iliasam/OpenTOFLidar/Mechanical/README.md

"NoMirrorConceptPictures" - Pictures showing Lidar concept without Scanning Mirror. Based on my OpenSimpleLidar mechanics.
