iliasam/OpenTOFLidar/PC_Utility/Readme.md

"LidarTestingUtility" - utility for Lidar configuration.  
Could be used in non-scanning and scanning modes.  
  
"LidarScanningTest" - utility for displaying scans from the Lidar (for scanning mode only).
  
See wiki for more information.  
  
Both utilities are written at C# in Visual Studio 2017.  
See "Debug" folder for binaries.
