iliasam/OpenTOFLidar/Mechanical/3D/Readme.txt

It is better to place cylindrical part of the "mirror holder" at the top. 
It is needed for better printing hole for the motor.
