iliasam/OpenTOFLidar/Images/distance_histogram/Readme.md

**Testing scanning measurements quality**  
All these measurements were captured with "PCB_project_v4".  
Laser voltage: 16V  
APD voltage: 130V  
Comparator : 50mv
