iliasam/OpenTOFLidar/Images/APD_voltage_vs_PWM.png

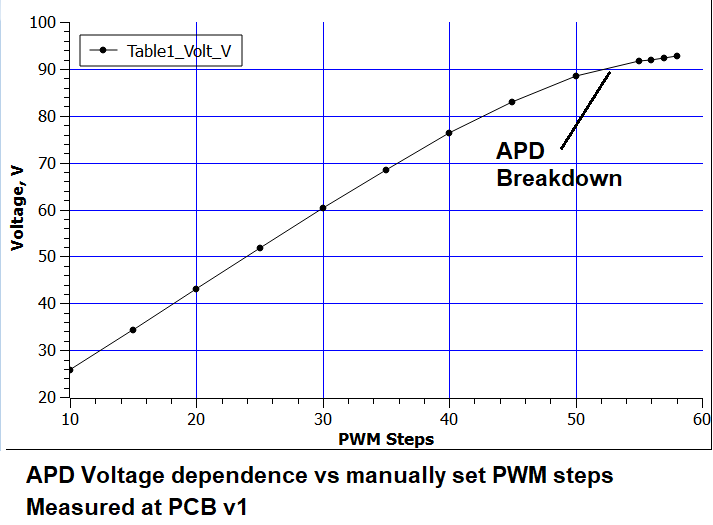
Images/APD_voltage_vs_PWM.png
