iliasam/OpenTOFLidar/Images/DataProcessing.png

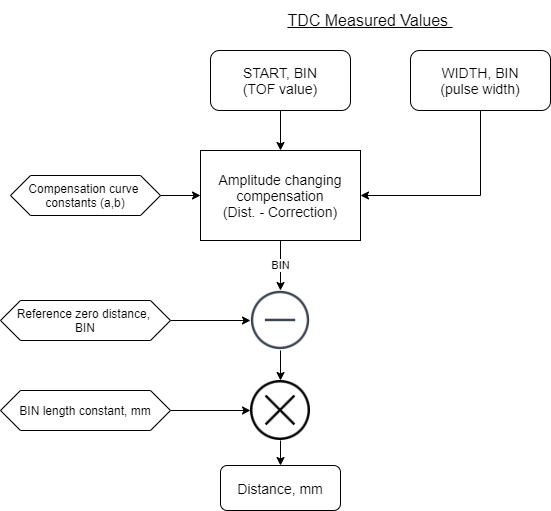
Images/DataProcessing.png
