iliasam/OpenTOFLidar/Images/distance_histogram/A1_10m.png

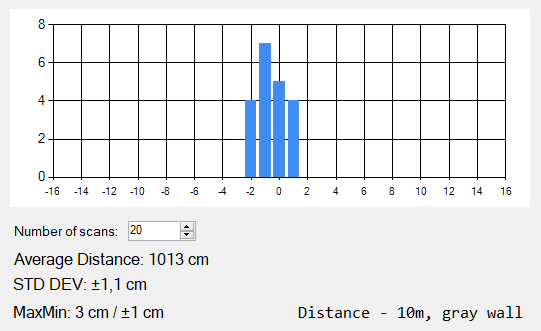
Images/distance_histogram/A1_10m.png
