iliasam/OpenTOFLidar/Images/distance_histogram/A2_20m.png

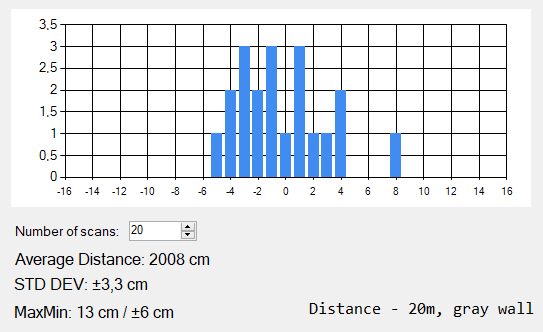
Images/distance_histogram/A2_20m.png
