iliasam/OpenTOFLidar/Images/distance_histogram/A3_25m.png

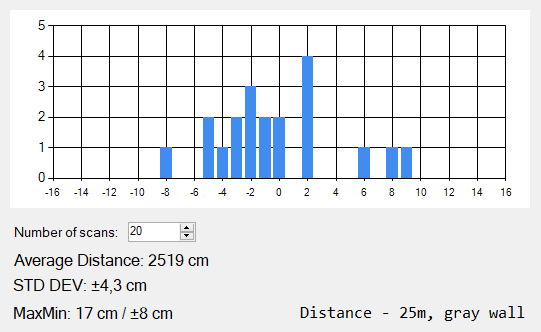
Images/distance_histogram/A3_25m.png
