iliasam/OpenTOFLidar/Images/distance_histogram/A4_27m.png

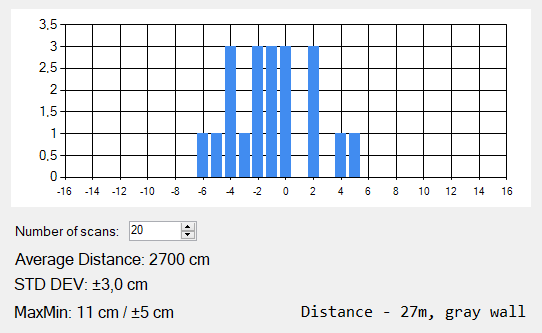
Images/distance_histogram/A4_27m.png
