iliasam/OpenTOFLidar/Images/distance_histogram/A6_30m.png

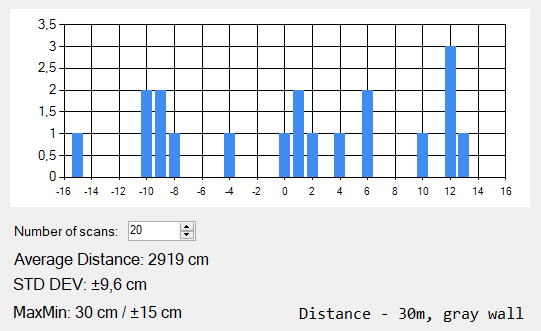
Images/distance_histogram/A6_30m.png
