iliasam/OpenTOFLidar/Images/distance_histogram/A9_13m.png

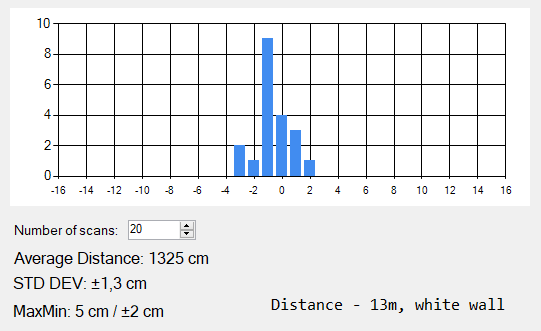
Images/distance_histogram/A9_13m.png
