iliasam/OpenTOFLidar/Images/NoiseLevel.png

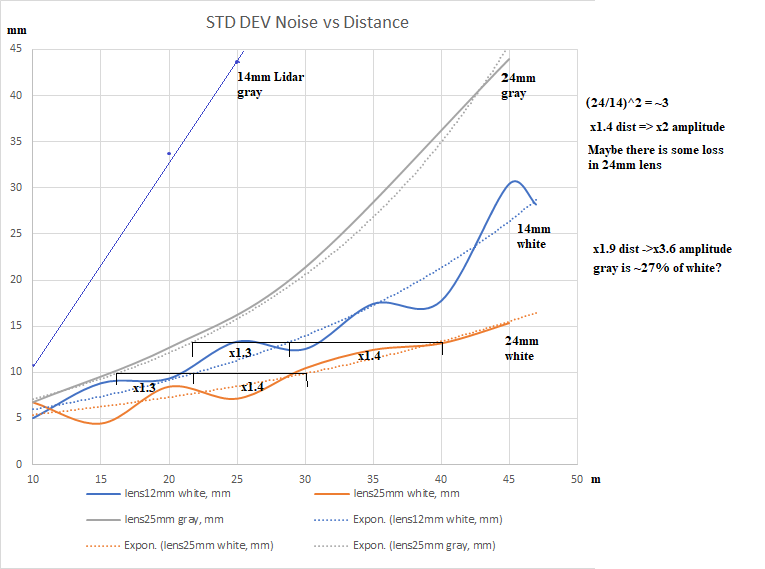
Images/NoiseLevel.png
