iliasam/OpenTOFLidar/Images/Oscilloscope/laser_transistor_gate.png

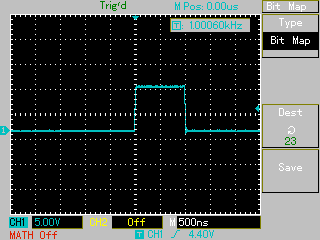
Images/Oscilloscope/laser_transistor_gate.png
