iliasam/OpenTOFLidar/Images/Oscilloscope/laser_transistor_source.png

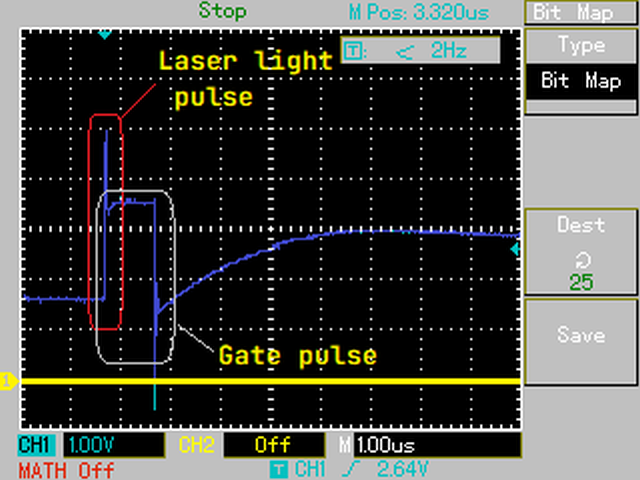
Images/Oscilloscope/laser_transistor_source.png
