iliasam/OpenTOFLidar/Images/Oscilloscope/LaserCurrent.png

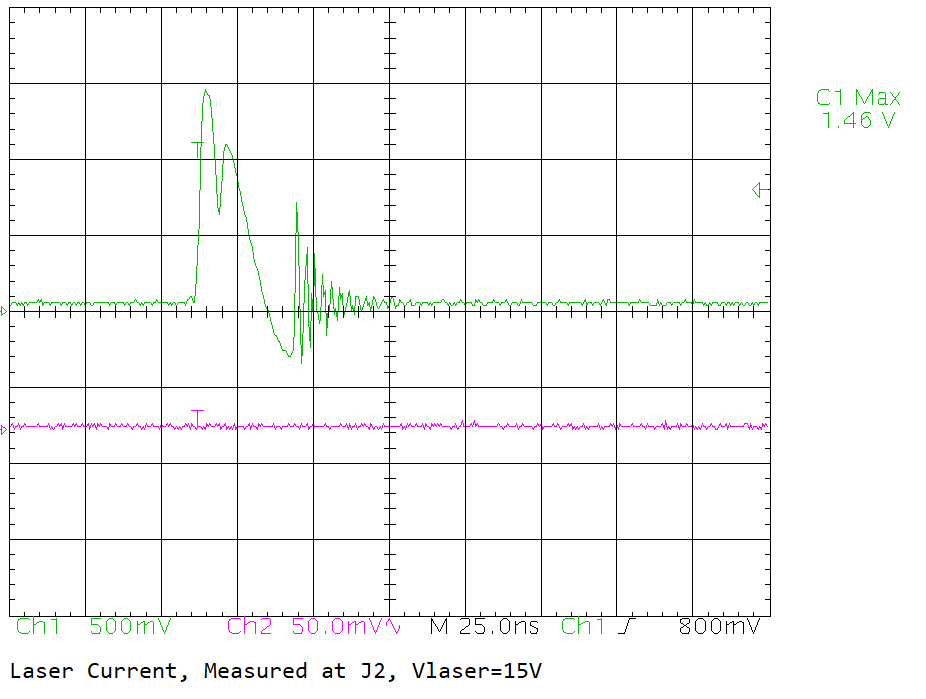
Images/Oscilloscope/LaserCurrent.png
