iliasam/OpenTOFLidar/Images/Oscilloscope/LaserCurrent/LaserV_10V.gif

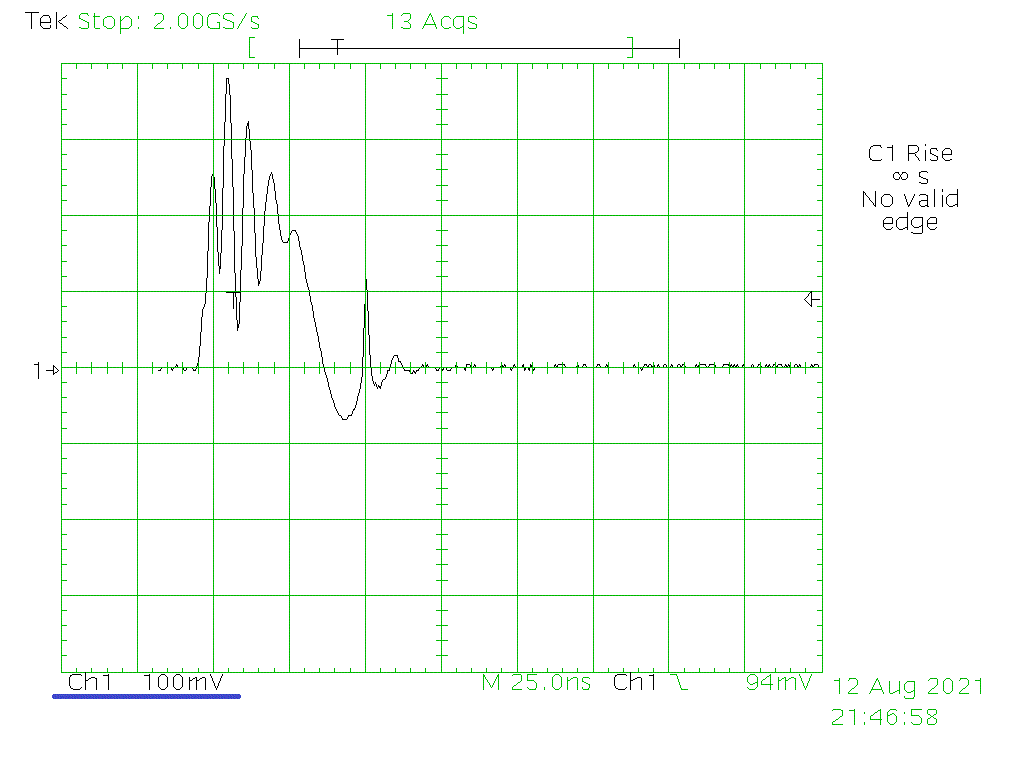
Images/Oscilloscope/LaserCurrent/LaserV_10V.gif
