iliasam/OpenTOFLidar/Images/Oscilloscope/LaserCurrent/LaserV_12V.gif

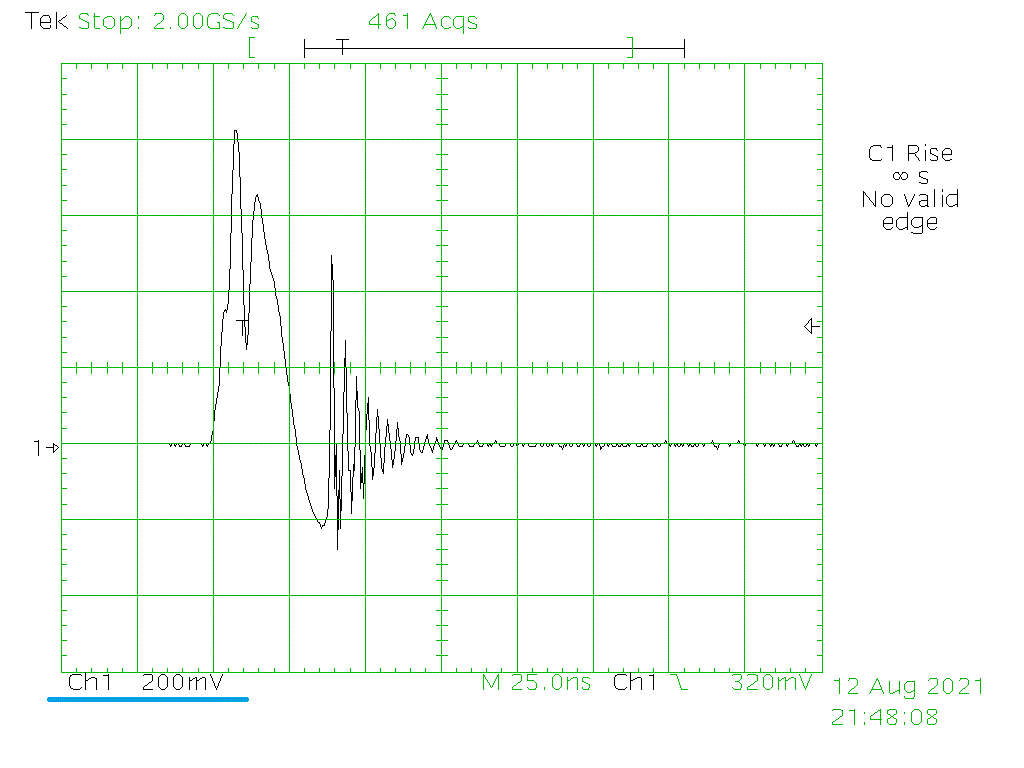
Images/Oscilloscope/LaserCurrent/LaserV_12V.gif
