iliasam/OpenTOFLidar/Images/Oscilloscope/LaserCurrent/LaserV_14V.gif

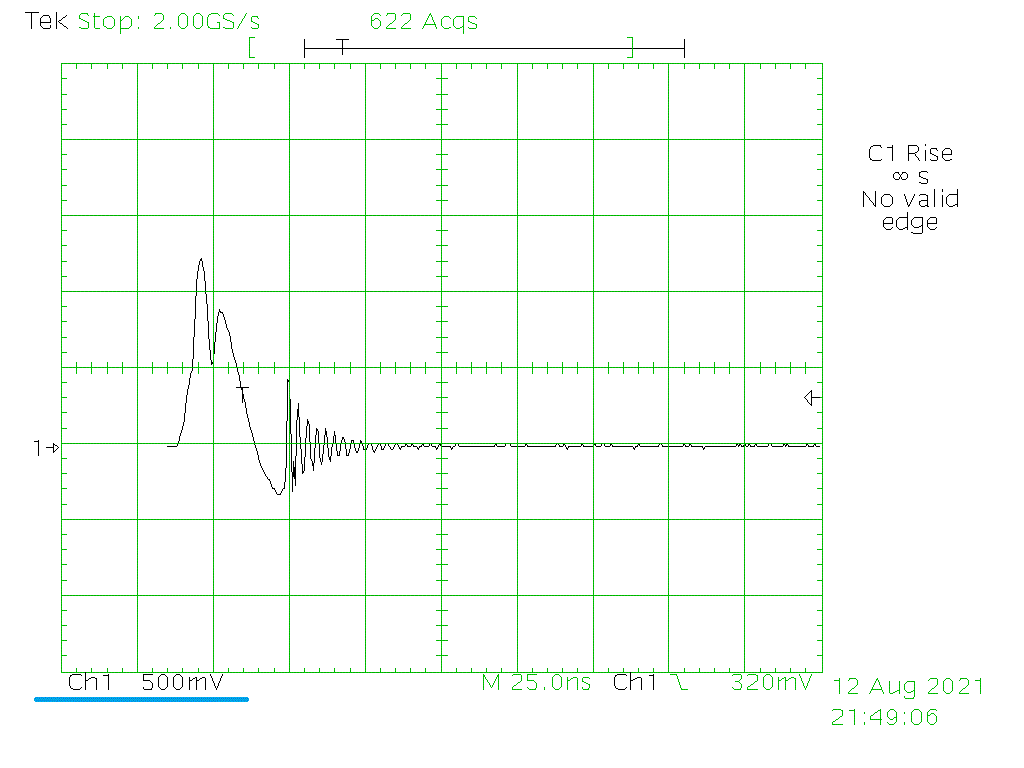
Images/Oscilloscope/LaserCurrent/LaserV_14V.gif
