iliasam/OpenTOFLidar/Images/Oscilloscope/LaserSignal.png

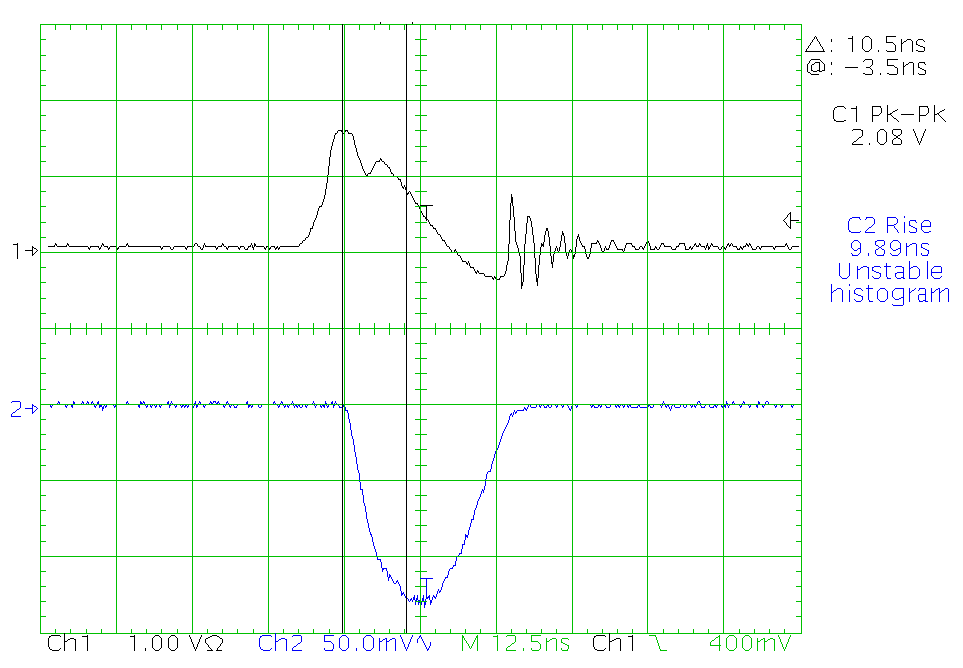
Images/Oscilloscope/LaserSignal.png
