iliasam/OpenTOFLidar/Images/Oscilloscope/ProbeCompare/DSO 015.BMP

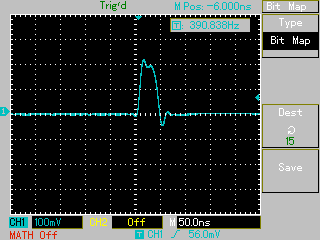
Images/Oscilloscope/ProbeCompare/DSO 015.BMP
