iliasam/OpenTOFLidar/Images/Oscilloscope/ProbeCompare/DSO 016.BMP

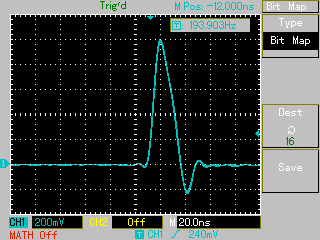
Images/Oscilloscope/ProbeCompare/DSO 016.BMP
