iliasam/OpenTOFLidar/Images/Oscilloscope/ProbeCompare/TEK00012.gif

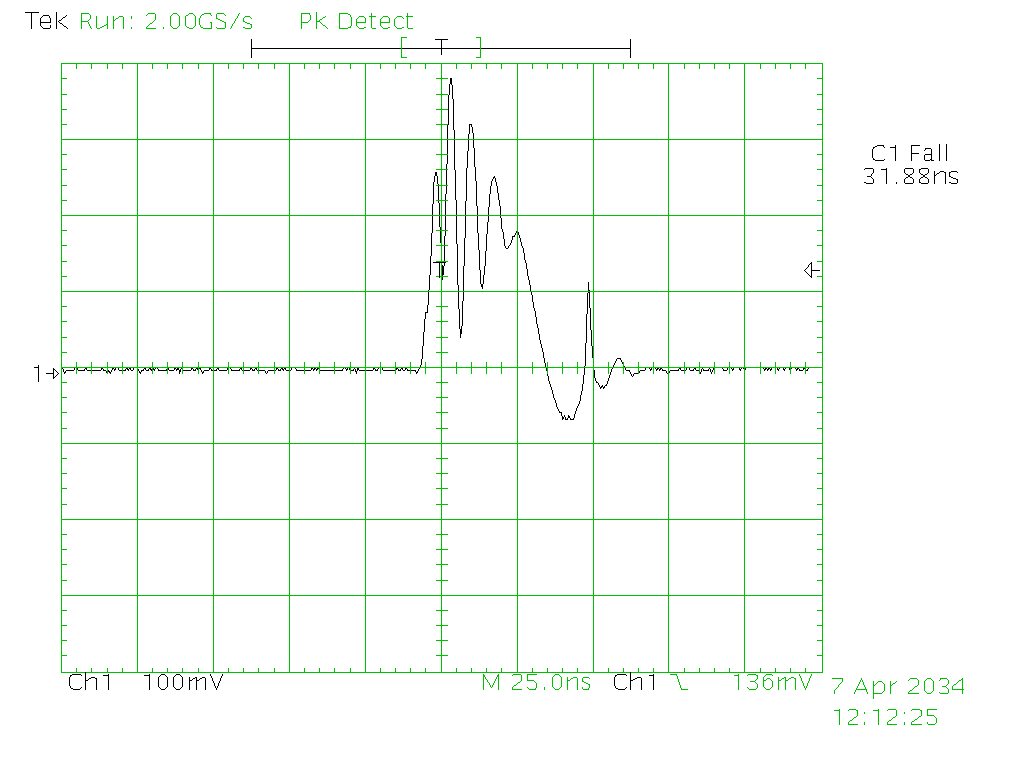
Images/Oscilloscope/ProbeCompare/TEK00012.gif
