iliasam/OpenTOFLidar/Images/Oscilloscope/ProbeCompare/TEK00013.gif

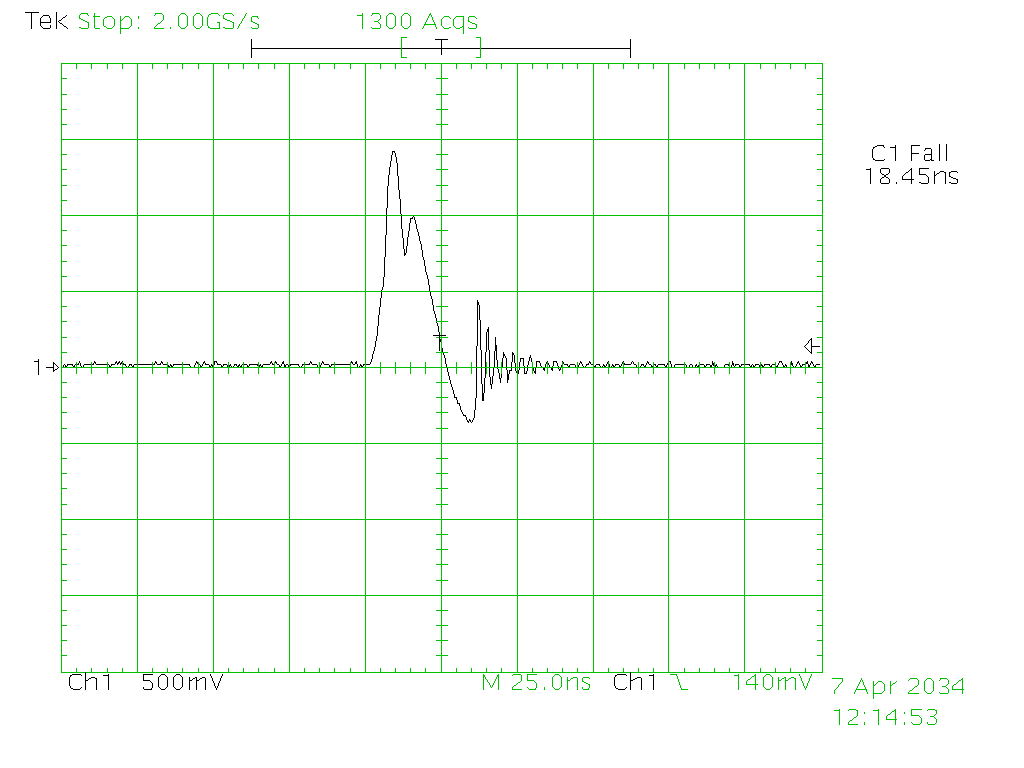
Images/Oscilloscope/ProbeCompare/TEK00013.gif
