iliasam/OpenTOFLidar/Images/Oscilloscope/ProbeCompare/TEK00014.gif

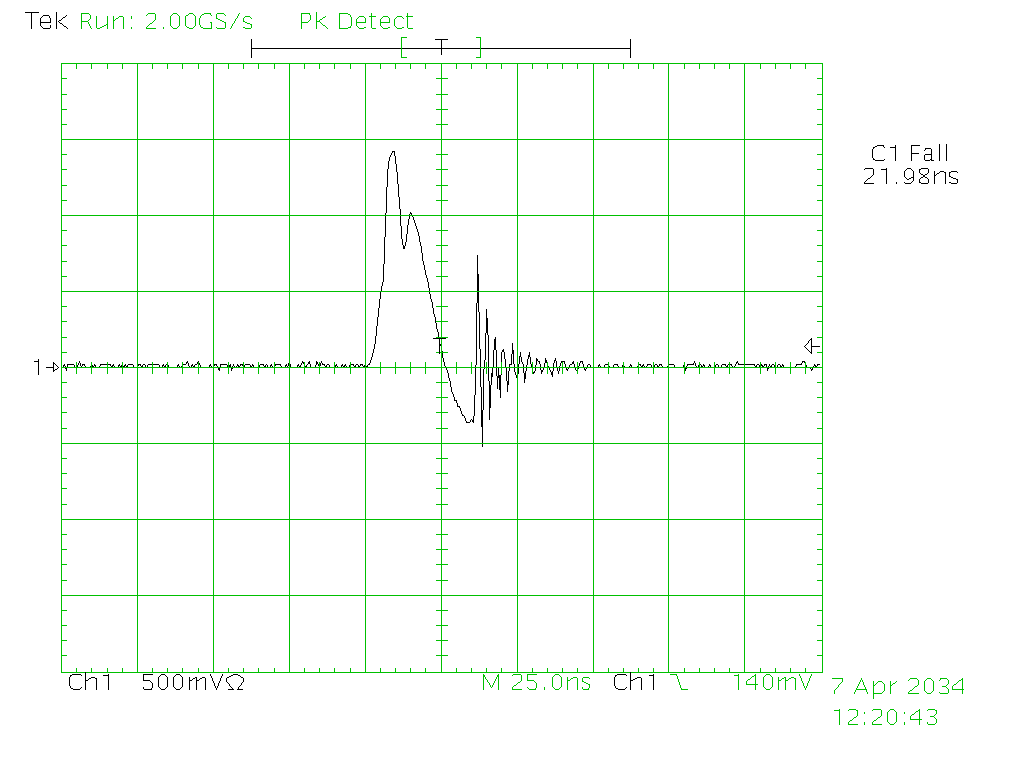
Images/Oscilloscope/ProbeCompare/TEK00014.gif
