iliasam/OpenTOFLidar/Mechanical/Drawing1.png

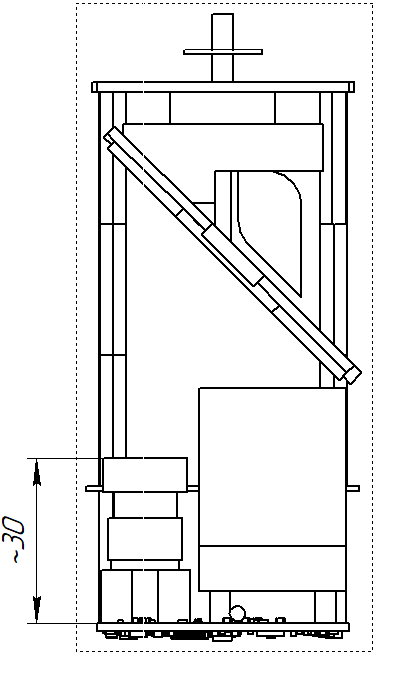
Mechanical/Drawing1.png
