iliasam/OpenTOFLidar/Mechanical/Mirror/mirror_drawing.png

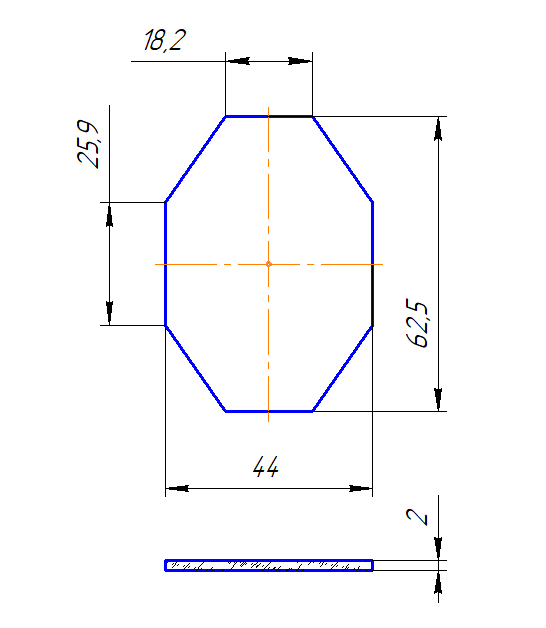
Mechanical/Mirror/mirror_drawing.png
