iliasam/OpenTOFLidar/Mechanical/MotorPlate/Drawing_motor_plate.png

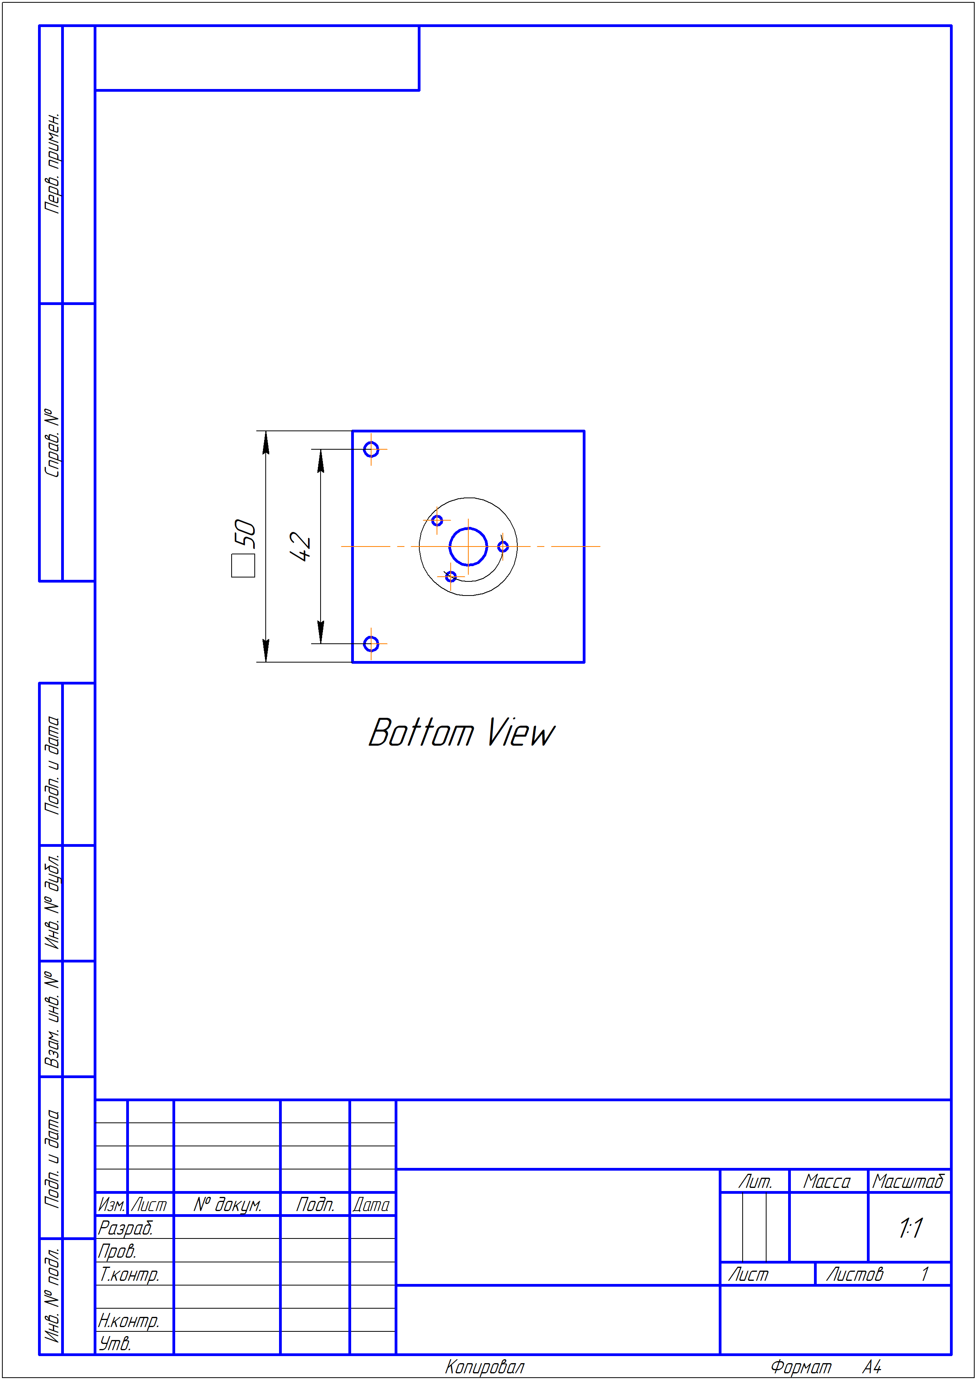
Mechanical/MotorPlate/Drawing_motor_plate.png
