iliasam/OpenTOFLidar/Mechanical/NoMirrorConceptPictures/pict1.png

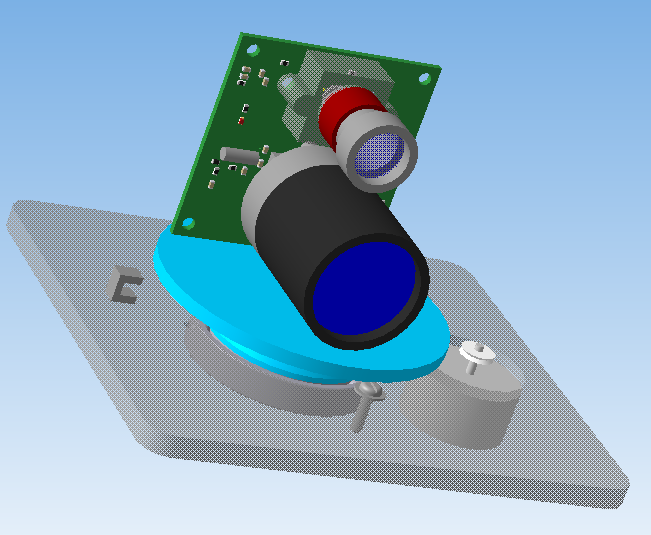
Mechanical/NoMirrorConceptPictures/pict1.png
