iliasam/OpenTOFLidar/Mechanical/NoMirrorConceptPictures/pict2.png

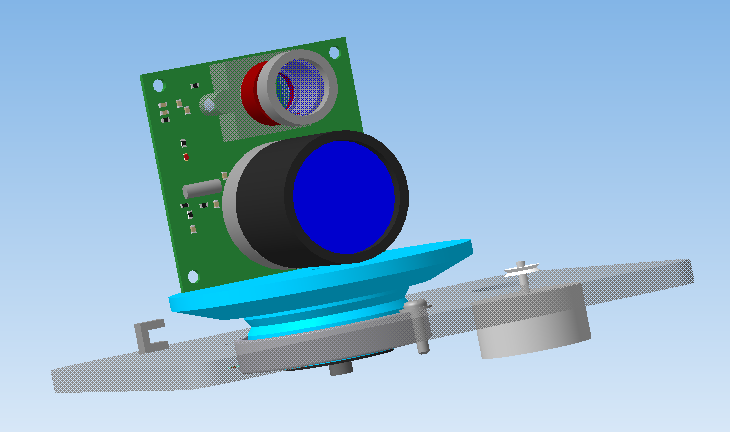
Mechanical/NoMirrorConceptPictures/pict2.png
