iliasam/OpenTOFLidar/Mechanical/NoMirrorConceptPictures/pict3.png

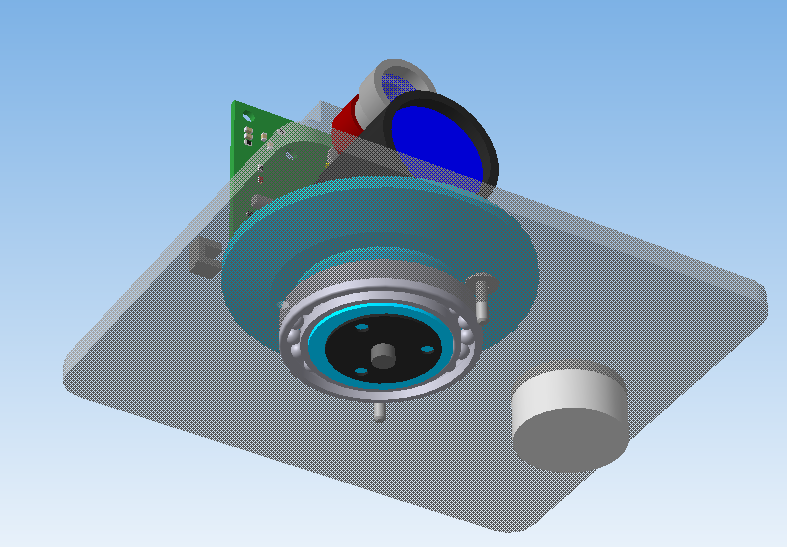
Mechanical/NoMirrorConceptPictures/pict3.png
