iliasam/OpenTOFLidar/Mechanical/NoMirrorConceptPictures/pict4.png

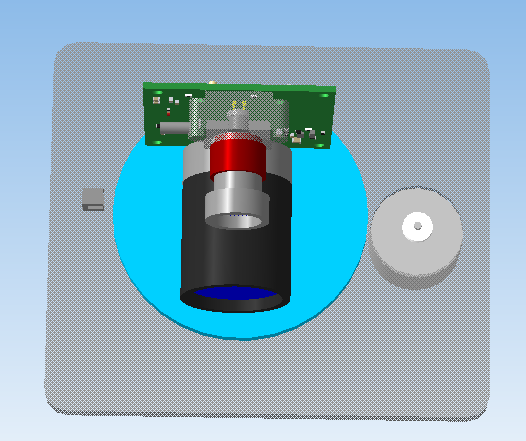
Mechanical/NoMirrorConceptPictures/pict4.png
