iliasam/OpenTOFLidar/Mechanical/RenderPicture1.png

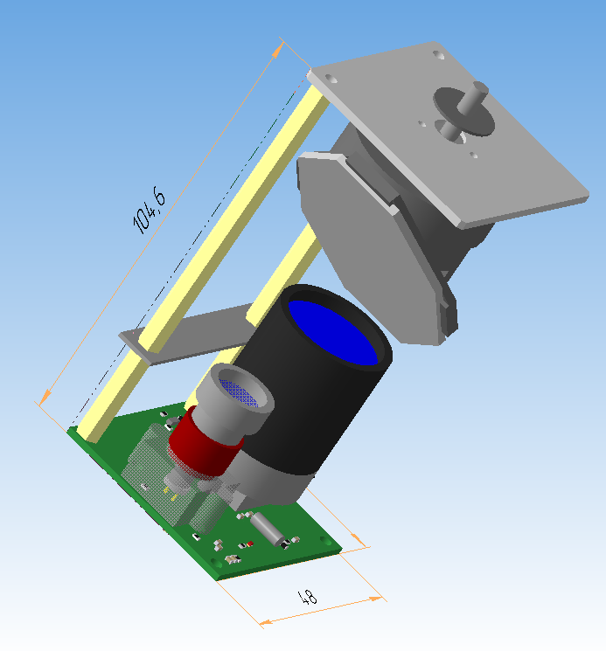
Mechanical/RenderPicture1.png
