iliasam/OpenTOFLidar/Mechanical/RenderPicture2.png

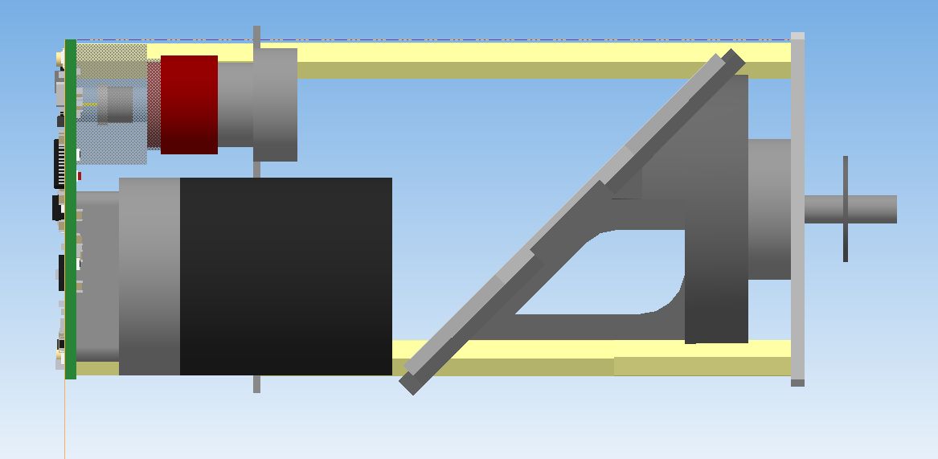
Mechanical/RenderPicture2.png
