iliasam/OpenTOFLidar/Mechanical/RenderPicture3.png

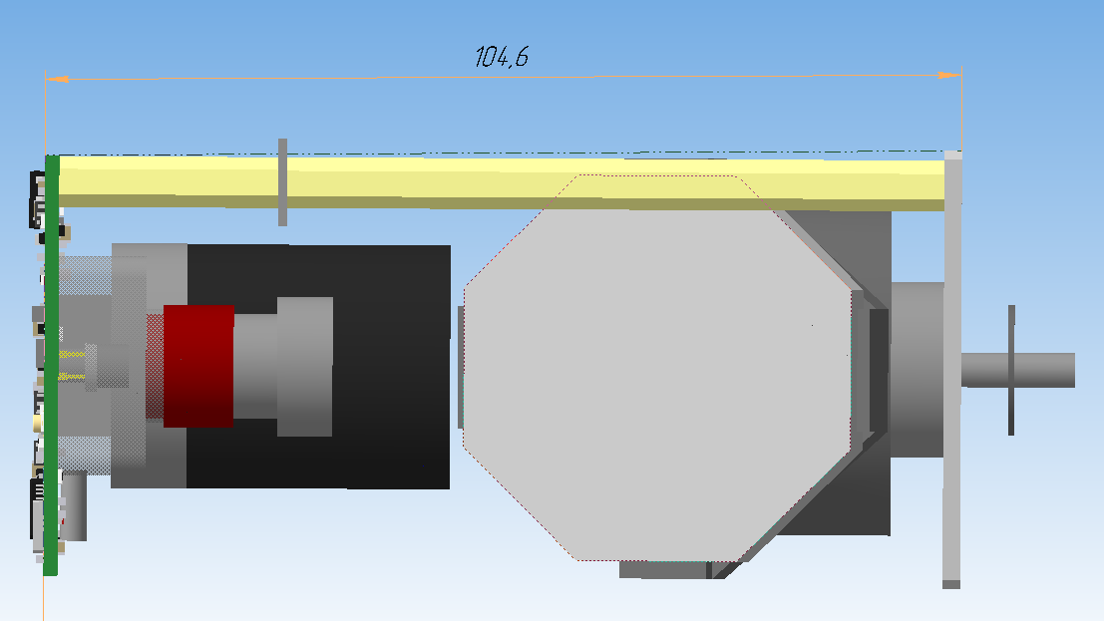
Mechanical/RenderPicture3.png
