iliasam/OpenTOFLidar/Mechanical/RenderPicture4.png

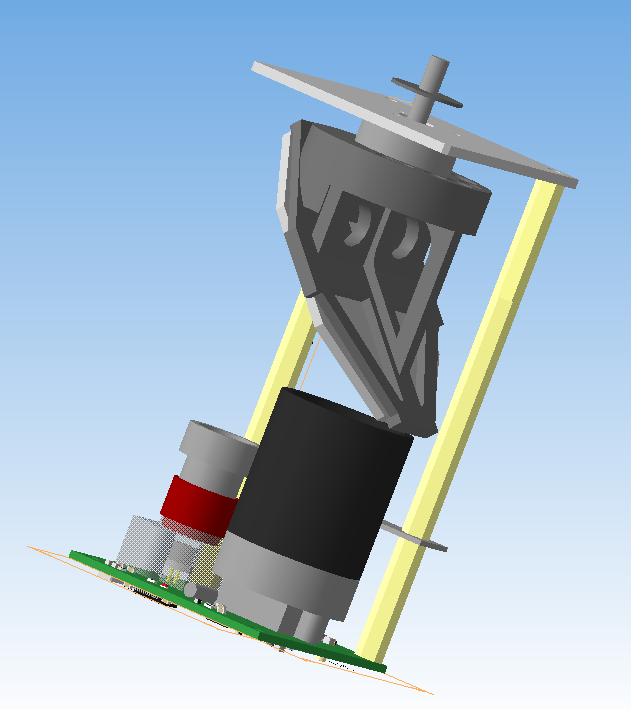
Mechanical/RenderPicture4.png
