iliasam/OpenTOFLidar/Mechanical/RenderPicture5.png

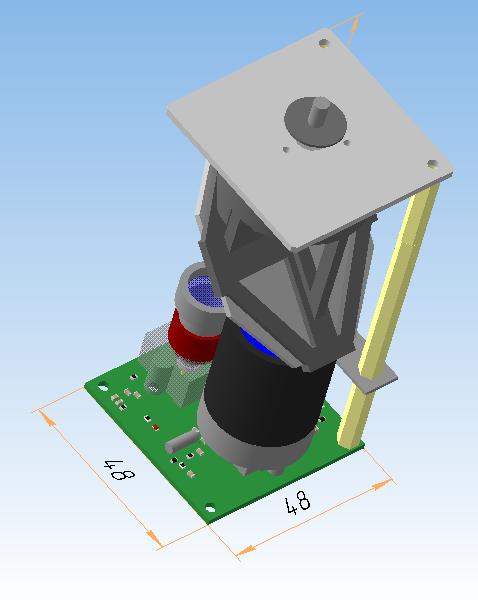
Mechanical/RenderPicture5.png
