iliasam/OpenTOFLidar/PC_Utility/scanning_utility_screen.png

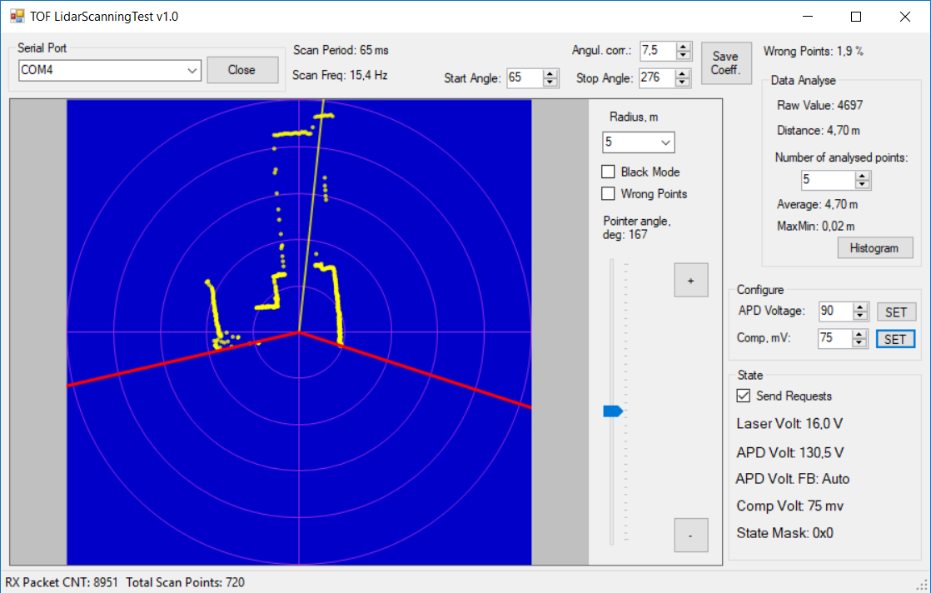
PC_Utility/scanning_utility_screen.png
