iliasam/OpenTOFLidar/PCB/PCB_project_v4/PCB_3D_view_down.png

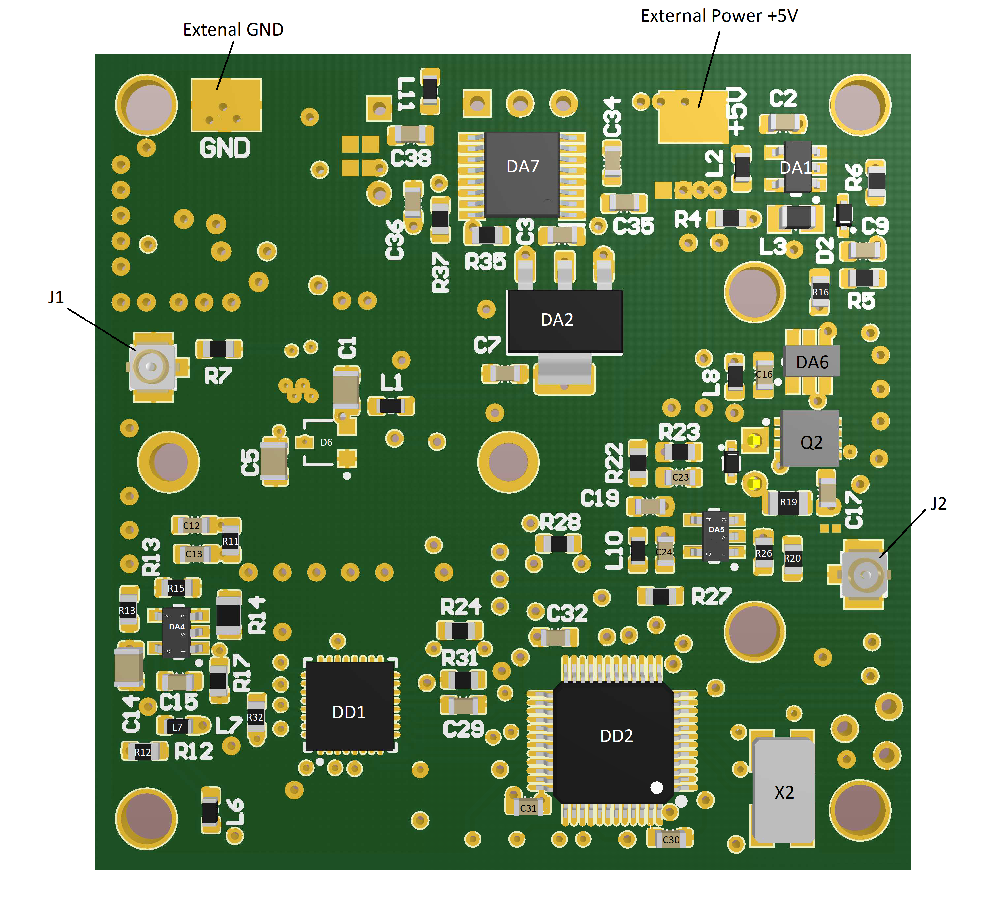
PCB/PCB_project_v4/PCB_3D_view_down.png
