iliasam/OpenTOFLidar/PCB/PCB_project_v4/Schematic_v4b.png

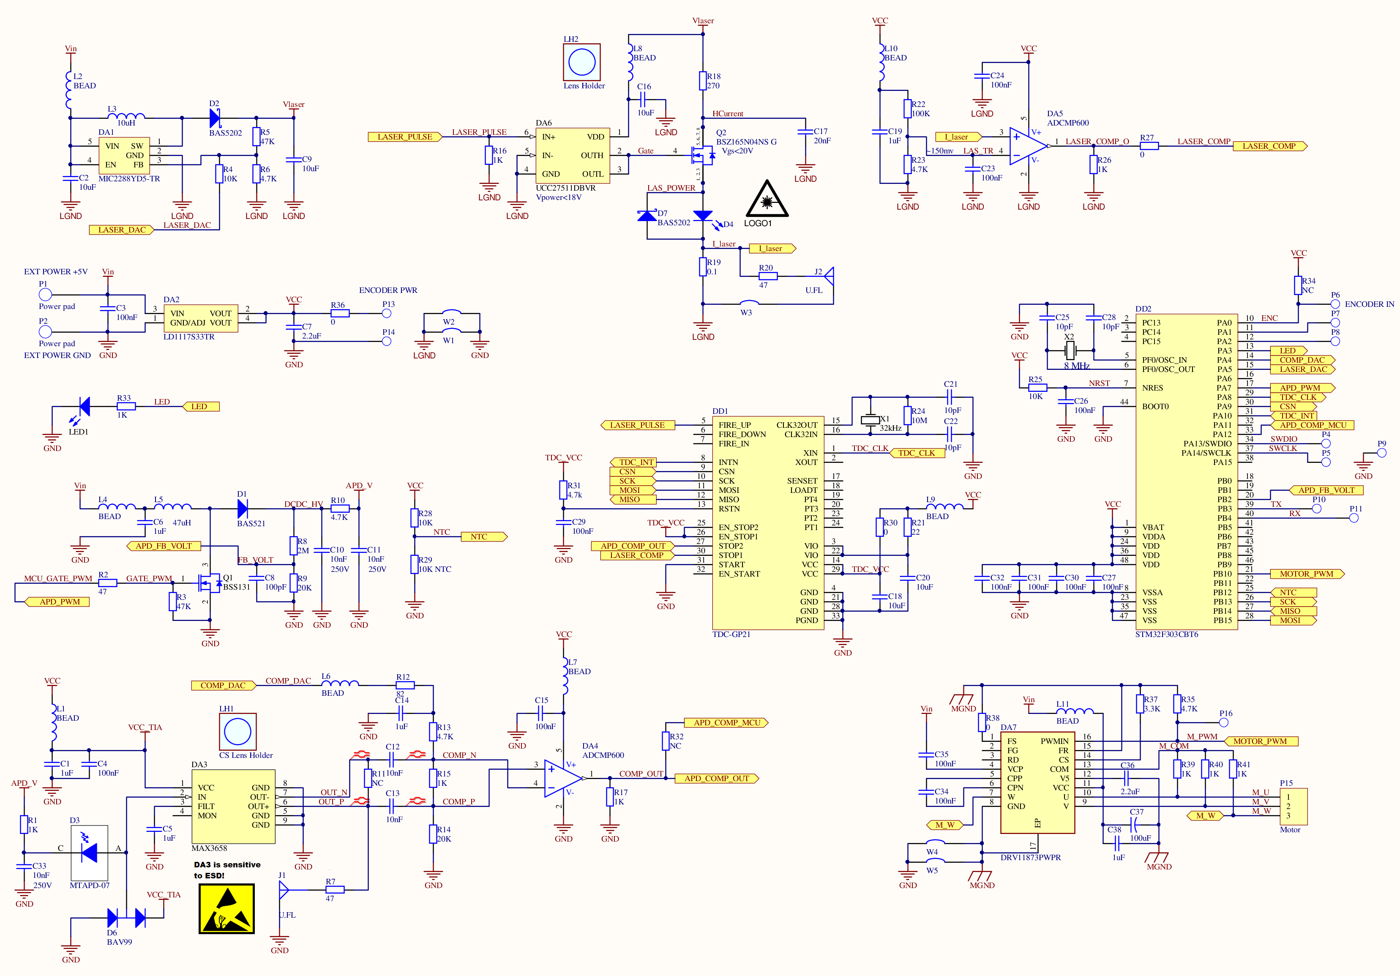
PCB/PCB_project_v4/Schematic_v4b.png
