iliasam/OpenTOFLidar/LidarTotalBOM.xlsx

 | No. | Name | Retail Price | Description | URL
PCB components | 1 | AD500-8 | $17.00 | Chinese Avalanche photodiode (proved in real device), TO-52 package. Original photodiode costs $180 at Mouser | https://aliexpress.com/item/1298052194.html | See other variants below!
 | 2 | SPL PL90_3 | $12.00 | Pulsed Laser Diode | https://aliexpress.com/item/2042300175.html
 | 3 | MAX3658 | $3.00 | Transimpedance Amplifier | https://aliexpress.com/item/1005001355561750.html
 |  |  |  | (14$ for 5 pcs) | https://www.ebay.com/itm/5PCS-MAX3658AETA-T-IC-AMP-TRANSIMPEDANCE-8-TDFN-MAX3658-3658-MAX3658A-3658A-MAX3/192826918497
 | 4 | ADCMP600 x 2 | $9.40 | Fast Comparator, two IC | https://www.digikey.com/product-detail/en/analog-devices-inc/ADCMP600BKSZ-REEL7/ADCMP600BKSZ-REEL7CT-ND/1246113
 | 5 | UCC27511DBVR | $1.50 | Mosfet Driver | https://www.digikey.com/product-detail/en/texas-instruments/UCC27511DBVR/296-30285-1-ND/3060762
 | 6 | TDC-GP21 | $7.00 | Time-to-Digital converter IC | https://www.ebay.com/itm/1pcs-TDC-GP21-GP21-new/292575333067
 | 7 | STM32F303CBT6 | $5.20 | MCU | https://www.digikey.com/product-detail/en/stmicroelectronics/STM32F303CBT6/497-17421-ND/4357226
 | 8 | DRV11873PWPR | $3.50 | DLDC driver DRV11873 | https://ru.mouser.com/ProductDetail/Texas-Instruments/DRV11873PWPR
 |  |  |  | DLDC driver DRV11873 (China, 1$) | https://aliexpress.com/item/33010069942.html
 | 9 | BSZ165N04NS G | $1.30 | Fast MOSFET | https://ru.mouser.com/ProductDetail/Infineon-Technologies/BSZ165N04NSGATMA1
 | 10 | Additional PCB components | $7.00
 | 11 | PCB Itself | $2.00 | 4 Layer PCB, price for 5 boards (<50x50mm) | https://jlcpcb.com
 | 12 | Photodiode Lens | $9.00 | Lens, CS mount, 25mm focal length, F1.2 | https://aliexpress.com/item/32303375838.html
 | 13 | CS lens holder | $2.00 | Holder for CS lens 20mm Hole Spacing | https://aliexpress.com/item/33025418983.html | Original link is not working
 | 14 | BLDC motor | $2.00 | BLDC, outrunner, 20mm diameter, KV > 200 | https://aliexpress.com/item/4000323714513.html
 | 15 | Scanning Mirror | $3.00 | Customized shape, Alum, front surface mirror (12$ for 4 mirrors) | https://aliexpress.com/item/4000978583350.html | Original link is not working. Orig. seller is "Ruite Professional Optical Trading Co"
 | 16 | Stand-offs | $3.50 | 25mm M3 Hex Stand-off x 8, price for 20pcs
 | 17 | Laser lens | $7.00 | 25mm M12 F2.0 lens (Free delivery) | https://aliexpress.com/item/32913215547.html
 | 18 | Laser lens holder | $3.00 | Plastic holder, 10mm height, 20mm hole distance (price for 10pcs) | https://aliexpress.com/item/32953675441.html
 | 19 | M12 lens adapter | $1.00 | Price for 1pcs | https://aliexpress.com/item/32962439240.html
 |  |  | $99.40 | Note - this total price is calculated without delivery price
 |  |  | $68.90 | PCB components including PCB, without delivery
 | _1_ | [China APD TO-46 and SMD] | 17-25 | Chinese Avalanche photodiode NOT proved. Has IR filter modification | https://aliexpress.com/item/4001095035399.html
 | _1_ | [AD500-9 TO52S1F2] | $27.00 | Chinese Avalanche photodiode (NOT proved but similar to AD500-8), TO-52 package, interated interference filter | https://aliexpress.com/item/32735300921.html (https://aliexpress.ru/item/32735300921.html)
 | _1_ | [MTAPD-07-013] | $23.65 | Original Avalanche photodiode (proved), 3-LCC package | https://www.digikey.com/products/en?keywords=MTAPD-07-013
 |  | Interference Filter | $8.00 | Optional Interference Filter, 905 +-10nm | https://www.ebay.com/itm/Optical-Filter-905nm-band-pass-filter-895nm-915nm-Dia-11-5mm/262976990433
 |  | Interference Filter | $13.00 | Optional Interference Filter, 905 +-5nm, Free delivery | https://aliexpress.com/item/32963619780.html (https://aliexpress.ru/item/32963619780.html)
Updated 06/2022
