iliasam/OpenTOFLidar/Mechanical/3D/mirror_holder.stl

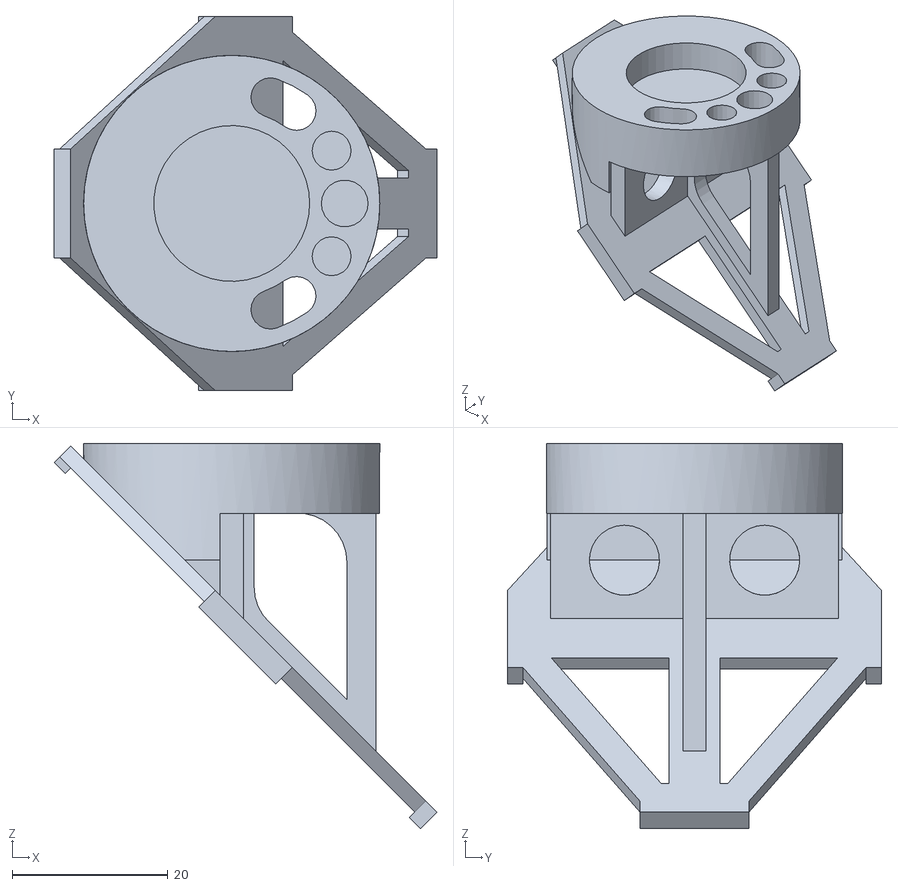
[picture p42: CAD file, 2020-01-12]
Mechanical/3D/mirror_holder.stl
49.1 x 48.0 x 49.5
