iliasam/OpenTOFLidar/(list of files, cad)

Other CAD files:
Mechanical/Mirror/mirror_drawing.dwg
Mechanical/MotorPlate/Drawing_motor_plate.dxf
