iliasam/OpenTOFLidar/Images/Oscilloscope/NoOpticsTest/Readme.txt

All images are collected without optics installed. Distance is 1.7m, white object.
CH1 - laser current at J2 connector
CH2 - TIA positive output, J1 connector.

TEK0017 - 15V laser / 52v APD
TEK0018 - 15V laser / 84v APD
TEK0019 - 15V laser / 84v APD - oscilloscope in DPO mode
TEK0020 - 15V laser / 84v APD - oscilloscope 50 mv/div CH2
