iliasam/OpenTOFLidar/PC_Utility/LidarTestingUtility/bin/Debug/result_2019-12-31 18-42-27.csv

POS | POS_STD_DEV | POS_DIFF | WIDTH | WIDTH_STD_DEV
203,85 | 2,23 | 10 | 239,08 | 3,20
203,04 | 2,28 | 11 | 240,14 | 3,79
202,97 | 2,44 | 11 | 240,50 | 3,42
196,10 | 13,11 | 54 | 261,06 | 33,27
188,45 | 1,34 | 7 | 276,69 | 2,39
188,09 | 1,29 | 6 | 276,90 | 2,49
188,31 | 1,10 | 5 | 277,10 | 2,37
184,43 | 1,04 | 4 | 288,75 | 2,19
179,51 | 0,85 | 4 | 305,33 | 1,73
179,50 | 0,86 | 3 | 305,37 | 1,52
179,41 | 0,80 | 3 | 305,41 | 1,90
179,44 | 0,75 | 3 | 305,74 | 1,98
176,98 | 1,17 | 3 | 315,38 | 2,05
316,99 | 1,00 | 1 | 317,00 | 0,00
316,98 | 0,99 | 1 | 317,00 | 0,00
317,00 | 0,00 | 0 | 317,00 | 0,00
316,99 | 1,00 | 1 | 317,00 | 0,00
316,99 | 1,00 | 1 | 317,00 | 0,00
317,00 | 0,00 | 0 | 317,00 | 0,00
316,99 | 1,00 | 1 | 317,00 | 0,00
317,00 | 0,00 | 0 | 317,00 | 0,00
316,99 | 1,00 | 1 | 317,00 | 0,00
176,71 | 0,92 | 2 | 317,17 | 2,10
174,65 | 0,88 | 4 | 330,88 | 2,91
173,87 | 0,99 | 4 | 338,32 | 3,39
172,98 | 0,99 | 1 | 348,61 | 3,47
172,22 | 0,47 | 1 | 359,62 | 3,57
172,01 | 0,10 | 1 | 365,03 | 3,80
172,00 | 0,00 | 0 | 367,16 | 3,95
171,93 | 0,97 | 1 | 369,86 | 4,15
171,91 | 0,99 | 3 | 370,24 | 4,07
171,68 | 0,83 | 1 | 378,74 | 4,40
171,46 | 1,88 | 10 | 394,09 | 38,71
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
