iliasam/OpenTOFLidar/Images/no_optics_test/picture1.png

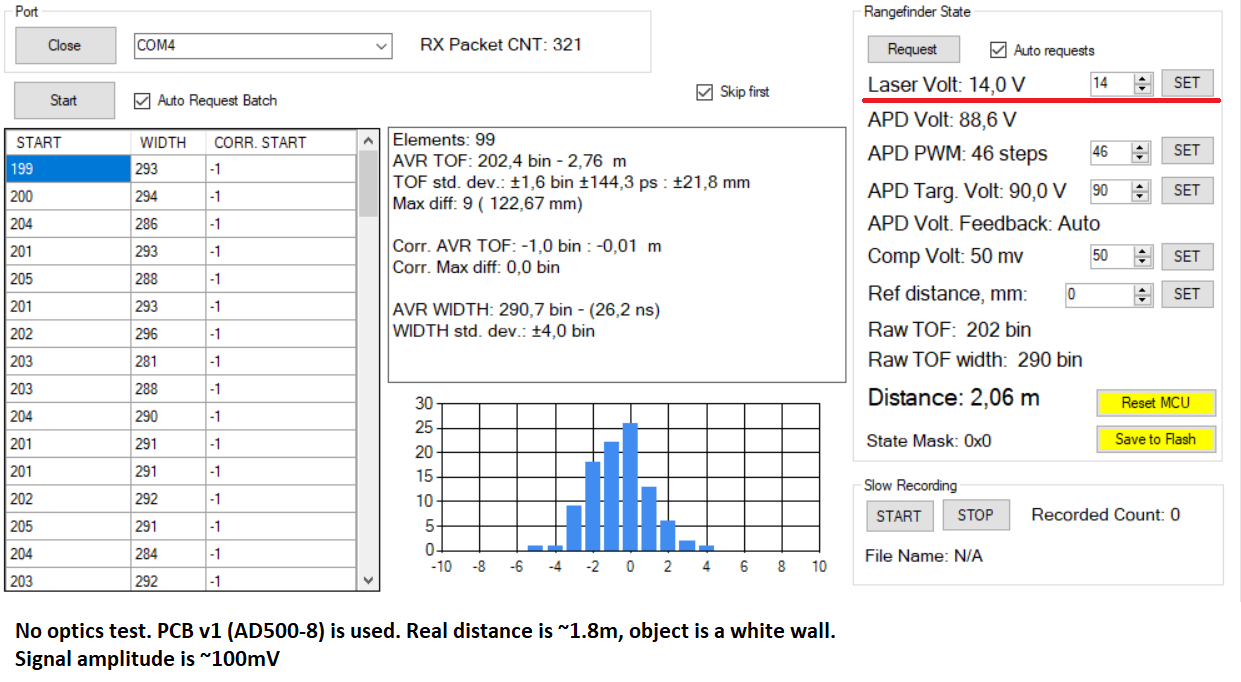
Images/no_optics_test/picture1.png
