iliasam/OpenTOFLidar/Images/no_optics_test/picture2.png

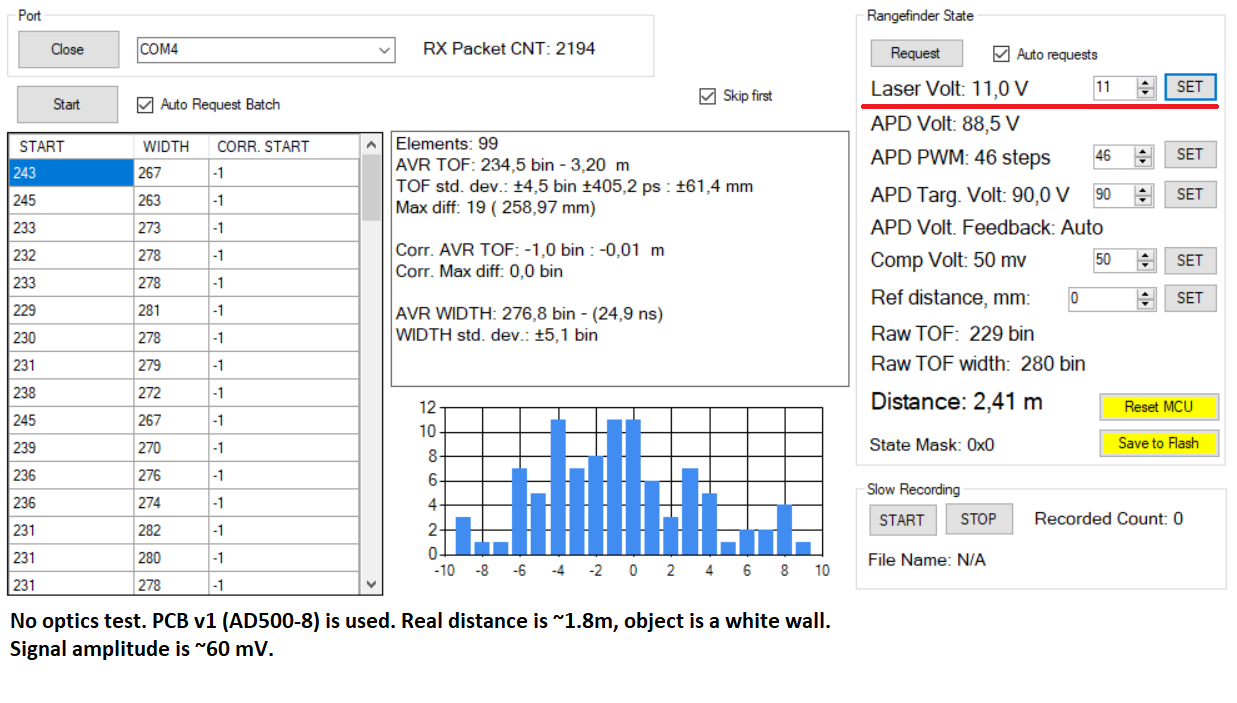
Images/no_optics_test/picture2.png
