iliasam/OpenTOFLidar/Images/no_optics_test/picture3.png

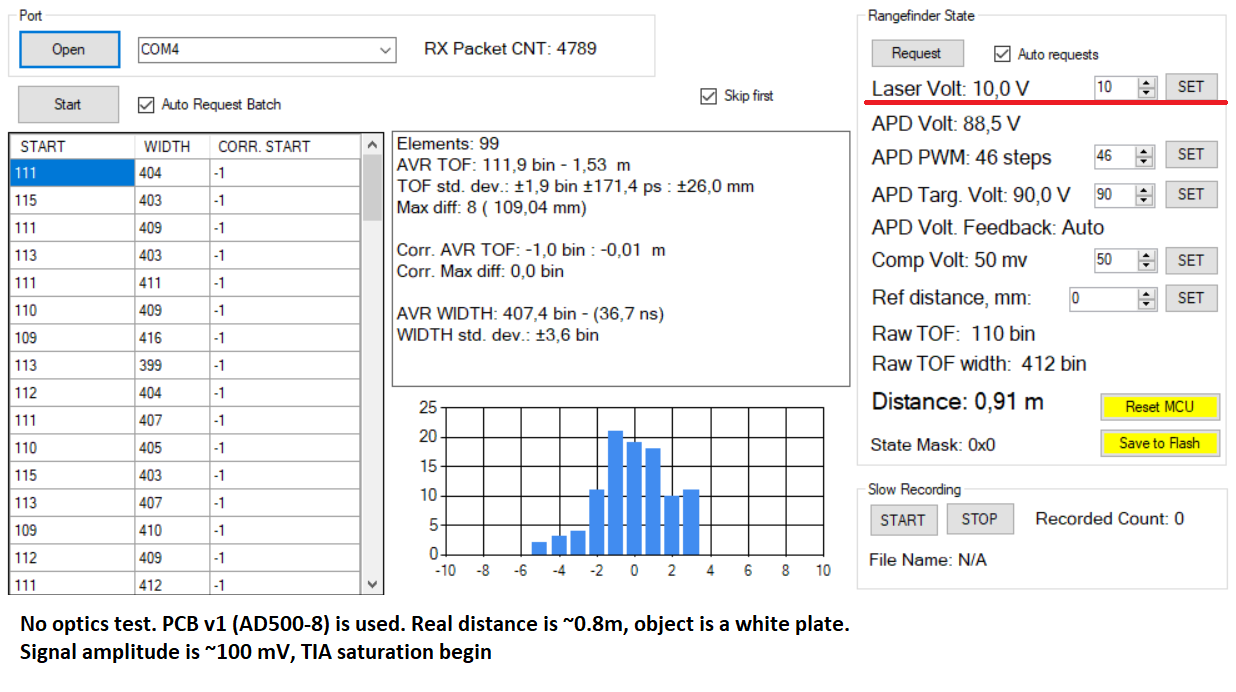
Images/no_optics_test/picture3.png
