iliasam/OpenTOFLidar/Images/Oscilloscope/NoOpticsTest/TEK00017.gif

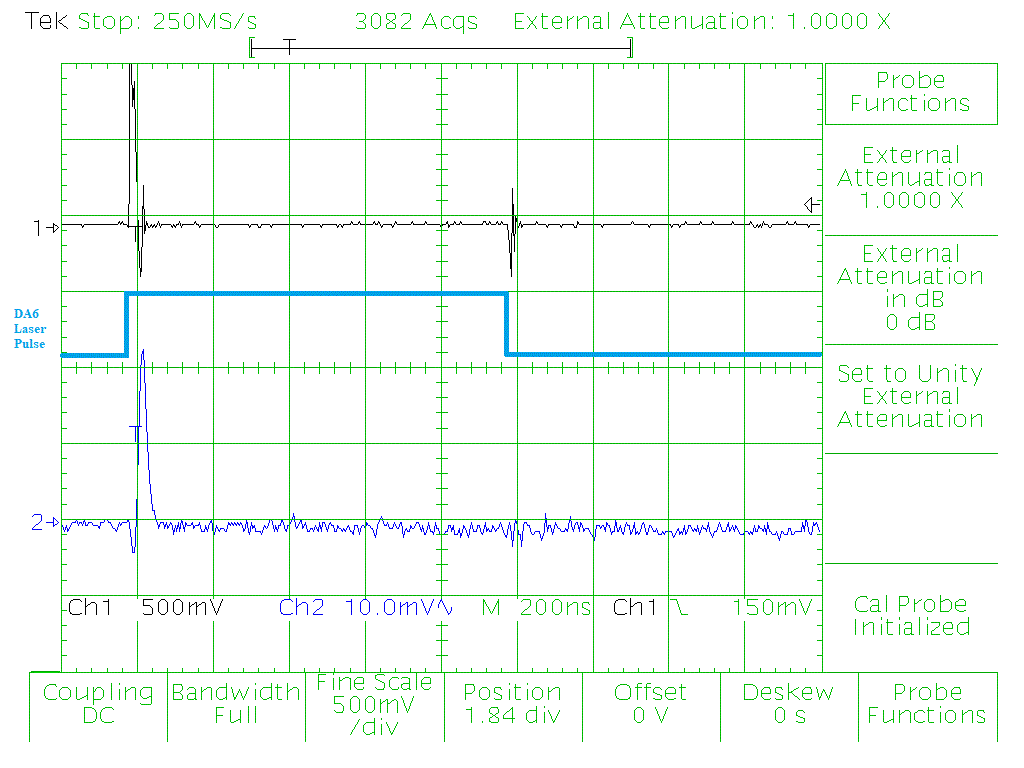
Images/Oscilloscope/NoOpticsTest/TEK00017.gif
