iliasam/OpenTOFLidar/Images/Oscilloscope/NoOpticsTest/TEK00018.gif

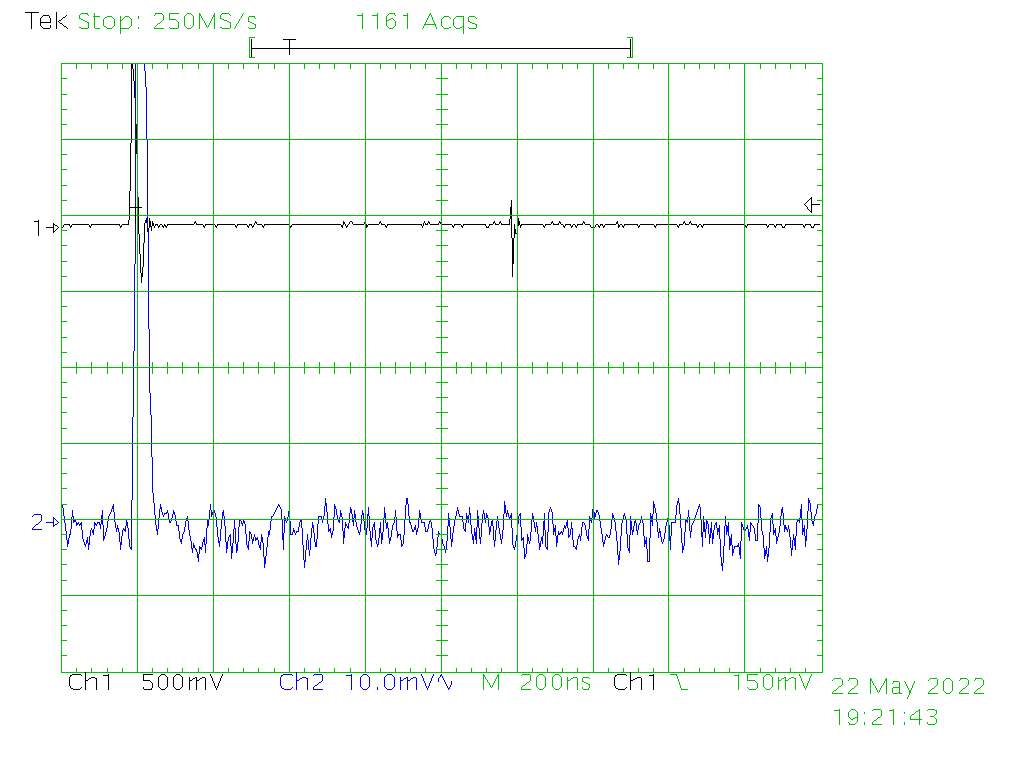
Images/Oscilloscope/NoOpticsTest/TEK00018.gif
