iliasam/OpenTOFLidar/Images/Oscilloscope/NoOpticsTest/TEK00019.gif

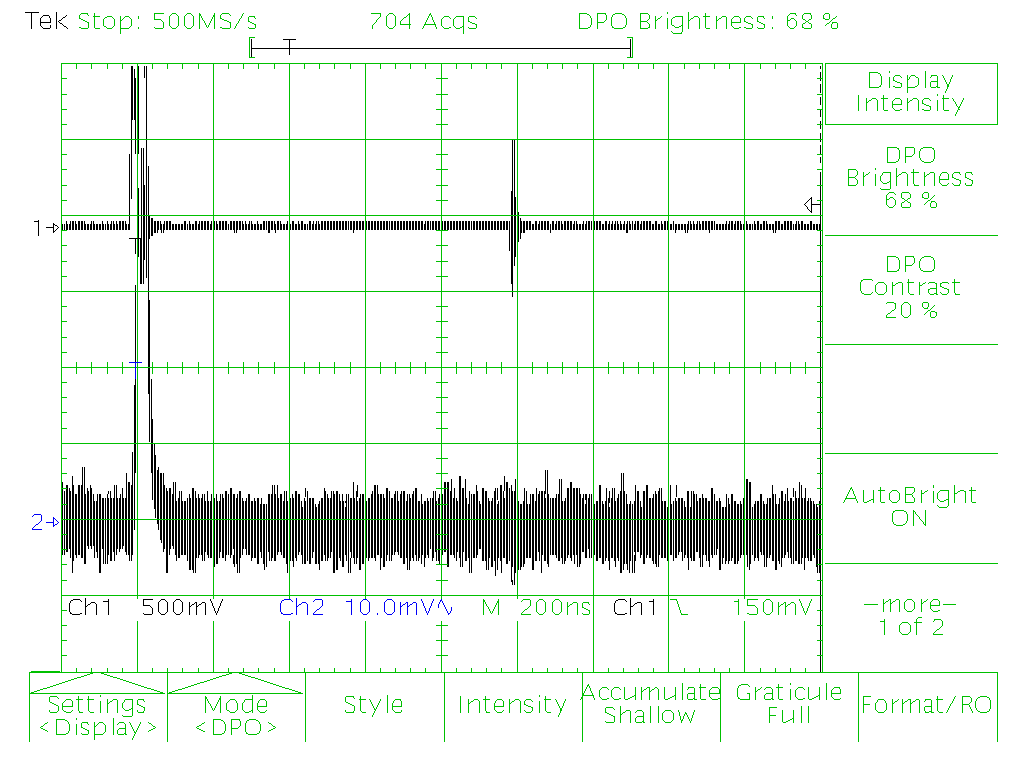
Images/Oscilloscope/NoOpticsTest/TEK00019.gif
