iliasam/OpenTOFLidar/PC_Utility/testing_utility_calib1.png

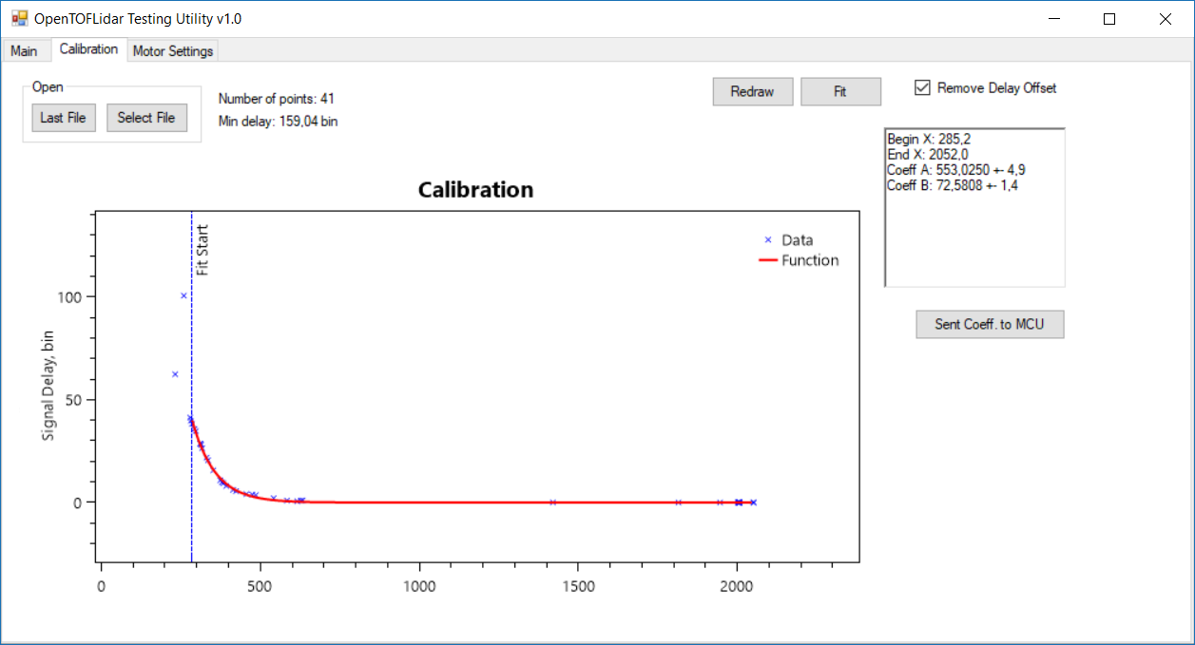
PC_Utility/testing_utility_calib1.png
