iliasam/OpenTOFLidar/PC_Utility/testing_utility_screen.png

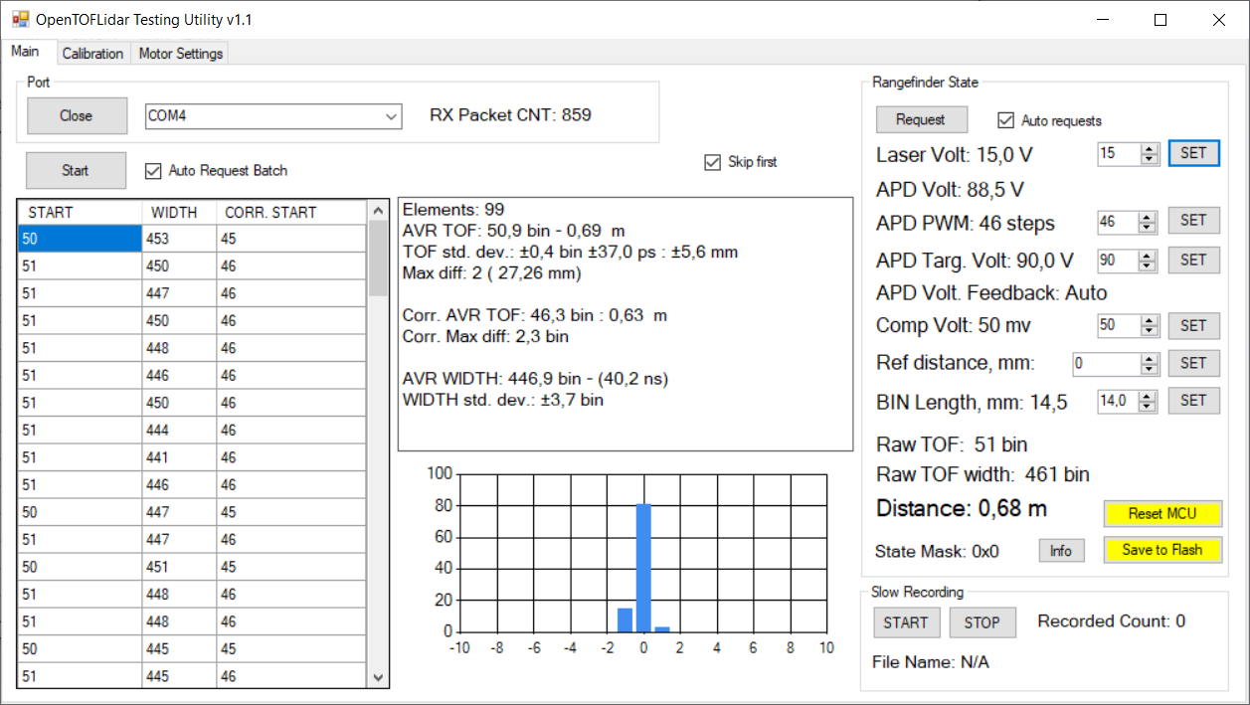
PC_Utility/testing_utility_screen.png
