iliasam/OpenTOFLidar/(threads)

Thread 1 (2020-03-23):

Designator of some components are missing in Gerber Files.

AbidHussain70, 2020-03-23:
Hi, First wanna say thanks. Very well explained and well documented.
I want to make one of these, but when I upload the gerber files it seems some of the components footprints have no designator. Can you provide a complete Gerber files. Thanks
 Below are the pictures of both versions.
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

iliasam, 2020-03-23:
You are right.
"PCB_project_v1" have less designators is Silkscreen.
"PCB_project_v4" have more designators is Silkscreen.
Also, there are special images at "PCB_project_v4" folder: "PCB_3D_view_down", "PCB_3D_view_up" with manually written designators.

AbidHussain70, 2020-03-23:
Thanks for quick response.
Yes I saw those images. I want to send the PCB to manufacturer for soldering, anyhow i will try to solder it.
I have another question, both the version v1 and v4 work fine?
I want to use v4.

iliasam, 2020-03-23:
See board differences description: https://github.com/iliasam/OpenTOFLidar/blob/develop/PCB/README.md
I'm not sure that Silkscreen marking is enough for PCB manufacturer to assemble the board.
The could ask special assembling drawing or some kind of "pick and place" file.

AbidHussain70, 2020-03-24:
I can get my PCB with these files, but they will not solder it. Because of designator issue. I will try it by myself and I will update you about the results.
Thanks

AbidHussain70, 2020-03-24:
Did you use QUARTZ_32K in "PCB_project_v4"? I saw the two images "PCB_3D_view_down" and PCB_3D_view_up" and also I check the Gerber files, but I could not find the location of the component in the PCB.

iliasam, 2020-03-24:
Be careful with WIFI in "PCB_project_v4 ". I had to install a special metallic plate between WIFI antenna and LIDAR to reduce noise from WIFI. It is not shown at photos.

Closed 2020-03-25.

Thread 3 (2020-04-29):

Compilation Error on IAR 8.40.1

AbidHussain70, 2020-04-29:
I am using encoder disc with 100 slits in it instead of 65 slits you used. I could not found encoder disc with 65 slits.
So I changed the parameter "ENCODER_HOLES_CNT" to 100 (reference is attached below)  and tried recompiling the code in the latest IAR IDE but it gives the following error during compilation.

https://github.com/iliasam/OpenTOFLidar/blob/d2ed102225cc642949f4d09c30fa0e5a3a8fc32a/Firmware/scanning_fw/config.h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

**Here is the screen-shot of the error**

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

**When I open your project files**, the IAR software ports the old project file to an updated project file in the new version. Is the error because of this? If so what version you used for the successfully compilation?

iliasam, 2020-04-29:
Yes, this problem is caused by IAR version.
I'm using IAR 7.50.

Try to add this code after "#include "stm32f30x.h"" in main.h:
#if defined ( __ICCARM__ ) // IAR
  #include "intrinsics.h"
#endif

AbidHussain70, 2020-04-29:
I tired this but I was getting the same error.

**Then I remove the if statement and it works.**

#include "stm32f30x.h"" in main.h:
//#if defined ( ICCARM ) // IAR
#include "intrinsics.h"
//#endif

Thanks

iliasam, 2020-04-29:
I'm sorry, there was a problem in Github message parser.
The code should be:
`#if defined(__ICCARM__) // IAR`
` #include "intrinsics.h"`
`#endif`
Does it work?

AbidHussain70, 2020-04-29:
Ohhh, no need to sorry.

First I tried the given command
**#if defined(__ICCARM__) // IAR
#include "intrinsics.h"
#endif**

But it was giving the same error. Then I removed the if statement and it works.
**#include "intrinsics.h"**

iliasam, 2020-04-29:
The will no be "intrinsics.h" in Keil.
I want to change me code to bake it better.
The problem was that is true "`__ICCARM__`" not "ICCARM"
You should see the same definitions below in main.h.

AbidHussain70, 2020-04-29:
ok, I will check it tomorrow again and I will update you.
But with the above mentioned way I got the .hex files.
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

AbidHussain70, 2020-05-08:
> #if defined(__ICCARM__) // IAR
> #include "intrinsics.h"
> #endif

I tried these lines also, but I was getting the same error.
So I just add the following line,

> #include "intrinsics.h".
And it works.

Closed 2020-05-02.

Thread 4 (2020-04-29):

What is the ref_plate_distance

AbidHussain70, 2020-04-29:
Hi,

**Whats this REF_PLATE_DIST variable?**
https://github.com/iliasam/OpenTOFLidar/blob/d2ed102225cc642949f4d09c30fa0e5a3a8fc32a/Firmware/scanning_fw/config.h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

**is it this back plate?**
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

**Or is it this top plate distance?**
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

iliasam, 2020-04-29:
"Reference plate" is a white plastic plate (you marked it at the first picture). LIDAR could "see" this mate when mirror is turned to zero angle. (At upper pictures mirror is at ~180 deg position).
LIDAR is measuring all distance from the rotation axis in horizontal plane.
So "REF_PLATE_DIST" is distance in mm between the rotation axis and the "Reference plate"

AbidHussain70, 2020-04-29:
Great, I got it.

Thanks

Closed 2020-04-29.

Thread 5 (2020-05-08):

PC Utility test run for Lidar testing and lidar scanning

AbidHussain70, 2020-05-08:
I did my first run but I am not getting the distance measurement. Any clue?
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

and I also changed encodre count to 20,
My encoder gives digital output 3v.

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

iliasam, 2020-05-08:
Have you tried to follow  this instructions: https://github.com/iliasam/OpenTOFLidar/wiki/Electronics-assembling-notes ?
Firstly, you should test your device in not-scanning mode: https://github.com/iliasam/OpenTOFLidar/tree/develop/Firmware
Do not try to run scanning mode until you get good results in not-scanning mode.

I can see from the first image that the is no received signal or it is too low.
Also I can see that you set APD target voltage to 132V, but measured voltage is 126V.
It would be good to measure breakdown voltage of the APD.
For AD500-8 it is close to 90V, for MTAPD-07-13 it is close to 130V.
But for testing you could set less voltage - to avoid breakdown .

AbidHussain70, 2020-05-09:
Great, it worked.

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

iliasam, 2020-05-09:
I can see from the histogram that received signal is still very small. See  this page with examples: https://github.com/iliasam/OpenTOFLidar/wiki/Resolution-of-the-LIDAR
Do you have an oscilloscope to  see received signal form?

iliasam, 2020-05-13:
Sorry, previous link is for scanning mode.
You should see screenshots of the "Testing Utility".
You can find them here: https://github.com/iliasam/OpenTOFLidar/wiki/LidarTestingUtility
Here: https://ibb.co/vjFfwVD
And in the video: https://youtu.be/lTPH_Xa9yCk

iliasam, 2020-05-17:
Should I close this issue?

AbidHussain70, 2020-05-18:
Hi,
I will do the oscilloscope test and I will post the results.

AbidHussain70, 2020-05-21:
I checked with oscilloscope, with changing Vlaser, the Vpp on connector J2 changes. The width of the pulse also increases with increase in Vlaser.

> Vlaser 16V, output is below.

.
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

> Vlaser 15V oscilloscope result is given below.
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

AbidHussain70, 2020-05-21:
The signal strength increases on white surface. But on Random surfaces the strength remains the same. By same I mean the same as shown in the pictures I posted earlier.

iliasam, 2020-05-21:
If you oscilloscope configuration is right, you pictures mean that laser current is too low.
At the first picture one cell is 50mV, so signal peak amplitude is ~150-200mV. Current sensing resistor must be 0.1 ohm, so current is ~1.5-2A. This is too low.
See this picture for a reference: https://github.com/iliasam/OpenTOFLidar/blob/develop/Images/Oscilloscope/LaserCurrent.png
Could you say your oscilloscope model?

AbidHussain70, 2020-05-22:
Sorry I forgot to mention, my oscilloscope probe is 10x. 150~200mV means 1.5~2V.

iliasam, 2020-05-22:
Ok, but what about strong additional noise?
Could you measure TIA signal at J1 ?
It would be good to measure signals at J1 and J2 simultaneously.

AbidHussain70, 2020-05-26:
I order the connectors, I will test it once I received the connectors.

AbidHussain70, 2020-06-05:
I checked but I am not getting any pulse at TIA J1.

iliasam, 2020-06-05:
Have you tried to check if laser is really working with a phone camera?
It is strange that you can't see any pulses, while you can get some measurements (as you showed earlier).
Amplitude of the pulses should be low - see here: https://ibb.co/m9Yj5TD
It is useful to use J2 laser signal as a trigger for the oscilloscope.

AbidHussain70, 2020-06-09:
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

This is laser check with camera. But I noticed it is blinking in irregular interval.

iliasam, 2020-06-09:
> But I noticed it is blinking in irregular interval.
I think that this is OK. It could be produced by camera frame rate.

Could you confirm that you can see that "START" values are changing somehow when you are changing distance to the object (as you said earlier)?
Also, I advice you to make non-scanning tests without mirror (to avoid possible wrong reflections).

AbidHussain70, 2020-06-10:
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

I am getting the distance in meters when I move an object away from the scanner. But the measurement is not stable. And also accuracy is not good.

AbidHussain70, 2020-06-10:
I will assemble another scanner.

iliasam, 2020-06-10:
I can see that your photodiode is really receiving light signal and TIA is working somehow.
So it very strange that you can't see TIA signal at the oscilloscope.
Tip: you must use AC coupling it the oscilloscope.
There are two reasons that your received signal is low:
1. Laser is not good aligned. Try to move laser holder against PCB.
2. TIA is particularly damaged. I have seen such case in my practice.

AbidHussain70, 2020-06-10:
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
This is what I got when both J1 and J2 is connected with oscilloscope.

iliasam, 2020-06-10:
Is oscilloscope CH2 divider correct?
TIA have ~100mV overdrive limit, so maximum CH2 should be ~100mV.

AbidHussain70, 2020-06-10:
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

**I am not using probe I am using BNC connectors.**
I got the pulse. Problem was with the UFL connectors.

iliasam, 2020-06-10:
Now it is looking good.
My tests are looking so: https://ibb.co/m9Yj5TD
You can see that at strong overdrive signal length should be > 75 ns

AbidHussain70, 2020-06-10:
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

AbidHussain70, 2020-06-10:
How should I update the calibration file?

I think low values in bin graph is because of calibration.

iliasam, 2020-06-11:
I added addition information to the Wiki about testing PCB without optics, it could be useful fro you: https://github.com/iliasam/OpenTOFLidar/wiki/No-optics-tests

iliasam, 2020-06-16:
Do you have any progress with this problem?

AbidHussain70, 2020-06-17:
Hi,
I will post an update soon.

AbidHussain70, 2020-06-22:
I did no optics test.
**Actual distance is 1.2 meter.**  **white wall.**
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
**Laser voltage is 16V.**

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
**laser voltage is 15v Actual distance is 1.2 meter. white wall.**

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

**laser voltage is 14v Actual distance is 1.2 meter. white wall**

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

**laser voltage is 13v Actual distance is 1.2 meter. white wall**

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

**laser voltage is 12v Actual distance is 1.2 meter. white wall**

![Uploading without-optics-distance-1.2meter-11v.PNG…]()

**laser voltage is 14v Actual distance is 1.2 meter. white wall**

iliasam, 2020-06-22:
It's an amplitude of TIA pulse. It's changing with no optics like this: https://ibb.co/m9Yj5TD

AbidHussain70, 2020-06-22:
but with optics signal amplitude changes when I change the APD voltage.

iliasam, 2020-06-22:
"In my case just pulse width is changing not amplitude."
Maybe something reflecting light from the laser?
When I say - "no optics", I mean that lens holders are installed (without lens).

AbidHussain70, 2020-06-23:
I just remove the optics part not the holder.

iliasam, 2020-06-23:
Maybe APD voltage is too high?

iliasam, 2020-08-03:
How are your results?

Anesthesia-RW, 2020-08-19:
Hi,the non-scan is working but In the scan mode, I get the following result. No point in my result and the state  mask is  0x40. If you give some suggestions I will very appreciation.
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

Anesthesia-RW, 2020-08-19:
when i set the APD volt ,there are no change that means the "set" command don't work?
I check the src ,the state mask is 0x40 means there have no CALIBRATION .
so in scanning model the callbration is what?

iliasam, 2020-08-19:
See info about calibration at this page: https://github.com/iliasam/OpenTOFLidar/wiki/LidarTestingUtility
You need to record data with constant distance, but changing amplitude.

"when i set the APD volt ,there are no change that means the "set" command don't work?"
I'm sorry, I need more information about that you are doing.

Anesthesia-RW, 2020-08-19:
Okay, I will try a few more times, and then record more details of the problem.

Anesthesia-RW, 2020-08-26:
Hello.
Following the steps you gave, I selected the constant distance is 3m and change received signal by slowly closing APD lens with something non-transparentcollect .
The data and curves are as follows:
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
I sent the  "coff." to MCU, then change the distance to test.
Some data are as follows:
Real_Distance_1--- 5.15m     Test_Distance_1--- 5.95m
Real_Distance_2--- 4.55m     Test_Distance_2--- 5.04m
Real_Distance_3---2.35m      Test_Distance_3---1.95m
Real_Distance_4---1.75m      Test_Distance_4---1.01m
Real_Distance_5---1.2m        Test_Distance_5---0.16m
I found that when Real_Distance<1.1m the Test_Distance is 0.
There a problem with the calibration data. I repeated the calibration more than ten times. Sending  the calibration coefficient  to MCU and test ,the measurement result was quite different.
I use oscilloscope tested J1 and J2,The result is as follows:
--Distance:3m
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

iliasam, 2020-08-26:
Your results are looking strange.
Firstly - I can see that your APD voltage is 63V while target voltage is 128V. This is not normal.  What is the type of your APD?
Are you using the same optics as I am using in my Lidar?

Your calibration data are looking OK, so you can move "Fit Start" line to the 300-350 position before starting "Fit".

Also, after calibration you need to set: " "Ref distance" - distance to a reference object. Used with non-scanning firmware only. You need to enter current distance to the object and press "SET" button". Best distance is 2-3 m.
See https://github.com/iliasam/OpenTOFLidar/wiki/LidarTestingUtility

Anesthesia-RW, 2020-08-27:
Because I can’t find the same APD as yours, no supply. So I changed the type of APD. The optics is the same as yours.

 I have two type APD.  One is MTAPD-07-14 ,the other one is GD5210Y-2 , all of them the APD voltage in range 63~65 (v).
Their performance is very similar to yours MTAPD-07-13

Especially MTAPD-07-14,I checked the information and found that it came from the same data sheet with  MTAPD-07-13.
The GD5210Y-2's data sheet as follows:
[996076217905nm系列APD-规格书.pdf](https://github.com/iliasam/OpenTOFLidar/files/5134165/996076217905nm.APD-.pdf)

iliasam, 2020-08-27:
According to MTAPD-07-14 datasheet its breakdown voltage is in "160-200V" range.
You can see that APD is in breakdown state by seeing a very big noise at the TIA output.

According to GD5210Y-2 datasheet its breakdown voltage is in 130-220 V range.

In any case, it is **not OK** that measured APD voltage (63V) is not the same as set target voltage (128V). It is look like APD step-up converter or APD voltage measurement circuit are working wrong.

You should **ensure** that the is no light is getting directly from laser to the APD (or APD lens) - by some holes in the lens holders or by scattering from mirror or mechanics.
I advice you to do calibration and all not scanning tests **without mirror** - lenses should be directly pointed to the target object. I mean this setup: https://habrastorage.org/getpro/habr/post_images/120/c20/e43/120c20e43dc0d41ada95b6ed9ecd82bf.jpg

Anesthesia-RW, 2020-08-27:
I sorry, I forgot to tell you that the earlier calibration are under without mirror conditions .
I mean all test as you advise, constant distance is 3m and without mirror.

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

Anesthesia-RW, 2020-08-27:
Could it be a problem with my electronic components?
But all I follow your BOM table, maybe I need to check again and make a new PCB board.
I have made three PCB boards, one of the TIA is damaged. the voltage of the other two boards is about 63v.

iliasam, 2020-08-27:
You cant try to switch to the manual PWM controlling by setting "APD PWM Steps" - second "SET" buttom at the "Rangefinder State" group. Try to change this value starting from low (like 30 steps) to bigger value.

Anesthesia-RW, 2020-08-27:
Change the ”APD PWM“ and recording "APD Volt", the curve as follow:
When the APD PWM >85 , Changing the APD PWM  and the APD volt  changes very little. Fluctuate around 64
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

iliasam, 2020-08-27:
This is very strange. Have you tried to measure real APD voltage by voltmeter?

Anesthesia-RW, 2020-08-28:
I can't remove R1.
Using voltmeter to measure the real APD voltage. I found the voltmeter's vlaue less than soft_APD voltage(MCU get)

iliasam, 2020-08-28:
"I can't remove R1."
Why?
" I found the voltmeter's vlaue less than soft_APD voltage"
How big is the difference?

Anesthesia-RW, 2020-08-28:
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

Anesthesia-RW, 2020-08-28:
The difference is in range (1,2).

Anesthesia-RW, 2020-08-28:
Just now.I removed R1 and test again no change in voltage.

iliasam, 2020-08-28:
"The difference is in range (1,2)."
Do you mean volts? If it is right, is is bad - voltmeter have own resistance, an power  of the APD step-up converter is very low, so voltmeter create some voltage drop. Also, APD_voltage is not measured very accurately.

I can't suggest why APD voltage did not grow bigger that 70V. It look like some HW problem in APD voltage source.

Anesthesia-RW, 2020-08-28:
Yes,the difference is  1v to 2 v.
Thanks for your reply.
I decided to remake a few PCB boards.
How to explain that the previous two pieces have the same error?
Maybe problems with electronic components?

iliasam, 2020-08-28:
"Maybe problems with electronic components?"
Yes, looks like that some of the components is damaged or wrong.
Are you sure that max voltage parameter of the capacitors C10/C11/C33  is 250V ?
Is L5 inductance really 47uH ?

I don't think that there are problems with PCB itself.

Anesthesia-RW, 2020-08-28:
I am also troubled by this problem. The electronic components is provided by a specialized manufacturer.

iliasam, 2020-08-28:
But are you sure that **your** BOM (that you send to the components seller) is correct?

Anesthesia-RW, 2020-08-29:
Hi，The APD power is generate by this  part  circuit?
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

iliasam, 2020-08-29:
Yes.
R8 and R9 are used for measurement voltage by MCU.

Anesthesia-RW, 2020-08-29:
I want to simulate this part of the circuit separately.
The PWM signal is generated by a signal generator, but I cannot find L4 in Multisim. Can you give some suggestions?

iliasam, 2020-08-29:
L4 is not needed for simulation. It is used to block noise from this step -up circuit.

Anesthesia-RW, 2020-08-29:
I tested the APD with a voltmeter, but it showed only 4.71v,
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

Anesthesia-RW, 2020-08-29:
The PWM config(test by Oscilloscope):
frequency:100khz
duty:11%---->about 80steps
amplitude: 3.76v
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

iliasam, 2020-08-29:
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
I tried to run simulation too.
I found that Multisim BSS131 model is not working, so I changed it to the BSS123. Its is limited by 100V, so simulation does not give voltage bigger than 100V.
Real BSS131 is limited by 240V.
Virtual oscilloscope  slow down simulation, I advice you to remove it.

Anesthesia-RW, 2020-08-29:
Great!
Have you tested the relationship curve between APD_PWM and APD_PWM, as I posted before.

Hope my new PCB boards won’t go wrong!

iliasam, 2020-08-29:
Do you mean - tested in real hardware?
I never tried to plot such curves, but I never have a problem to get APD voltage > 100V.
My APD power source circuit is always working OK.
You can see the same schematic here - https://cdn.hackaday.io/files/1635016995226784/Unruly_Rev1.pdf (see left bottom corner)

Anesthesia-RW, 2020-08-29:
I mean--APD_Voltage_soft.

No changes.  I just ctrl_c and ctrl_v the file, then send to the seller.
I did not solder the components myself.

Just now,i found a strange phenomenon. the APD_voltage equal about 102*R9_voltage, fit well with the source code.
This means that the voltage amplification function is normal,
but what limits the maximum voltage of my APD to only 70v?

Changing the PWM steps APD voltage will also change, so the PWM input is normal,
That’s why I asked if you have tested the relationship curve between APD and PWM. I want to know if it’s just that the maximum value of my APD voltage is limited, not the relationship.

iliasam, 2020-08-29:
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
I have made measurements with PCB v1 (AD500-8). Laser was closed. Small amount of external light. PWM controlling is manual.

You can see that when APD voltage > 90V voltage stop rising. This is breakdown mode - APD current begin to grow, and step-up efficiency fall. Noise level became very big at this voltage - "Max diff" value (at the center text window) will be very big (bigger that 1000).
"Max diff" value at 88V (not breakdown mode) is near 0-2 BINs (with closed laser).

As I know from PCB v4, that MTAPD-07-13 have higher breakdown voltage - ~120V, so it need more PWM steps.

So, if you want to test how good is APD voltage source, you need to remove R1 to disconnect APD from power.

************************************
"Just now,i found a strange phenomenon. the APD_voltage equal about 102*R9_voltage, fit well with the source code."
This just mean that voltage **measurement** part is working OK. This part consist of two resistors so there are no reasons for it to work wrong.
Problem is in step-up part.
APD breakdown voltage limiting (as I described earlier) is not seems your problem - you said that you have such problem when R1 was removed - no APD, no breakdown.
Also I can't see that terrible breakdown noise at your screenshots.

Maybe Q1 (BSS131) is wrong? Try to by it somewhere else and replace.

*********************************
"No changes. I just ctrl_c and ctrl_v the file, then send to the seller."
Why do you think that something will change in this case?

Anesthesia-RW, 2020-08-30:
ok, I will follow your advice.

If the Q1 is wrong. the APD_voltage will not exceed 5v,in my simulation it will stable at 4.701v.
But now my APD_voltage is about 64v, could i say the Q1 is working OK?

yeah! I know there have somthing change in my case.That's why my APD_voltage is wrong.

iliasam, 2020-08-30:
BSS131 model in Modelsim is strange, it does not work **at all**. You can see that simulated transistor have two additional pins at the right:
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
maybe they should be connected to something.
So try to change **simulated** transistor to BSS123.

Anesthesia-RW, 2020-08-30:
You have already mentioned this problem, and i also changed the  simulated transistor to BSS123.
The simulation results show that the APD voltage will change with the change of the PWM duty cycle and can reach a high voltage.
Just like your  simulation:
https://user-images.githubusercontent.com/10147086/91633856-41981780-e9f4-11ea-8d97-76628de3da3c.png

Assuming that the Q1 is broken ---We can treat Q1(a high-speed switch) as a simple switch,only have two state OFF or ON
No  matter the wrong of Q1 is OFF or ON, the APD voltage will not exceed 5V.
However, my APD voltage can reach 64V, and it can change with the change of PWM.That means the Q1 is working Ok.

Can you change the APD voltage to 70V,?
And then observe whether it can work and  the distance measurement is no problem.

iliasam, 2020-08-30:
"Assuming that the Q1 is broken"
I don't think that it is broken. It could be just not needed BSS131, but another transistor model - by mistake of someone who is buying BOM or assembling PCB/ or remarked transistor.

"Can you change the APD voltage to 70V,?
And then observe whether it can work and the distance measurement is no problem."
I'm sorry, I don't have time for that.

Anesthesia-RW, 2020-08-30:
Thanks.

iliasam, 2020-08-31:
I found some time and made a measurements with PCB v4 and APD voltage 65V (nominal is 125V).
I made a calibration - it is needed after changing APD voltage.
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
I found that only a certain "Fit start" slider position is working OK (absolute distance measurement error was <5 cm).
I made accurate measurements only in 20-180 cm range; 3m looked good, but did not confirm it.

When I tried to move  "Fit start" left, absolute measurement quality fall (absolute distance measurement error was >10 cm):
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

I can't guaranty that lidar will work OK it such mode - you can see that fit (calibration) is working not well.

Anesthesia-RW, 2020-09-01:
Great!
Very valuable information.I will do it.

Through simulation and testing, I currently determine that the abnormal APD voltage may be due to the value of L5. If the value of L5 is not enough, the inductor energy storage will be insufficient. When the PWM duty cycle is increased, the APD voltage will not go up.

Anesthesia-RW, 2020-09-11:
Hello.The APD voltage's problem solved. The problem is the inductor L5 type not value.
The manufacturer gave a multilayer inductor, but the actual winding type. There is no description about L5 type in the BOM.

Then I tested again.The result is still not good.
Carlibration's  distance: 1m
Object: White wall
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
The carlibration as follow, and the curve looks good.
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

After calibration，i change the distance to testing.
When the distance is within the range of 0.2m to 1m. The result is good.
The distance < 0.2, result is bad---64m.
When the distance is greater than 1m, the error will increase as the distance increases.
Ture distance:3m-----test result:4m-----error:1m.
Ture distance:1.7m---test result:2m-----error:30cm.

I used an oscilloscope to observe the output in some places（Laser，Laser_comp,TIA,APD_comp）
I think the Laser's output is strange.Big difference from you
1.
**Laser：**
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
2.
**Laser comp:**
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
3.
**TIA:**
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
4.
**APD comp:**
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

iliasam, 2020-09-11:
"I think the Laser's output is strange.Big difference from you"
Are you using "oscilloscope ground spring" like here: [LINK](https://electronics.stackexchange.com/questions/136123/how-do-you-attach-an-oscilloscope-ground-spring)  ?

Do you set reference  distance ("Ref distance" value and its "SET" button)?

I can see from your calibration data that "Begin X" is 537. You can see that mine was near 400.
Try to close lens stronger during calibration data capture - you need more data with partially closed lens.

"When the distance is greater than 1m, the error will increase as the distance increases.
Ture distance:3m-----test result:4m-----error:1m.
Ture distance:1.7m---test result:2m-----error:30cm."
It is strange.
Could you give me screenshots of the utility for distances 1m, 1.5m, 2m, 2.5m, 3m, bigger distances would be good too.

Anesthesia-RW, 2020-09-11:
The oscilloscope ground like this:
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
And i use the oscilloscope to Observed the APD_PWM. Like this:
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

Real distances:0.5m
screenshots:
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

Real distances:1m
screenshots:
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
Real distances:1.5m
screenshots:
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
Real distances:2m
screenshots:
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
Real distances:2.5m
screenshots:
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
Real distances:3m
screenshots:
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
Real distances:3.5m
screenshots:
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
Real distances:4m
screenshots:
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

Could  you use a short video to record the process of your calibration  operation?
I found when i record the calibration data. Among dozens of sets of data, only one set of data is looks good(curve.

Anesthesia-RW, 2020-09-11:
The oscilloscope like this:
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

Yes, after i send the coeffA/B to MCU. i set the reference distance  and save to the flash.
Real distance: 0.5m
screenshots:
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

Real distance: 1m
screenshots:
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

Real distance: 1.5m
screenshots:
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
Real distance: 2m
screenshots:
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
Real distance: 2.5m
 screenshots:
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
Real distance: 3m
screenshots:
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
Real distance: 3.5m
screenshots:
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
Real distance: 4m
screenshots:
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

Thread 8 (2021-08-06):

The pulse on LASER_PULSE net should be like this？

br76530067, 2021-08-06:
I soldered these components on PCB under your instruction note " #2. install TDC, its quartz. Enable "Auto Request Batch" in utility. There must be pulses at "LASER_PULSE" net. ", and I use an oscilloscope to see the signal on LASER_PULSE net, are these data in the following picture correct?
The test PC utility:
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

The oscilloscope:
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

Thank you in advance!

iliasam, 2021-08-06:
Pulses shoud have ~1 ms period and they should have 3.3V amplitude.
I can see from your screenshot that "state mask" is 0x5. Description is here: https://github.com/iliasam/OpenTOFLidar/wiki/State-Mask-bits-description
You have bit 0 set which mean that MCU can't detect TDC at startup.
Have you installed all componencs aroung TDC?

br76530067, 2021-08-07:
Hi, iliasam, thank you for your reply
I installed all components around TDC, and I checked the voltage level of every pin of that, it looks like normal.

#1  And I found the temperature of the soldering for TDC is limited to 260 °C in the datasheet, due to manual soldering, I used 350°C to solder TDC, which may cause the broken of TDC?  have you ever met this situation when you solder TDC?

#2 Or do you have some way to check if TDC is broken?

br76530067, 2021-08-07:
Hi ilisam
it looks like get some progree, however, i cant catch the pulse on LASER_PULSE net.
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

iliasam, 2021-08-07:
Pulses should be short, with 1us width. Set trigger to 1V at your oscilloscope.
I don't know how to find out that TDC is broken.

br76530067, 2021-08-07:
Hi, iliasam,

I under your hint, and get this picture in the oscilloscope, but it looks like only could get one time of rising edge when power is on. Then can not get any pulse anymore, is it correct?
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

Thanks in advance

iliasam, 2021-08-07:
Pulses should be present continuously when "Auto Request Batch" flag is set.

br76530067, 2021-08-08:
After changing a TDC-GP21, it works, Thanks, I will continue.

Closed 2021-08-08.

Thread 9 (2021-08-08):

How to be able to see the laser light.

br76530067, 2021-08-08:
Hi, iliasam,
I am working on step #4Install MOSFET, Laser diode, diode D7, and other lasers components. Check that laser is working by the camera. Do not look to the laser!! Check laser current pulses by connecting J2 to the oscilloscope. Current must change with changing "Vlaser".

however, I can not see the laser light on my iPhone camera, how do I make sure that is working?
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

And I get the J2 oscilloscope picture like below ( because I do not have 0.1R resistance, so I use a 0.3R one), does the blow picture be correct?
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

Thanks in advance!

br76530067, 2021-08-08:
And I can change the J2 signal by changing the Laser Volt on PC Testing Utility

br76530067, 2021-08-08:
When set to 19V:
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

br76530067, 2021-08-08:
Ok thanks, I use a Huawei phone to get the laser light successfully, pls omit the laser light problem.
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

iliasam, 2021-08-08:
And yes, laser is infrared, so different phones haw different IR filters. Best way is to use camera with no IR filters (like CCTV).
Using 0.3 Ohm is not good idea - you will lose too much voltage at it (~4.5V).
You can try to connect 3 resistors  0.3 Ohm parallel to get 0.1 Ohm, but I'm not sure how this will work (because of parasitic inductance of resistors).
How you are connecting oscilloscope to the board? The best way is to use U.FL - BNC cable.
Also it is possible to take coaxial cable with BNC connector and solder it instead of  U.FL connectors at PCB.
If you are using oscilloscope probe, you must use "oscilloscope ground spring": https://electronics.stackexchange.com/questions/40420/what-is-the-name-of-this-springy-type-oscilloscope-probe-accessory
Otherwise you would see a lot of oscillations.

br76530067, 2021-08-08:
Yes, U.FL - BNC cable
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

And I do not know why there will be a lot of oscillations, is it due to the inductance of the 0.3R resistor?
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

iliasam, 2021-08-08:
Yes, using leaded resistor is not good at all.
Also is your oscilloscope have an ability to switch its input impedance to 50 Ohm, you should use it.

br76530067, 2021-08-08:
Ok, and I will replace the leaded resistor with a 0.1Ohm resistor with a 1206 footprint.
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

br76530067, 2021-08-08:
But I saw this 0.1Ohm resistor also is Leaded resistor, could you recommend a type of resistor for me to buy and replce?
Thanks

iliasam, 2021-08-08:
As you can see in BOM, you need  0805 (2012 metric) 0.1 Ohm resistor.

br76530067, 2021-08-08:
Ok, Thanks!

br76530067, 2021-08-12:
Hi, Iliasam,
I replaced the 0.3Ohm lead resister with 0.1Ohm with 0805 footprints ( the type of this resister is 0.1Ohm, however, what I scale it by multimeter is 0.3Ohm). And I got the following pictures, should these pictures be correct? The laser voltage should be 10V because I haven't connected it to the PC to configure.
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

iliasam, 2021-08-12:
For me this picture is too strange, signal should not be such oscillating, but I can't really remember exact waveforms at low voltage. But the first pulse must be highest one, as I can remember.
Soldering flux should be removed from PCB (laser circuit).
I can see that you have modified PCB comparing to my PCB, also I don't know what are the components that you are installed.

br76530067, 2021-08-12:
Hi, Iliasam, thank you for your replying.
I haven't changed your PCB, I just add a MEMS mirror driver part to your PCB, because I want to use the MEMS mirror to replace the rotating mirror in your project, and I am willing to share with you all of this project and I will open this after finishing. Maybe you are interested in it if so I could share with you some work I did( but I only do a little...)

And I found the following picture after I use the probe instead of the U.FL - BNC cable.
![Uploading image.png…]()

![Uploading image.png…]()

![Uploading image.png…]()

br76530067, 2021-08-12:
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

iliasam, 2021-08-12:
This is looking better, but pulse width seems too big for me. It is strange, that probe give better shape, that a special cable.
You can try to change C17 to a smaller value to decrease pulse width.
Could you say your full laser marking?
Are you you using probe in x10 mode?

iliasam, 2021-08-12:
I have added laser current screenshots from my oscilloscope (made with different voltages): https://github.com/iliasam/OpenTOFLidar/tree/develop/Images/Oscilloscope/LaserCurrent
These measurements are made with UFL cable, oscilloscope input is in high-impedance mode.

br76530067, 2021-08-13:
Hi, Iliasam,
#1,After changing the C17 20nf to 10nf, I got these pictures:
At 10V:
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

At 11V:
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

#2, About: Could you say your full laser marking?
Sorry, what do you exactly mean?

#3 ,Are you you using probe in x10 mode?
No, I am in X1 mode.

Thanks!

br76530067, 2021-08-13:
#4 and do you know why there is the signal? what is that? I did not found this signal in your picture.
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

iliasam, 2021-08-13:
Now shape of the pulses is looking better, but pulse width is still ~50ns, while my pulse width was ~25 ns at 12V.
Maybe you need to decrease C17 more.

" About: Could you say your full laser marking?
Sorry, what do you exactly mean?"
I mean full name of your laser diode. I'm using "SPL PL90_3", number 3 is important.

As I know, it is not recommended to use x1 mode for measuring high frequencies: http://electronics-diy.com/electronic_schematic.php?id=970

"#4 and do you know why there is the signal?"
It is some kind of spike at the end (falling edge) of controlling pulse "LASER_PULSE" which is 1 us long. It is now visible at my oscillograms because they are too short. It is OK.

br76530067, 2021-08-13:
#1  I'm using "SPL PL90_3", number 3 is important.
Hi I am also using "SPL PL90_3"
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

iliasam, 2021-08-13:
OK, I was afraid that you are using another type of laser.

br76530067, 2021-08-13:
After changing C17 to 3.3 UF ,I got :
10V:
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

12V:
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

iliasam, 2021-08-13:
Ok, this is looking better, so I think that electronics is working OK now.
You can try to increase laser voltage to 14-15V.
It would be good to get somehow the same pictures with UFL wire.

Thread 10 (2021-08-13):

Step 6.Install APD DC-DC co......

br76530067, 2021-08-13:
When doing "6.Install APD DC-DC components (Q1 and others). Check "APD_V" - it must change by manual commands from utility."

I found I only could adjust the APD Volt in scope 0 ~ 59.8V, like below pictures, whatever I changed the APD PWM and APD Targ.Volt. Should it be correct?
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

iliasam, 2021-08-13:
Have you measured APD voltage by voltmeter. Is the value the same as displayed in utility?
Also you can check this (type of inductor): https://github.com/iliasam/OpenTOFLidar/issues/5#issuecomment-690827160

br76530067, 2021-08-13:
Yes, it is same although some difference, for example, 12.5V in utility, 13.6V in voltmeter.
Let me check #5

br76530067, 2021-08-13:
"In any case, it is not OK that measured APD voltage (63V) is not the same as set target voltage (128V). It is look like APD step-up converter or APD voltage measurement circuit are working wrong." as your repled in #5, let me check if it is .

iliasam, 2021-08-13:
13.6 / 12.5V = 1.088, -> ~9% error, which is big. Can you measure difference at higher voltage  (40-50V)?

br76530067, 2021-08-13:
when  47.3V in utility, 46.4V in voltmeter

br76530067, 2021-08-13:
"Don't try to switch to Auto mode until you get well working manual mode." you mean first use the PWM duty to get higer voltage then use the AUTO mode to set?

br76530067, 2021-08-13:
And one more : when 13.8V in utility, 11.9V in voltmeter

br76530067, 2021-08-13:
"Hello.The APD voltage's problem solved. The problem is the inductor L5 type not value.
The manufacturer gave a multilayer inductor, but the actual winding type. There is no description about L5 type in the BOM."
I think it is same issue, I will buy this one and to try.

iliasam, 2021-08-13:
"you mean first use the PWM duty to get higer voltage then use the AUTO mode to set?"
You need to get stable high voltage  (< 110V) by setting PWM duty manually.

br76530067, 2021-08-17:
Hi, iliasam,
Thanks for your advice, after changing to the leading inductor, I got below picture:
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

And after changing to the high precise resister, I got the 103.7V on voltmeter and 103.1V on PC utility.

br76530067, 2021-08-17:
but what max volt I could achieve is 122V, is it correct?

iliasam, 2021-08-17:
Breakdown voltage of MTAPD-07-013 is in 120-130V.
When APD is installed, you can the that APD is close to breakdown by seeing more noise at the TIA output.
Also, APD voltage would increase slowly (comparing to low voltage - not breakdown mode) as shown here: https://github.com/iliasam/OpenTOFLidar/blob/develop/Images/APD_voltage_vs_PWM.png (for AD500-8).

iliasam, 2021-08-17:
But it is strange that you can't get 130V. Do you have APD installed or not?

br76530067, 2021-08-17:
No, I havent installed the APD, and my APD tupe is MTAPD-07-007.

What is the maximum PWM value that you have set?
200 steps, as above picture.

br76530067, 2021-08-17:
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

br76530067, 2021-08-17:
MTAPD-07-013 is on the delivery way

iliasam, 2021-08-17:
The plot that I mentioned earlier, was measured with AD500-8 which have breakdown voltage ~95V. This plot is for information only.
This image is from "Issue 5": https://user-images.githubusercontent.com/48154419/92838938-f75e5f80-f411-11ea-96e4-dbe952ec430b.png
You can see that "Anesthesia-RW" can get 124.5V at 72 PWM steps.
I get 130V at 73V: https://ibb.co/vjFfwVD
All these measurements were made with APD installed, but I don't think that it is important.

Cleaning PCB could be important.
Check R8, R9 values, check that C10, C11 are high-voltage capacitors.

br76530067, 2021-08-17:
After clearing the PCB, I could get the maximum volt is 126V.
I just put here my soldered components, maybe you have some clue.
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

iliasam, 2021-08-17:
Your Q1 and D1 are looking OK.
You can try to shorten L4, but I don't think that this will help.
Maybe it is really problem with C10,C11 working woltage?

br76530067, 2021-08-18:
Because in china market, the  MTAPD-07-013 needs too long to get, and there is no AD500-8, So I buy a AD500-9 to try.
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

Do you think the AD500-9 will work?

iliasam, 2021-08-18:
Why there is no AD500-8? https://aliexpress.com/item/32396227457.html
Also I can see them in Taobao.
It looks like AD500-9 have higher breakdown voltage, than AD500-8. Also, you need to remade PCB for any leaded APD.
I think you need to find out why your circuit can't produce higher voltage.

br76530067, 2021-08-18:
Oh, thank you for your reminder, after several times of searching in Taobao, I found one AD500-8.

"I think you need to find out why your circuit can't produce higher voltage."
I will try more.

Closed 2021-11-01.

Thread 11 (2021-08-20):

After installing the AD500-8

br76530067, 2021-08-20:
Hi, after I install the AD500-8 and lens. I got this picture. ( it is toward to my ceiling)
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

I do not know how to set the lens at a proper focus point. I will try to find some answers in your wiki.

iliasam, 2021-08-21:
I can see that you had set "BIN Length" to 7.0 mm. It is not looking OK -  TDC BIN is 90 ps, which give theoretical value 13.6 mm.
Calibration curve should contain at least 10 points with different signal amplitude but with the same distance.

I have published some information about lens focusing: https://github.com/iliasam/OpenTOFLidar/wiki/Lens-focusing
See also: https://github.com/iliasam/OpenTOFLidar/wiki/No-optics-tests

br76530067, 2021-08-28:
I have been busy recently, and now start working on it

br76530067, 2021-09-06:
Hi, After bought a CCD industrial camera, I got the laser spot at 1.45m as below picture:
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
and could see the spot have about 12mm long, and I am buying an extender of lense to try more.

iliasam, 2021-09-06:
Spot is looking OK.

br76530067, 2021-09-11:
Hi, Am now is working on how to transplant to my MEMS mirror to detect distance.

However, I could only detect 1-2 Meter span laser

My structure is like below:
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

and could see the Spot is too large to focus on the center of the MEMS mirror:

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

The rotate mirror is the area in the red circle. And the rotational angle is about 15 ° ~ +15°, so I may need a receiving lens to get a larger receiving field.

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

I guess there are three main reasons causing why I can't get further distance when detecting:

1, the Spot is too large. (I am buying a M12 laser focuser to try)
2, the receiving Lense can not get the more large receiving field.
3, the APD500-8 is for 805nm, however, our Laser is 905nm, the strength of receiving diminished.

br76530067, 2021-09-11:
Could you help me to give some advice? because I am not familiar with the optics...
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

br76530067, 2021-09-11:
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

iliasam, 2021-09-11:
Hello.
Have you tested lidar with the same optics as I recommended in BOM (without MEMS)?
I think **you need to achieve good results without MEMS**, and try to install MEMS only after that.
All initial optics alignment should be done without MEMS too.

"3, the APD500-8 is for 805nm, however, our Laser is 905nm, the strength of receiving diminished." I had never had problems with APD500-8. Lidar range was at least ~15m with APD500-8.

I'm sorry, I'm have never worked with MEMS mirrors. I have thoughts about using MEMS mirror in lidar, but I either don't know right way to use high power IR laser with MEMS .
High power IR laser usually have very long enough emitting zone (comparing to low power laser diodes). Long emitting zone means that image is not symmetric, so it is hard to focus, and such laser have too big divergence angle.

If you take lens with small diameter (same with MEMS diameter), this lens would have small focus value, so divergence angle would be be very big, so angular resolution would be low.
If you take lens with big diameter (much bigger that MEMS diameter),  this lens could have big focus value, so divergence angle would be low, but as you can see - you will lose some emitted power. Maybe power loss would be not really dramatic - it need to be calculated accurate.

 To get better results, you probably will need really complicated lens and lens holders - like custom cylindrical lenses -  to change shape of lasers beam. Maybe you will need some optics after MEMS mirror.

 Another way is to use laser diode with less power, like MIR-905-25: https://www.alibaba.com/product-detail/TO18-Pulsed-Laser-Diode-905nm-25w_1600170943009.html
 According to specs, it have "75*10 um" emitting zone (SPL LL90_3 have it 200x10um), so I suppose that it would have smaller spot.

 "2, the receiving Lense can not get the more large receiving field."
 As I know, all lidars with MEMS have very short focus lenses (like fish-eye) (so moving spot would be very small and it would not leave APD).
 But fish-eye lenses usually have too small aperture, so it could be hard to find suitable for Lidar.

  P.S. I'm not really sure in information above.

br76530067, 2021-09-11:
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
This is what I got without the MEMS. The actual distance should be 10M.

And I will buy a lower power laser diode to try.

Maybe I should hold an optics platform to test a variety of lenses.

iliasam, 2021-09-11:
"TOF std. dev" is looking too big.
You can see here my measurements: https://github.com/iliasam/OpenTOFLidar/wiki/Resolution-of-the-LIDAR
My value was near 1-2 cm at 10m comparing to yours 70 cm.
It could could be useful to no optics tests: https://github.com/iliasam/OpenTOFLidar/wiki/No-optics-tests
TIA is really sensitive to static electricity, when it got broken, lidar sensitivity drops significantly (20-100 times).

br76530067, 2021-09-11:
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

When it was at about 0.8M & 1.5M could get the above picture.

Because my 10M test was not on the formal testing object (actually a wall), and I will follow your advice to test if the TIA is broken.

woaigithuber, 2022-02-09:
In the process of making a PCB board, we have doubts about some component parameters in the file TOF_rangefinder_v4b.xlsx, such as the size and package format of L3, L5, P15, C37, X1, X2, etc. If it is convenient, can you provide us with some detailed instructions about the components when making the PCB, we would be very grateful for your help.

iliasam, 2022-02-13:
You can see from BOM, that:
L3 - QM21FN100M80L  - 0805[2012 metric]
L5 - LQH31CN470K03L - 1206[3216 metric]
You can check them at mouser.com
P15 - is PLS-3
C37 - any polarized capacitor 100uF with 5mm between pins, >10V
X1 - any leaded cylindrical 32.768kHz quartz for with 3mm between pins, like this one: https://aliexpress.com/item/1005003048673233.html
X2 - package SMD06035C4 - 6x3.5mm, SMD05032C4 package is suitable too. 8MHz. 4 pins.

Closed 2021-11-01.

Thread 12 (2021-12-20):

Low-cost 3D scanner

DeRuiY, 2021-12-20:
I have been able to get a two-dimensional point cloud. I would like to DIY a low-cost 3D scanner based on your design. What do you recommend? thanks
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

iliasam, 2021-12-20:
Firstly I need to say that you have certain problems with calibration. Probably you need to set correct "BIN Length" value.

If you are planning to make 3D scanner, you need to add another drive to rotate whole LIDAR.
Example: https://youtu.be/3SnqrfDCc70
P.S. I'm interested in any information about this Lidar from others, so your experience with this Lidar will be really interesting for me.

iliasam, 2021-12-30:
@DeRuiY  Please, close this issue if you don't have other questions.

DeRuiY, 2022-02-15:
Hello, I have come, I have been thinking about the ranging problem of TDC-GP21, because I used TDC-GP22 for a while before. Why do you want to measure distance this way, instead of using
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
instead of the way below
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 .Thanks

iliasam, 2022-02-15:
Hello.
Sorry, but I don't understand your question.
What is the "ranging problem of TDC-GP21" ?
My correction is used for compensating pulse amplitude/changing (exponential part) and for zero offsets compensation.
See https://github.com/iliasam/OpenTOFLidar/wiki/TDC-data-processing

Closed 2022-01-26.

Thread 13 (2022-01-26):

Sensor Readings

motius-ggaryuk, 2022-01-26:
Hi,
amazing project!
I am wondering what are the raw values you get from the photo receiver.
In particular, can you see multiple responses with different intensities for a single laser beam?
For example when looking at a glass surface can you see the response of the glass and the response from a structure behind the glass?

iliasam, 2022-01-26:
Hello.
Current firmware do not support multiply stop events.
I'm not sure that current TDC schematic support it too.
Laser pulse length is big enough (>20 ns), also TIA can work in overdrive mode, so resulting pulse length get increased.
20ns is corresponding to 3m, so multiply stop events support with current hardware seems useless for me.

motius-ggaryuk, 2022-01-28:
Thank you very much!

Closed 2022-01-28.

Thread 14 (2022-03-03):

Question on Lidar

YileAllenChen1, 2022-03-03:
This is an amazing project, you did a great job! I have a few questions regarding some of the details.

In this [image](https://i.ibb.co/W6KjFtM/IMG-7432a.jpg) I see you are connecting an antenna to the orange pi PC, could you please tell me what this is for? You mentioned that the ROS node and hector SLAM runs on the orange pi, but are you still transmitting any data from the orange pi to your PC?

Also if you're running the SLAM software on the orange pi, how are you displaying the scanning results in real time? Since the orange pi is not connected to a monitor.

Thank you in advance for your time and help!

iliasam, 2022-03-03:
Antenna is connected to WIFI dongle, which is connected to  Orange pi PC.
Orange pi PC is connected to local network via this WIFI.
My x86 PC with "rviz" running is also connected to this network. So all SLAM is running at the Orange pi PC but I can view real-time results at my  x86 PC.
Hardware configuration is the same as here: https://youtu.be/RW57MEIpBHI?t=11  but in this TOF Lidar project ROS Master is Orange pi PC.

See also: http://wiki.ros.org/ROS/Tutorials/MultipleMachines

YileAllenChen1, 2022-03-10:
Thank you for the help!

Closed 2022-03-09.

Thread 15 (2022-03-10):

Motor connection to board

YileAllenChen1, 2022-03-10:
Hi, I noticed that the motor that you are using, it has a ribbon cable instead of normal wires. Could you please tell me how it connects to the PCB board? Thanks.

YileAllenChen1, 2022-03-10:
OK thank!

Closed 2022-03-10.

Thread 17 (2022-07-06):

measurement concern of the system

ClintSun-Git, 2022-07-06:
hello, you have done a great job on this project! I'm working on a sanning lidar based on polygon mirror, I have a critical question. Did you ever meet an issue that when laser rays emit to the mirror, some rays are then directly deflected to the APD lens and received by APD? In that case the distance measured is not right due to this kind of light interference. In my design, I have to use a plastic isolator to block this interference. I don't know is there such interference in your design, or the lidar system is not effected by this kind of interference due to TIA threshold, or TDC principle, etc.
Thank you and good luck!

Kind regards,
Clint

ClintSun-Git, 2022-07-07:
hello,
I upload a structure picture,
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
You can also watch this teardown video of valeo ibeo used on audi, the structure is very similiar.
https://www.bilibili.com/video/BV1dL411A77G?spm_id_from=333.999.0.0&vd_source=899f9c339bd72b974a002ec80689d231.
Did you ever make optical simulation with zemax or tracepro? It's important but very difficult.
By the way, I see MAX3658 is not good enough for your design, maybe you can try MAX3665.

iliasam, 2022-07-07:
"did you ever think about any commercial possiblity of your design or product?"
I think that similar or best Lidars are already exists at the market. LD06 is an example.
Yes, I'm living in Russia now. I don't know about commercial Russian Lidars. I know that non-scanning laser rangefinders are produced here, I heard that a custom-made special Lidars are produced for special industrial devices.
I think that this is because it is to hard to compete with USA/Europe/China Lidars here.

ClintSun-Git, 2022-07-08:
I think the advantage of LD06 is small size and cheap price, it's a very competitive product, but the technical design is poor, the parameters and performance are not clear enough or as good as they say.
I know very less about Russia than USA/Europe, but I know Europe and the world need oil and gas from Russia, and Russia is powerful because you have very strong weapon, and everything is in a dramatic change now. I also think your hard work for open lidar is worthy of respect.

ClintSun-Git, 2022-07-19:
hello, I'm here again and I met an issue in evaluation. I measured START and STOP signals with oscilloscope, in close distance(<30cm), when i moved the target object, the gap between these two pulses was not changed. I use hamamatsu APD and MAX3665. What's the possible reason of this issue, does it possibly caused by TIA? Thank you
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
!

iliasam, 2022-07-19:
Hello.
"when i moved the target object, the gap between these two pulses was not changed"
What is the distance of movement?
You can write me directly to the iliasam@mail.ru

Closed 2022-07-21.

Thread 18 (2023-07-04):

Questions on encoder and disc

buzzzzm, 2023-07-04:

buzzzzm, 2023-07-04:
hi,iliasam,
I have tried to follow the Electronics-assembling notes and test my advice in no-scanning mode.
I found my encoder can’t detect the disc with 65 silts, so I replaced it with a 20 silts disc.
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

When I use the hex file you give, the “testing utility” showed “0x8”-wrong number of encoder events.
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

So, I changed the parameter “ENCODER_HOLES_CNT” to 20.
But the data is not displayed when I run the “testing utility” again. why???
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

Can I change the disc to a 20-slits one?
Or what model of the encoder can detect a 65 silts disc? I want to know the product model. The one I bought doesn’t work well.

iliasam, 2023-07-04:
First question - is your Lidar working well in non-scanning mode?
Possibly FW should work with encoder disc with 20 slits, if you **rebuild** the firmware.
Have you checked that your encoder is working well with an oscilloscope?
I can't give you model of my encoder sensor, because I take it from old printer.
Maybe RPI-352 sensor will work well.

buzzzzm, 2023-07-06:
First, I tested in no-scanning mode, is it working well?
The pictures are calibration page and no optics test results.
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

I checked the encoder with an oscilloscope.

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

I will buy the RPI-353 sensor and test with 65 silts disc.

iliasam, 2023-07-06:
Your results in non-scanning mode are looking OK.
Oscilloscope picture from the encoder is looking well, too. I can't say now what is the problem.
You can check MCU pin 10 with oscilloscope to ensure that encoder pulses are getting to the MCU.

iliasam, 2023-07-06:
[scanning_fw_20_holes.zip](https://github.com/iliasam/OpenTOFLidar/files/11966272/scanning_fw_20_holes.zip)
You can try this FW - I build it for encoder with 20 holes. Also I had increased ENCODER_TIMEOUT_MS value to 25 ms.

buzzzzm, 2023-07-06:
I downloaded the hex file you just sent, but the testing utility doesn't work.
And the BLDC motor rotates at a faster and unstable speed.
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
And I downloaded the hex file "scanning_fw_pcb_v4" again, the state mask is 0x8.
The motor starts fast and then slows down, eventually stabilizing its rotation.
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

iliasam, 2023-07-06:
You can try to use "scanning_fw_20_holes" FW
and set speed of the motor manually at the "Motor Settings" page - see "Motor Manual PWM" -> "Set" button.
Do "Motor Speed" value is measured OK in this mode?

iliasam, 2023-08-02:
Do you have any progress with your problem?

Thread 19 (2023-07-18):

I have a question about LidarTestingUtility.

tmdwhsh, 2023-07-18:
Hi, iliasam.
I have uploaded 'not_scanning_fw_pcb_v4.hex' and the
and noticed that the LED is blinking.
I also checked the 'Laser_Pulse' of the TDC and found that a pulse of about 3V is generated.
I also checked that the voltage of the Vlaser is changing the same as what I set in the Testing Utility.
However, if you look at the picture I attached, you can see that many of the items in the Rangefinder State have been changed to
indicating a 'N/A' state.
Since the voltage is set normally and various values are recorded through 'Start', it seems that the serial communication is working well, but can you tell me why 'N/A' appears?
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

iliasam, 2023-07-18:
Hello. Can you tell me what is the release of firmware that you are using?

tmdwhsh, 2023-07-19:
I used pcb v4 and uploaded 'release2 - not_scanning_fw_pcb_v4.hex'

iliasam, 2023-07-19:
Testinng Utility is decigned for beeing used with firmware from "Release 2" so it is strange that you are getting state data from "Release 1".
You can try to use this dll with "Testinng Utility".
[mavlink.zip](https://github.com/iliasam/OpenTOFLidar/files/12092707/mavlink.zip)

tmdwhsh, 2023-07-19:
I figured out my problem.
When I uploaded Release1, the laser works and N/A appears, but the
When I uploaded Release2, the laser doesn't work, but the N/A is gone.

Any idea what I can do to fix the above (for the laser to work in Release2 as it did in Release1)?

I'll try to test with your DLL file and Release1 first.
Thanks a lot!!!

iliasam, 2023-07-19:
I can see that "Bad communication with TDC after init" bit is set.
I recommend you to check SPI TDC lines soldering at MCU and TDC side.

tmdwhsh, 2023-07-20:
I think it was a soldering issue.
We rechecked the SPI line and found that it was communicating with the laser in Release2.
Thanks!

https://github.com/iliasam/OpenTOFLidar/assets/43981588/7d3b56c7-c1aa-471f-9211-44c28e3576df

Thread 20 (2023-07-25):

I have a problem with Vlaser waveforms

tmdwhsh, 2023-07-25:
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
I measured the VLaser at the J2 terminal, but could see that it did not match the ideal waveform you posted (LaserV_10~16V).
I could see that the amplitude was very large, around 13V, and the overall shape didn't match either.

I measured from J2 using the U.FL terminal and the measurement instrument was a Tektronix TDS 2012C.
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

iliasam, 2023-07-25:
How do you connect your U.FL cable to the oscilloscope?
 Is D7 installed right?

tmdwhsh, 2023-07-25:
I didn't have a U.FL to BNC cable, so I connected a U.FL to SMA cable and an SMA to BNC cable to connect the U.FL terminal of J2 to the oscilloscope.
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

The photo shows the D7 and everything else installed.

Could the above problem occur if the D7 was not installed properly?

I could try replacing the D7 with a new part or reversing the orientation of the D7 and installing it.
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

iliasam, 2023-07-25:
"Could the above problem occur if the D7 was not installed properly?"
Maybe.
Can you give me a photo of your laser diode (PCB from other side)?

tmdwhsh, 2023-07-26:
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

I was able to see the laser light up using a camera and IR detector card.

I will try to replace the D7, starting with what you said

iliasam, 2023-07-26:
"I reversed the connection of the D7 and noticed that the amplitude of the waveform decreased, but it still doesn't look normal."
You need to install diode as it is drawn at the schematic, this diode has a marking line near cathode.

Did you measured with voltmeter voltage at the R18, C17?
Have you selected right divider (1:1) at the oscilloscope channel which is connected to the UFL?
Is Q2 transistor soldered well?
You can check with an oscilloscope probe voltage shape at all lines of Q2.

tmdwhsh, 2023-07-26:
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
First, I thought that the flat part on one side was the Cathode, just like a normal LED, so I installed D7 accordingly, but after looking at the data sheet of SPL90_3, I realized that the flat part was the Anode, so I installed D7 accordingly.
But even after that, the waveform was still the same.

First, I checked the voltage of R18 and C17.
R18 was measuring a very low voltage,
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
C17 was measuring a high voltage of 18-20V.
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

Next, I measured the voltage across the Drain, Gate, and Source of Q2.
For the Drain, we found the same voltage as C17,
For the Gate, it measured around 20V as shown below.
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
For the Source, it was measured as shown below.
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
The soldering condition of Q2 looks normal.

tmdwhsh, 2023-07-27:
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
First I set the Vlaser to 16V, got a clear oscilloscope screen, and measured the Drain, Gate, and Source voltages again.
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
Now I'm going to remove Q2 and measure it the same way and upload it again.

tmdwhsh, 2023-07-27:
This is the waveform of pin 2 of DA6 after removing Q2.
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

iliasam, 2023-07-27:
"First I set the Vlaser to 16V"
But did you measure Vlaser with voltmeter? MCU do not measuring Vlaser, so you need to check that electronics is working OK by yourself.
I can see that you did something, so the shape of voltage at the gate changed (photo from 14:46), now it is looking OK.
Other photos now are looking similar to mine. So you can install Q2 back.
_DA6 pin 6 is not a Gate line._
Did you try to remove UFL cable and measure voltage at the J2 directly with oscilloscope probe? I recommend to use "ground spring" for that: https://electronics.stackexchange.com/questions/40420/what-is-the-name-of-this-springy-type-oscilloscope-probe-accessory

tmdwhsh, 2023-07-27:
Sorry,, That was DA6 pin 2.

First, I verified with a multitester that the Vlaser is 16V.
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

Next, I measured with the default probe(X10) instead of the U.FL.
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

iliasam, 2023-07-27:
I still don't understand what is shown at the photo from 16:44.
Looks like that yellow CH1 is still a signal from UFL, but UFL cable must be disconnected from PCB for tis measurement.

tmdwhsh, 2023-07-27:
I assumed the small terminal next to J2 was the same as the UFL terminal, so I measured it as shown below.
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

iliasam, 2023-07-27:
UFL cable must be disconnected because it create affect to a signal - cable has its own capacity.
It is OK to measure signal at the pin of the UFL connector as you did.
And I repeat again - use "ground spring" to get better results. "Ground spring" is short, so it has less inductance.

tmdwhsh, 2023-07-28:
I took another measurement using a ground spring! (I ordered one from Aliexpress today, but it took a while to ship, so I made a similar one using copper wire)
Does this represent a good enough waveform to proceed to the next step?
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

Thread 21 (2023-09-11):

Calibration and scanning problem

tmdwhsh, 2023-09-11:
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

I got the error "bit2 (0x4) - Wrong hits number from laser comparator" as shown in the photo above and I can't proceed any further.

What can I do to fix a situation like this?

iliasam, 2023-09-11:
Try to check DA5 output with oscilloscope.

tmdwhsh, 2023-09-13:
The above problem occurred while creating the second Tof Lidar!
I'll take your feedback into consideration and keep working on it.

I am in the process of calibrating my first Tof Lidar, measuring distances and calibrating it.
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
I used the Non-Scanning Firmware to set the Refence Distance and compared the value measured by the Testing Utility with the actual measurement using a tape measure and found that I got a very accurate value.

However, due to an incorrect calibration method, the Calibration Graph does not come out ideal (similar to yours) and the Scanning Test Utility does not come out correctly.

Firstly, can you give me a step by step on how to calibrate?
We recorded the data in the following way
1. Upload Non-scanning Firmware.
2. obtained the actual reference length for measurement using a tape measure.
3. set a target for measurement using a wide plate.
4. The measurer stands with the plate at a close point (Ex: 1M), and the Lidar is pointed at the point, and the Reference Distance is set to 1000mm.
5. Start Slow Decoding, and Pressed Start button(Capture Button, top left).
6. The measurer moved away sequentially (0.5M increments), changed the Reference Distance to match, and pressed the Start button (Capture Button) again.
7. repeat the process of Step 6 and use it to get the Calibration Graph and Coefficient.
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
8. After uploading the scanning firmware, send the coefficient obtained in Step 7 to the MCU.
9. Scanning was performed using the Scanning test Utility.

I'm afraid I've done it the wrong way.

iliasam, 2023-09-13:
Please do not mix different questions in one issue!

"Firstly, can you give me a step by step on how to calibrate?"
Please, read Wiki carefully: https://github.com/iliasam/OpenTOFLidar/wiki/Walk-error-calibration
Yes, you do calibration wrong.

tmdwhsh, 2023-09-15:
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
I tried calibrating again and got the same results as above.

iliasam, 2023-09-15:
Did you install "Reference Plate" to your Lidar?
This plate is not described well in Wiki, but it was mentioned in the original article: https://habr-com.translate.goog/ru/articles/485574/?_x_tr_sl=auto&_x_tr_tl=en&_x_tr_hl=en&_x_tr_hist=true
Distance between plate and rotation axis is set in code: https://github.com/iliasam/OpenTOFLidar/blob/f3f400fe56a28f5006bd249ed1249cb4261fe623/Firmware/scanning_fw/config.h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

tmdwhsh, 2023-09-30:
I checked the Reference Plate as you said, and after mounting the Reference Plate and adjusting the zero point of the Encoder Disk appropriately, I confirmed that the scanning result is observed normally.
https://github.com/iliasam/OpenTOFLidar/assets/43981588/1801a132-f785-4406-82c5-934e3e41a8c1

Closed 2023-09-30.

Thread 23 (2023-11-20):

I have a question about LidarTestingUtility.

pikasm, 2023-11-20:
Hello, there was no pulse in my previous TDC. At that time, the request of the program was correct. Now TDC has a pulse and it becomes N/A. Does this mean that my single chip microcomputer is broken?
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

iliasam, 2023-11-20:
Hello.
Is MCU flashed with right firmware?
Check your UART connections.
Check that MCU quartz oscillator is soldered well, wires from  quartz  to MCU is OK.
Do LED blinking? How fast?

pikasm, 2023-11-20:
I tested the frequency of LED. It's 5HZ.

pikasm, 2023-11-20:
![Uploading 微信图片_20231120182430.jpg…]()

pikasm, 2023-11-20:
Here are my test results.
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

pikasm, 2023-11-20:
Should I check if there is something wrong with MCU next?
But my TDC pulse is correct, DA6 also has pulses, J2 also has pulses.
Should I reinstall a DD2?

pikasm, 2023-11-20:
Then I'll check it. Thank you.

pikasm, 2023-11-21:
I replaced the single chip microcomputer and got a signal. Thank you so much. I am so happy.

Closed 2023-11-21.

Thread 25 (2024-01-10):

Increasing pulse width and frequency

taliaxu09, 2024-01-10:
Hello, I would like to increase the power output by increasing the pulse width to be as close to the maximum (I believe 100 ns?) as possible and also increase the frequency from 1 kHz to maybe 5 kHz or 10 kHz.

Would you point me to where I could change this in the code? Can I increase the pulse width by using a larger capacitor?

iliasam, 2024-01-10:
Hello.
1kHz is just test signal frequency, see main.c of "not_scanning_fw" project (TIMER_ELAPSED(timer_1ms) part).
"scanning_fw" reach 10kHz pulse frequency at 15 RPS motor speed.

You can try to increase pulse width by using a larger capacitor, but be careful!

taliaxu09, 2024-01-10:
Thank you! What would be the best software version / setup to compile the code?

iliasam, 2024-01-11:
I don't know what is your hardware, do you need scanning or not, so I can't help you.

taliaxu09, 2024-01-11:
I built it as yours, and I don't need scanning and the motor, I am just using the laser.

I just wanted to know the best setup to be able to compile the code (I only used Keil uvison before) because I saw in another thread that there might be problems if the version is different.

iliasam, 2024-01-11:
I use IAR 7.50 for building this FW.

iliasam, 2024-01-30:
Software counters, like "timer_1ms", are based on "ms_tick" variable, that is incremented in SysTick_Handler(), which is called by system timer with 1ms period.
This timer is configured by SysTick_Config() function in "hardware.c".
A lot of code here is expecting that this timer has 1ms period.

One option is use hardware CAPTURE_TIMER, that is used in "scanning_fw". It can generate interrupts with needed frequency.

Another way - you can use hardware_dwt_get() function, that return MCU tick count (72 ticks per 1us).
You can see dwt_delay_us() function.
But this kind of delay will lock program execution.

taliaxu09, 2024-01-30:
Thank you!

ShanLan12, 2024-06-29:
Hello, I have a question for you, I recently came across a piece of code in my project which uses the MS1005 chip using the stop1 channel and stop2 channel connected to the same pin. A rising edge trigger and a falling edge trigger can be used to get the pulse width and use this pulse width to calibrate the distance measured. May I ask why it does this and how it calibrates the distance
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
Thank you!

iliasam, 2024-06-29:
[ShanLan12](https://github.com/ShanLan12) Please, create new issue for your question.

Closed 2024-01-30.

Thread 26 (2024-01-12):

Problems about motor rotation and rotation program

pikasm, 2024-01-12:
Hello, I installed the motor and downloaded the scanning program today, but my motor doesn't rotate after downloading. After I set the PWM value of the motor, the motor will rotate a little bit. I want to know what the reason is. Can you help me?

https://github.com/iliasam/OpenTOFLidar/assets/147833145/4aeb1ff4-fe31-4ae5-9ec5-f9ace65a8822

https://github.com/iliasam/OpenTOFLidar/assets/147833145/b459526b-1cde-44e1-82a1-86eb3a4d69fa

pikasm, 2024-01-12:
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
Disconnecting the motor can change the PWM. Does this mean that the system does not provide suitable current for the motor?

pikasm, 2024-01-12:
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

pikasm, 2024-01-12:
But my power supply is an instrument, and it doesn't indicate that the current is insufficient. Is it possible that the code wheel of my encoder is not the corresponding number of holes, and the motor will continue to run after I need to change it?

pikasm, 2024-01-12:
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

pikasm, 2024-01-12:
I changed the number of holes, but the motor still doesn't work.

iliasam, 2024-01-12:
When you set PWM manually, motor is not controlled by encoder, it must work in any case.

As I said - check the power line with an oscilloscope when motor is connected.
Motor can take >0.7A at startup.
I had used such board for motor testing in my experiments: https://aliexpress.com/item/1005006219691535.html

pikasm, 2024-01-22:
I tested the motor, and the initial current was really not big enough. I changed the power supply and the motor can rotate normally. Next, I should install the reference board and set the encoder zero angle. I want to know where the zero angle of the encoder should be stuck. Is it the slit irradiated by the encoder when the lens vertically irradiates the reference plate?

pikasm, 2024-01-22:
I changed my encoder, and the number of its slits is 100. What values do I need to change in the rotation test program?
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

iliasam, 2024-01-22:
See this page: https://github.com/iliasam/OpenTOFLidar/wiki/Encoder

pikasm, 2024-01-23:
I installed a reference board and a zero-angle reference mark. I opened the program like this. What else do I need to do next?
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

iliasam, 2024-01-23:
Check encoder output with an oscilloscope.
Ensure that zero pulse is visible.
Ensure that signal amplitude is > 1.2.

pikasm, 2024-01-23:
I checked these two values, and there is no problem. Maybe I should change the start angle and stop angle?Because my code dial is 100 yards.

iliasam, 2024-01-23:
Can you publish your oscilloscope screen image with zero pulse visible?
I don't think that problem is in software.
State mask 0x8 is problem with encoder pulses.

pikasm, 2024-01-23:
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
This is my encoder image, and you can see that the corresponding zero angle is empty.

iliasam, 2024-01-23:
You can see here: https://github.com/iliasam/OpenTOFLidar/wiki/Encoder
that "zero pulse" is keeping high polarity with my hardware.
Zero position -> no light -> no current through opto-transtor -> Encoder output is pulled high by pull-up resistor.

pikasm, 2024-01-24:
I replaced a new encoder, and it showed radar images, but all of them were wrong points. I wonder why?
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

iliasam, 2024-01-24:
State mask: 0x28
You can see here: https://github.com/iliasam/OpenTOFLidar/wiki/State-Mask-bits-description
bit3 (0x8) - Wrong number of encoder events. Encoder is dirty or wrong installed
bit5 (0x20) - Mirror speed is too low or too high
There is problem with your encoder.

pikasm, 2024-01-24:
Should I change the encoder next? Does my code wheel need to be replaced?

iliasam, 2024-01-24:
Check output of the encoder with oscilloscope (at the line at main Lidar PCB).
Ensure that opto-interrupter output in at high state when opto-interrupter light is closed.
You can try to use logic analyzer to capture data from encoder and calculate count of pulses between two zero events.

pikasm, 2024-01-25:
I observed the value of the oscilloscope, perhaps because the diameter of the code wheel is too large and the waveform is a little distorted. Should I replace the code wheel?
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

iliasam, 2024-01-25:
Maybe yes. You can try to change position of the opto-interrupter sensor.

pikasm, 2024-01-29:
I replaced the encoder and encoder again, and now the display is like this. I want to know why there is no image.
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

iliasam, 2024-01-29:
Have you changed "ENCODER_HOLES_CNT" value in your code to "20"?

pikasm, 2024-01-29:
yes

pikasm, 2024-01-29:
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

pikasm, 2024-01-29:
Do I need to calibrate the walking error again after downloading the scanning program?

iliasam, 2024-01-29:
Try to increase ENCODER_TIMEOUT_MS value to 10.
"Do I need to calibrate the walking error again after downloading the scanning program?"
I think - no.

Please make a screenshot with LidarScanningTest with "Pointer Angle" value near 180 deg.
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

pikasm, 2024-01-29:
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
I don't know why, it has no angle value.

pikasm, 2024-01-29:
I have increased the encoder timeout millisecond value to 10.

iliasam, 2024-01-29:
Strange situation.
It looks like that you are receiving "DIST_MEAS_NO_SIGNAL_VALUE". This happens when you have TDC timeout.
Did you try to run "not_scanning_fw" with mirror installed?

pikasm, 2024-01-30:
I downloaded the not scanning program again, and the distance measurement is effective, but the error is 1cm-2cm larger than before.

pikasm, 2024-01-30:
My measurement under the installation mirror is like this

pikasm, 2024-01-30:
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

pikasm, 2024-01-30:
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

pikasm, 2024-01-30:
Is it possible that I am using the wrong iar version? I used 9.30.1.

iliasam, 2024-01-30:
Measurements with mirror installed are looking OK, so it looks like that distance measurement HW is working OK.
My IAR is 7.50, but I don't think that problem is connected with that.
Can you load "scanning_fw" again and check with oscilloscope that you have pulses at "LASER_PULSE" line (motor must be running, encoder must be connected)?

pikasm, 2024-01-30:
I found the problem. There was no laser pulse. After I downloaded the not scanning program, there was a laser pulse. After downloading the not scanning program (after downloading the not scanning program), there was a flashing pulse signal at first, but when I turned on the radar rotary scanning program, there was no correct point, and the pulse disappeared at this time. How should I solve this problem?

pikasm, 2024-01-30:
I found the problem. There was no laser pulse. After I downloaded the not scanning program, there was a laser pulse. After downloading the scanning program (after downloading the not scanning program), there was a flashing pulse signal at first, but when I turned on the radar rotary scanning program, there was no correct point, and the pulse disappeared at this time. How should I solve this problem?

iliasam, 2024-01-30:
Sorry, I don't understand your description well.
As I can understand, you say, that "LidarScanningTest" is making pulses disappear?
Can you describe step by step, what you are doing?

Does motor start running after power on without any commands from PC with "scanning_fw" ?
Is the problem repeatable after Lidar power reset?
Do problem exists if you disconnect wire from PCB RX connector (so MCU can only transmit, but not receive)?

pikasm, 2024-01-30:
I mean, after downloading the scanning program, the pulse signal of the laser began to disappear gradually. Causing me to have no value after rotation measurement.

pikasm, 2024-01-30:
Every time I use the motor, I will set a pwm value and then measure the rotation; The motor does not rotate when it is energized (it stops every time it is energized).

pikasm, 2024-01-30:
There is really no pulse, and I don't know why.

iliasam, 2024-01-30:
"Every time I use the motor, I will set a pwm value and then measure the rotation; The motor does not rotate when it is energized (it stops every time it is energized)."
I don't understand what do you mean by that.

pikasm, 2024-01-30:
I mean, every time I connect the power supply, the motor will not rotate, and then I will use the LidarTestingUtility program to set the PWM value of the motor, and then the motor will start to rotate.

iliasam, 2024-01-30:
You can press yellow "Save to Flash" button at the "Main" page of the "LidarTestingUtility" to save motor settings, so motor will be enabled after Lidar power on.

pikasm, 2024-01-30:
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

pikasm, 2024-01-30:
I have saved the pwm value of the motor, and there is really no laser pulse when using it.

iliasam, 2024-01-30:
Can you check PA2 pin with oscilloscope (P8 pad, see ["PCB_3D_view_up.png"](https://github.com/iliasam/OpenTOFLidar/blob/develop/PCB/PCB_project_v4/PCB_3D_view_up.png)). Motor must be running.
This is test output, MCU set this pin to 1 during reading measurement from TDC.

pikasm, 2024-01-30:
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
I measured its value, and there is no problem.

iliasam, 2024-01-30:
This is looking like a mess, can you give a single measurement, with 1ms in a horizontal grid step?

pikasm, 2024-01-30:
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

iliasam, 2024-01-30:
I need "1 ms", not "10 us" horizontal grid step.

pikasm, 2024-01-30:
Sorry, I misunderstood. Please wait for me for a while. I'm outside now. I'm very sorry.

pikasm, 2024-01-30:
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

pikasm, 2024-01-30:
Do you have any ideas?

pikasm, 2024-01-30:
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

pikasm, 2024-01-30:
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

iliasam, 2024-01-30:
P8 is looking OK. Period is really need to be near 110us if mirror has 12Hz frequency.
So MCU is processing encoder data OK, calculate motor speed OK, one pulse is lasts 30us, so looks like MCU is really trying to read TDC values. So if you see long (>20us) pulses at P8, you must see synchronous laser pulses at  J2.
But I need more time for my own experiments to measure real duration.

You can see in "CAPTURE_TIMER_IRQ_HANDLER", how it is working.

As I advised, you can try to test Lidar with RX pad disconnected, so PC can't affect  to FW.

I build scanning FW for 20 holes, you can try it: [scanning_20_holes.zip](https://github.com/iliasam/OpenTOFLidar/files/14099306/scanning_20_holes.zip)

iliasam, 2024-01-30:
Always check "State mask" value in utilities. It is important thing to understand Lidar internal state.
"State mask" is updated by requests from PC only.

pikasm, 2024-01-30:
Thank you very much. Can you teach me how to use scanning FW for 20 holes?I'm a computer novice.

iliasam, 2024-01-30:
You don't know what to do with HEX file?
Use "STM32 ST-LINK Utility" - https://youtu.be/Zim3ANT_tSE?t=143

pikasm, 2024-01-30:
Yes, thank you for your help. I'm going to study.

pikasm, 2024-01-30:
I studied it. Do you mean that I downloaded this hex file to the single chip microcomputer through the STM32 ST-LINk Utility program?

iliasam, 2024-01-30:
Yes.

pikasm, 2024-01-31:
I have burned the hex file, but the display result is still wrong.
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

pikasm, 2024-01-31:
Is it possible that my single-chip computer or TDC has too much data to process, so there are many wrong points?Because my not scanning measurement is always no problem.

iliasam, 2024-01-31:
"Is it possible that my single-chip computer or TDC has too much data to process, so there are many wrong points? Because my not scanning measurement is always no problem."
No, I don't think so.
I need time to think about this problem.

iliasam, 2024-01-31:
I measured P8 pulse length at my Lidar - it is near 40us, as at yours. So it looks like that your Lidar is trying to read measurements and start new pulses.

Can you check simultaneously P8 line and J2 (laser current) lines by oscilloscope?  Do J2 signal disappear or not?
Also, you said that J1 (APD) signal disappear. But do J2 (laser) signal disappear too?

pikasm, 2024-01-31:
Because the school will have a power outage in recent days, I started to go home at four o'clock this afternoon. I just got home. I will take this test in fifteen days. Thank you for your help. You are an excellent teacher.

pikasm, 2024-01-31:
I seem to have tested this at 2:00 this afternoon, both J2 and p8 signals are present. The J1 signal disappeared because the laser was not emitting light at that time. But I don't think that's the main problem, because when I tested it this afternoon, I found that even if the laser lights up, scanning program measurements are also incorrect.

pikasm, 2024-02-19:
I tested p8 and j1 signals, as follows,
![Uploading 9a8743ecd7d5eedf855e3e68d72e046.jpg…]()
this is p8 signal and this is j1 signal.
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

pikasm, 2024-02-19:
I tested p8j1 and j2 signals. The first picture is p8 signal, the second picture is j1 signal, and the third picture is j2 signal.
p8
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

pikasm, 2024-02-19:
j1
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

pikasm, 2024-02-19:
j1 and p8
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

pikasm, 2024-02-19:
j2
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
j2 and p8
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

pikasm, 2024-02-19:
It still has no measured value.

pikasm, 2024-02-19:
I found a phenomenon: when I open the test program, the signal at j2 will disappear. At this time, I close the test program and open the rotation program, which will display images, but the measured points are all wrong. After that, I turned off the power supply and then turned it on again, and the signal at j2 reappeared. At this time, I directly opened the rotation measurement program, and I found that the points it got were still wrong. I wonder if you have the phenomenon that j2 signal disappears?

iliasam, 2024-02-19:
I don't need "Measurement Summary" images - the are not informative, because signal is not periodic.
Also, it is problematic to say something about P8 and J2 pulses - it is a mess at the screen.
I'm asking you to write - is motor is working or not when you are making measurements.

I need time to do my own tests, it for me it is not OK that laser pulses at J2 disappear.
"when I open the test program, the signal at j2 will disappear"
Can you tell, with operations you are doing in the program?
A don't think thing that J2 disappear just after starting TDC_Testing_v1.exe .

pikasm, 2024-02-19:
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

iliasam, 2024-02-19:
" I only opened the radar test program. When I click open, the j2 signal disappears directly. You can see the picture below."

I don't believe you.
 I can see that "Auto Request Batch" and "Auto requests" switches **are set**. They are disabled by default.

pikasm, 2024-02-19:
Before I clicked open, I checked "Auto Request Batch" and "Auto requests".

pikasm, 2024-02-19:
I just retested it. When I don't check "Auto Request Batch" and "Auto requests" , the pulse will not disappear.

pikasm, 2024-02-19:
Ok, I see. Thank you very much. I can't find the problem now. It still has no result. Do you have any ideas?

pikasm, 2024-02-19:
When I just adopted the radar rotation measurement program v1.1, I found that the State Mask is 0x0 in general. In rare cases, the State Mask is 0x10.

pikasm, 2024-02-19:
I found that my Scan Freq is unstable, and it will change between 12 and 17.

pikasm, 2024-02-19:
The target motor speed I set is 13 RPS.

pikasm, 2024-02-19:
0x10 appears after the motor speed is abnormal. Under normal circumstances, the motor speed is between 12 and 13. When the speed is abnormal, the maximum speed will reach 17, generally changing around 14-15.

iliasam, 2024-02-19:
"In rare cases, the State Mask is 0x10." It is Motor stopped flag, it can appear if encoder is not working stabile.

"I found that my Scan Freq is unstable, and it will change between 12 and 17.'
If you are talking about value in LidarScanningTest1 Utility - that value is calculated by utility from duration between packets, it can be unstable.
More accurate value is at "TDC_Testing_v1" utility at the motor page - "Motor Speed".

pikasm, 2024-02-19:
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

iliasam, 2024-02-19:
Try to set motor PWM manually in TDC_Testing_v1 and check how motor is working.
Minimal speed of my motor is 12.8 RPS at ~350 PWM, motor is rotating at same 12.8 RPS at lower PWM values.
So it is useless to set smaller value in "Motor Target Speed".
When manual PWM is used, my displayed "Motor Speed value is stable, it can jump in 0.1 RPS range.

pikasm, 2024-02-20:
By setting the PWM value, my motor speed is normal: I set the PWM value to 350, and the corresponding radar speed becomes 12.8-12.9 RPS.

But now the points in the scanning test program are still all wrong.

I was wondering if it might be the encoder. I observed our encoder waveform and found two differences.
1. Your waveform seems to be a triangle wave, while mine is a square wave.
2. Your zero position is higher than other positions, and my zero position is the same as other positions.

Are these two differences likely to cause the program not to recognize my angle value? Because there is nothing wrong with my j1, j2 and single-chip signal reading. And there is a distance result when the motor is not rotating.
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

iliasam, 2024-02-20:
"By setting the PWM value, my motor speed is normal: I set the PWM value to 350, and the corresponding radar speed becomes 12.8-12.9 RPS."
I recommend you to keep using this manual mode. Don't forget to save motor settings by pressing "Save to Flash" button.

MCU is using internal comparator: https://github.com/iliasam/OpenTOFLidar/wiki/Encoder
"Comparator reference voltage is 1.2V"
So signal amplitude should not affect to encoder pulses decoction.

pikasm, 2024-02-20:
I have no idea.

pikasm, 2024-02-20:
I don't know why I didn't rotate the scanned image.I'm sad.

pikasm, 2024-02-20:
I observed in the measuring program that the values of Raw TOF and Raw TOF width are constantly changing when rotating, which should prove that there are measurement results back. So I was wondering, is it possible that there was something wrong with the scanning program? Maybe it doesn't work on my computer.
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

iliasam, 2024-02-20:
"I observed in the measuring program that the values of Raw TOF and Raw TOF width are constantly changing when rotating, which should prove that there are measurement results back"
That values are not actual when scanning is working.

iliasam, 2024-02-20:
I added instruction how to use Arduino to simulate encoder - https://github.com/iliasam/OpenTOFLidar/wiki/Encoder
I tested it with 65 and 20 holes - working OK in both cases.

pikasm, 2024-02-20:
Should I replace a set of codewheel, motor and encoder?

iliasam, 2024-02-20:
I don't understand what is wrong with you LIDAR, so I recommend you try to simulate your encoder.
You don't need to have real encoder and motor being connected to the Lidar during simulation.

pikasm, 2024-02-21:
I have downloaded this firmware to the single chip microcomputer, and the display result is like this. Is this normal?
![Uploading 62821576e50c8fd094fbcf28bb53196.jpg…]()

![Uploading e0e78fdaa4eb11c58de90fae4dc4995.jpg…]()

pikasm, 2024-02-21:
I have downloaded this firmware to the single chip microcomputer, and the display result is like this. Is this normal?
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

iliasam, 2024-02-21:
No, it is not OK. Looks like hardware problem.
Can you give me a photo of TDC - I need to see all markings on it.

pikasm, 2024-02-21:
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

iliasam, 2024-02-21:
Lookin as mine, looks that soldered OK.
Strange situation.

iliasam, 2024-02-21:
Try to use this FW:
[scanning_encoder_sim2.zip](https://github.com/iliasam/OpenTOFLidar/files/14356778/scanning_encoder_sim2.zip)

pikasm, 2024-02-21:
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
There is still no result. These are screenshots of the corresponding settings when I downloaded them. Maybe I downloaded them incorrectly?
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

pikasm, 2024-02-21:
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

iliasam, 2024-02-21:
This is strange. I don't know what is difference in 1K/3K.

Try to load your scanning firmware for 20 holes (FW that you build),
Set motor manual PWM = 0, from "TDC_Testing_v1"
Press yellow "Save to Flash" button,
Close  "TDC_Testing_v1",
Reset LIDAR power,
Motor must NOT start after that,
Open UART connection in  "TDC_Testing_v1"
Try to press "Start" button.
Check results in "TDC_Testing_v1"

pikasm, 2024-02-21:
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

iliasam, 2024-02-21:
Thank you. Look like that TDC is working in this state.

Try to use this FW:
[scanning_encoder_sim3.zip](https://github.com/iliasam/OpenTOFLidar/files/14358525/scanning_encoder_sim3.zip)
It is encoder simulation variant.

pikasm, 2024-02-21:
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

iliasam, 2024-02-21:
Still do not work.
It is very strange.

pikasm, 2024-02-21:
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

iliasam, 2024-02-21:
Try to use this FW:
[scanning_fast_batch.zip](https://github.com/iliasam/OpenTOFLidar/files/14359263/scanning_fast_batch.zip)
It is scanning firmware, build for 65 holes, s do not try to use is wit running motor!
Disable motor and do steps which  write here:
https://github.com/iliasam/OpenTOFLidar/issues/26#issuecomment-1956296142

This firmware has fast batch measurement with 100us period (as needed for scanning).
You need to see pulses at P2 after pressing "Start".

pikasm, 2024-02-21:
Is it J2 or P2? P2 seems to be the ground wire.

iliasam, 2024-02-21:
Sorry, J2.

pikasm, 2024-02-21:
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

iliasam, 2024-02-21:
J2 is a laser current, did you check well?
What it the real distance to the object (with 20cm accuracy)?

pikasm, 2024-02-21:
I downloaded the not sacnning program again, and I made sure that there was nothing wrong with my detection method. j2 has a good waveform at this time.

After that, I downloaded the project in the zip file corresponding to 65 holes to the single chip microcomputer. There is no data at this time, and then I set the pwm value to 0 (in fact, it was 0 at the beginning), then saved it to FLASH, and then restarted the power supply, and there is still no data.
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

iliasam, 2024-02-21:
But do you try too press "Start"?

pikasm, 2024-02-21:
Sorry, I forgot to start the batch measurement. Give me a minute.

pikasm, 2024-02-21:
https://github.com/iliasam/OpenTOFLidar/assets/147833145/4d15597c-4752-4c05-9cbe-eb6d49c6dbf1
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

iliasam, 2024-02-21:
"Do "Raw TOF" values change when you change distance to the object?"

pikasm, 2024-02-21:
The value of raw tof will change. It will change when I turn the mirror, and it will change when I put obstacles with different distances in the same direction.
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

Thread 28 (2024-06-29):

How pulse width is calibrated to measure distance

ShanLan12, 2024-06-29:
Hello, I have a question for you, I recently came across a piece of code in my project which uses the MS1005 chip using the stop1 channel and stop2 channel connected to the same pin. A rising edge trigger and a falling edge trigger can be used to get the pulse width and use this pulse width to calibrate the distance measured. May I ask why it does this and how it calibrates the distance

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

Here is the schematic for this project
[XU_MAIN_v13.pdf](https://github.com/user-attachments/files/16039460/XU_MAIN_v13.pdf)
Thank you!

iliasam, 2024-06-29:
Firstly, have you read this - https://github.com/iliasam/OpenTOFLidar/wiki/TDC-data-processing ?
You have connected "STOP1" and "STOP2" lines, so you need to change TDC configuration (comparing with my code).

ShanLan12, 2024-06-30:
Thank you for your answer.
I still don't know what the pulse width has to do with the measured distance, and why you can use the pulse width to correct the measured distance.

iliasam, 2024-06-30:
Try to read this: https://github.com/iliasam/OpenTOFLidar/wiki/Walk-error-calibration and the original article: https://habr.com/ru/articles/485574/

ShanLan12, 2024-07-01:
Thanks!

Closed 2025-01-19.
