iliasam/OpenTOFLidar/(list of files, drawings)

Other design files:
PCB/PCB_project_v1/PCB1.PcbDoc
PCB/PCB_project_v1/Sheet1.SchDoc
PCB/PCB_project_v1/TOF_rangefinder.PrjPcb
PCB/PCB_project_v4/PCB1.PcbDoc
PCB/PCB_project_v4/Sheet1.SchDoc
PCB/PCB_project_v4/TOF_rangefinder.PrjPcb
