iliasam/OpenTOFLidar/Firmware/scanning_fw/config.h

#define __CONFIG_H
#define BOARD_VERSION_2019              1 //PCB_v1
#define BOARD_VERSION_2020              2 //PCB_v4
#define BOARD_VERSION                   BOARD_VERSION_2020
#if (BOARD_VERSION == BOARD_VERSION_2019)
#define DEFAULT_DIST_BIN_LENGTH        (14.5f) //PCB version 2019
#else
#define DEFAULT_DIST_BIN_LENGTH        (15.5f) //PCB version 2020
#endif
#define REF_PLATE_DIST                  (30)
#define MAX_DISTANCE_MM                 (30000)
#define MAX_BIN_LENGTH_MM               (30.0f)
#define LED_GPIO                        GPIOA
#define LED_PIN                         GPIO_Pin_3
#define ADC_SAMPLING_TIME               ADC_SampleTime_1Cycles5
#define APD_FB_ADC_NAME                 ADC2
#define APD_FB_ADC_GPIO                 GPIOB
#define APD_FB_ADC_PIN                  GPIO_Pin_2
#define APD_FB_ADC_CHANNEL              ADC_Channel_12
#define APD_FB_ADC_UPPER_R              (2000.0f * 1.02f)//KOhm
#define APD_FB_ADC_LOWER_R              20.0f//KOhm
#define MCU_VREF                        3.29f //volts
#if (BOARD_VERSION == BOARD_VERSION_2019)
#define APD_PWR_MAX_PWM_VALUE           65 //for AD500-8
#else
#define APD_PWR_MAX_PWM_VALUE           90 //for MTAPD-07
#endif
#define APD_FB_DMA_CLK                  RCC_AHBPeriph_DMA2
#define APD_FB_DMA_CHANNEL              DMA2_Channel1//adc2
#define APD_FB_DMA_DONE_FLAG            DMA2_FLAG_TC1
#define APD_POWER_TIMER_CLK             RCC_APB1Periph_TIM3
#define APD_POWER_TIMER                 TIM3
#define APD_POWER_TIMER_PRESCALER       (1)
#define APD_POWER_TIMER_FREQ            (100 * 1000)  //Hz
#define APD_POWER_TIMER_GPIO_CLK        RCC_AHBPeriph_GPIOA
#define APD_POWER_TIMER_GPIO            GPIOA
#define APD_POWER_TIMER_PIN             GPIO_Pin_7
#define APD_POWER_TIMER_AF_SOURCE       GPIO_PinSource7
#define APD_POWER_TIMER_PIN_AFIO        GPIO_AF_2
#define APD_POWER_TIMER_PWM_REG         CCR2
#define APD_DEFAULT_VOLTAGE             (90.0f)//V
#define APD_DEFAULT_PWM_DUTY            (25)
#define DAC_NAME                        DAC1
#define DAC_GPIO                        GPIOA
#define DAC_MAXIUM                      4095.0f
#define LASER_DAC_PIN                   GPIO_Pin_5
#define LASER_DAC_CHANNEL               DAC_Channel_2
#define APD_COMP_DAC_PIN                GPIO_Pin_4
#define APD_COMP_DAC_CHANNEL            DAC_Channel_1
#define APD_COMP_R_UP                   4700.0f //Ohm - upper
#define APD_COMP_R_MAIN                 1000.0f //Ohm - main - middle
#define APD_COMP_R_DOWN                 20000.0f //Ohm - down
#define APD_COMP_R_COMMON               (APD_COMP_R_UP + APD_COMP_R_MAIN + APD_COMP_R_DOWN)
#define APD_COMP_DEFAULT_VOLT_MV        (50) //mV
#define LASER_DCDC_R_UP                 46000.0f //Ohm - upper
#define LASER_DCDC_R_DOWN               4700.0f //Ohm - down
#define LASER_DCDC_R_DAC                (float)(10000) //Ohm - after dac - R38 + R39
#define LASER_DCDC_VREF                 1.24f //V - internal VREF voltage of the DC-DC
#define LASER_DEFAULT_VOLTAGE           (10.0f) //V
#define TDC_SPI_NAME                    SPI2
#define TDC_SPI_CLK                     RCC_APB1Periph_SPI2
#define TDC_SPI_PORT                    GPIOB
#define TDC_SPI_AFIO                    GPIO_AF_5//spi2
#define TDC_SPI_MOSI                    GPIO_Pin_15
#define TDC_SPI_MOSI_AF                 GPIO_PinSource15
#define TDC_SPI_MISO                    GPIO_Pin_14
#define TDC_SPI_MISO_AF                 GPIO_PinSource14
#define TDC_SPI_SCK                     GPIO_Pin_13
#define TDC_SPI_SCK_AF                  GPIO_PinSource13
#define TDC_SPI_CSN_PORT                GPIOA
#define TDC_SPI_CSN                     GPIO_Pin_9
#define UART_NAME                       USART2
#define UART_CLK                        RCC_APB1Periph_USART2
#define UART_GPIO_CLK                   RCC_AHBPeriph_GPIOB
#define UART_TX_PIN                     GPIO_Pin_3
#define UART_TX_PIN_AF                  GPIO_PinSource3
#define UART_TX_GPIO                    GPIOB
#define UART_RX_PIN                     GPIO_Pin_4
#define UART_RX_PIN_AF                  GPIO_PinSource4
#define UART_RX_GPIO                    GPIOB
#define UART_AFIO                       GPIO_AF_7
#define UART_BAUD                       (500000)
#define UART_RX_IRQ                     USART2_IRQn
#define UART_RX_INT_HANDLER             USART2_IRQHandler
#define UART_DMA_TX_CHANNEL             DMA1_Channel7
#define ENCODER_COMP_GPIO_CLK           RCC_AHBPeriph_GPIOA
#define ENCODER_COMP_PIN                GPIO_Pin_0
#define ENCODER_COMP_GPIO               GPIOA
#define ENCODER_COMP                    COMP_Selection_COMP7
#define ENCODER_COMP_NEG_SRC            COMP_InvertingInput_1_2VREFINT
#define ENCODER_COMP_POS_SRC            COMP_NonInvertingInput_IO1
#define ENCODER_COMP_OUTPUT             COMP_Output_TIM1IC2
#define ENCODER_COMP_TIMER_CLK          RCC_APB2Periph_TIM1
#define ENCODER_COMP_TIMER              TIM1
#define ENCODER_COMP_TIMER_FREQ_HZ      (1e6) //Hz
#define ENCODER_COMP_TIMER_PRESCALER    (uint16_t)(((SystemCoreClock) / \
                              ENCODER_COMP_TIMER_FREQ_HZ) - 1)//APB2 = HCLK
#define ENCODER_COMP_TIMER_CH           TIM_Channel_2
#define ENCODER_COMP_TIMER_IT_FLAG      TIM_IT_CC2
#define ENCODER_COMP_TIMER_IRQ          TIM1_CC_IRQn
#define ENCODER_COMP_TIMER_IRQ_HANDLER  TIM1_CC_IRQHandler
#define ENCODER_COMP_GET_CAPTURD_VALUE  TIM_GetCapture2
#define ENCODER_HOLES_CNT               65
#define ENCODER_TIMEOUT_MS              (5)
#define MOTOR_TIMER_CLK                 RCC_APB1Periph_TIM2
#define MOTOR_TIMER                     TIM2
#define MOTOR_TIMER_PRESCALER           (1)
#define MOTOR_TIMER_FREQ_HZ             20000  //Hz
#if (BOARD_VERSION == BOARD_VERSION_2019)
#define MOTOR_TIMER_GPIO_CLK            RCC_AHBPeriph_GPIOA
#define MOTOR_TIMER_GPIO                GPIOA
#define MOTOR_TIMER_PIN                 GPIO_Pin_1
#define MOTOR_TIMER_AF_SOURCE           GPIO_PinSource1
#define MOTOR_TIMER_PIN_AFIO            GPIO_AF_1
#define MOTOR_TIMER_CHANNEL             2
#define MOTOR_TIMER_PWM_REG             CCR2
#else
#define MOTOR_TIMER_GPIO_CLK            RCC_AHBPeriph_GPIOB
#define MOTOR_TIMER_GPIO                GPIOB
#define MOTOR_TIMER_PIN                 GPIO_Pin_10
#define MOTOR_TIMER_AF_SOURCE           GPIO_PinSource10
#define MOTOR_TIMER_PIN_AFIO            GPIO_AF_1
#define MOTOR_TIMER_CHANNEL             3
#define MOTOR_TIMER_PWM_REG             CCR3
#endif
#define MOTOR_DEFAULT_PWM_DUTY          (340)
#define MOTOR_DEFAULT_SPEED_RPS         (15.0f)
#define MOTOR_CONTROLLING_I_COEF        (1.5f)
#define MOTOR_MAX_SPEED_RPS             (30.0f)
#define MOTOR_MIN_SPEED_RPS             (5.0f)
#define CAPTURE_ANG_RESOL_DEG           (0.5f)
#define CAPTURE_TIMER_CLK               RCC_APB2Periph_TIM8
#define CAPTURE_TIMER                   TIM8
#define CAPTURE_TIMER_PRESCALER         ENCODER_COMP_TIMER_PRESCALER
#define CAPTURE_TIMER_IT_FLAG           TIM_IT_Update
#define CAPTURE_TIMER_IRQ               TIM8_UP_IRQn
#define CAPTURE_TIMER_IRQ_HANDLER       TIM8_UP_IRQHandler
#define TEST_GPIO                       GPIOA
#define TEST_PIN                        GPIO_Pin_2
#define UART_RX_IRQ_PRIORITY            5
#define CAPTURE_TIMER_IRQ_PRIORITY      15
#define ENCODER_COMP_TIMER_IRQ_PRIORITY 10
