iliasam/OpenTOFLidar/Firmware/scanning_fw/TDC/tdc_driver.h

#ifndef __TDC_DRIVER_H
#define __TDC_DRIVER_H

// Includes ------------------------------------------------------------------
#include "stdint.h"

// Exported types ------------------------------------------------------------

typedef struct
{
  // time of flight, bins
  uint16_t start_value; 
  
   //pulse width, bins
  uint16_t width_value;
} tdc_point_t;

// Exported constants --------------------------------------------------------
void tdc_send_reset(void);
void tdc_test(void);
void tdc_configure(void);
void tdc_start_pulse(void);
uint16_t tdc_read_raw_value(void);
tdc_point_t tdc_read_three_registers(void);

#endif //__TDC_DRIVER_H
