iliasam/OpenTOFLidar/Firmware/scanning_fw/dist_measurement.c

/* Includes ------------------------------------------------------------------*/
#include "dist_measurement.h"
#include "hardware.h"
#include "mavlink.h"
#include "tdc_driver.h"
#include "mavlink_handling.h"
#include "nvram.h"
#include "main.h"
#include "config.h"


/* Private typedef -----------------------------------------------------------*/
typedef enum
{
  DIST_MEAS_REF_MEAS_IDLE = 0,
  DIST_MEAS_REF_MEAS_WAIT_FOR_START,
  DIST_MEAS_REF_MEAS_WAIT_FOR_BATCH,
  DIST_MEAS_REF_MEAS_PROCESS,
} dist_meas_ref_meas_state_t;

typedef struct
{
  // time of flight, bins
  float start_value; 
  
   //pulse width, bins
  float width_value;
} tdc_point_float_t;

/* Private define ------------------------------------------------------------*/

// Max number of measured points in batch mode
#define DIST_MEAS_MAX_BATCH_POINTS      200

// Negative distance result
#define DIST_MEAS_NEG_DIST_VALUE        1

// Measured distance is too high
#define DIST_MEAS_MAX_DIST_VALUE        2

// Pulse width is too short -> amplitude is low
#define DIST_MEAS_SHORT_PULSE_VALUE     3

// TDC did not receive signal from APD
#define DIST_MEAS_NO_SIGNAL_VALUE       4

// Calculation error
#define DIST_MEAS_CALC_ERROR            5

/* Private macro -------------------------------------------------------------*/
/* Private variables ---------------------------------------------------------*/
tdc_point_t tdc_capture_buf[DIST_MEAS_MAX_BATCH_POINTS];
uint8_t dist_meas_batch_measurement_needed = 0;

uint16_t dist_meas_batch_points = 100;//max is DIST_MEAS_MAX_BATCH_POINTS

//testing distance to an object in mm
uint16_t test_dist_value = 0;

// Distance to a reference object, used only in non-scanning mode
uint16_t dist_meas_ref_dist_mm = 0;

// Zero offset, bins
// It must be subtracted from measured distance in bins to get true distance in bins
// Updated automatically by measuring distance to the Reference Plate
float dist_meas_zero_offset_bin = 0.0f;

// Minimal allowed pulse width
uint16_t dist_meas_min_width = 0;

dist_meas_ref_meas_state_t dist_meas_need_ref_measurement = 
  DIST_MEAS_REF_MEAS_IDLE;

// Width correction coefficient A
float dist_meas_width_coef_a = 0.0f;
  
// Width correction coefficient B
float dist_meas_width_coef_b = 0.0f;

// BIN length in mm
float dist_meas_bin_length = DEFAULT_DIST_BIN_LENGTH;

// Measured and filtered distance to Reference Plate in bins 
tdc_point_float_t dist_meas_ref_dist_bin;
tdc_point_float_t dist_meas_prev_ref_dist_bin;
float dist_meas_ref_dist_filter_coef = 0.2f;

extern uint16_t tmp_res0;
extern uint16_t tmp_res1;
extern uint16_t device_state_mask;

/* Private function prototypes -----------------------------------------------*/
void dist_measurement_do_batch_meas(void);
void dist_measurement_calculate_zero_offset(uint16_t ref_dist_bin);
uint16_t dist_measurement_calc_avr_dist_bin(void);
void  dist_measurement_measure_ref_bins_handler(void);
void dist_measurement_recalculate_ref_distance(void);
float dist_measurement_calc_corrected_dist_bin(
  uint16_t dist_bin, uint16_t width_bin);
float dist_measurement_calc_corrected_dist_bin_float(
  float dist_bin, float width_bin);

/* Private functions ---------------------------------------------------------*/

void dist_measurement_init(void)
{
  dist_meas_width_coef_a = nvram_data.width_coef_a;
  dist_meas_width_coef_b = nvram_data.width_coef_b;
  dist_meas_zero_offset_bin = (float)nvram_data.zero_offset_bin;
  dist_meas_ref_dist_mm = nvram_data.ref_obj_dist_mm;
  dist_meas_bin_length = nvram_data.tdc_bin_length;
  
  memset((void*)&dist_meas_ref_dist_bin, 0, sizeof(dist_meas_ref_dist_bin));
  memset((void*)&dist_meas_prev_ref_dist_bin, 0, sizeof(dist_meas_prev_ref_dist_bin));
  
  if ((dist_meas_bin_length > MAX_BIN_LENGTH_MM) || 
      (dist_meas_bin_length < 1.0f) || 
      (isnan(dist_meas_bin_length) != 0) || (isinf(dist_meas_bin_length) != 0))
  {
    device_state_mask |= NO_CALIBRATION_FLAG;
  }
  
  if ((dist_meas_width_coef_a == 0.0f) || 
      (dist_meas_width_coef_a > 1e6) ||
      (isnan(dist_meas_width_coef_a) != 0) || 
      (isinf(dist_meas_width_coef_a) != 0) )
  {
    device_state_mask |= NO_CALIBRATION_FLAG;
  }
}

//check if measurement needed
void dist_measurement_handler(void)
{
  if (dist_meas_batch_measurement_needed)
  {
    dist_measurement_do_batch_meas();
    mavlink_send_batch_data();
    dist_meas_batch_measurement_needed = 0;
  }
  dist_measurement_measure_ref_bins_handler();
  dist_measurement_recalculate_ref_distance();
}

// Called by mavlink command
// This command only enables capture process
// It is done in "dist_measurement_do_batch_meas()"
void dist_measurement_start_batch_meas(uint16_t size)
{
  //motor must be stopped for this masurement
  if ((device_state_mask & MIRROR_STOPPED_FLAG) == 0)
    return;
  
  if (size > DIST_MEAS_MAX_BATCH_POINTS)
    size = DIST_MEAS_MAX_BATCH_POINTS;
  
  dist_meas_batch_measurement_needed = 1;
}

// Do batch measurement
// Called periodically form dist_measurement_handler()
// For manual testing
void dist_measurement_do_batch_meas(void)
{
  for (uint16_t i = 0; i < dist_meas_batch_points; i++)
  {
    tdc_start_pulse();
    dwt_delay_ms(1);
    tdc_read_three_registers();
    
    tdc_capture_buf[i].start_value = tmp_res0;
    tdc_capture_buf[i].width_value = tmp_res1;
  }
  dist_measurement_process_current_data();
}

// Start measurement reference distance and zero offset
// dist_mm - real dist to ref object
// For manual testing
void dist_measurement_start_measure_ref(uint16_t dist_mm)
{
  if (dist_meas_need_ref_measurement == DIST_MEAS_REF_MEAS_IDLE)
  {
    dist_meas_need_ref_measurement = DIST_MEAS_REF_MEAS_WAIT_FOR_START;
    dist_meas_ref_dist_mm = dist_mm;
  }
}

// Used for controlling manual reference object calibration
// It is not useful is scanning mode
void  dist_measurement_measure_ref_bins_handler(void)
{
  if (dist_meas_need_ref_measurement == DIST_MEAS_REF_MEAS_WAIT_FOR_START)
  {
    dist_measurement_start_batch_meas(dist_meas_batch_points);
    dist_meas_need_ref_measurement = DIST_MEAS_REF_MEAS_WAIT_FOR_BATCH;
  }
  else if (dist_meas_need_ref_measurement == DIST_MEAS_REF_MEAS_WAIT_FOR_BATCH)
  {
    if (dist_meas_batch_measurement_needed == 0) //data capture done
    {
      dist_meas_need_ref_measurement = DIST_MEAS_REF_MEAS_PROCESS;
      uint16_t avr_dist_bins = dist_measurement_calc_avr_dist_bin();
      
      avr_dist_bins = (uint16_t)round(dist_measurement_calc_corrected_dist_bin(
        avr_dist_bins, tmp_res1));//todo

      dist_measurement_calculate_zero_offset(avr_dist_bins);
      dist_meas_need_ref_measurement = DIST_MEAS_REF_MEAS_IDLE;
    }
  }
}

// Calculate average distance in bins
uint16_t dist_measurement_calc_avr_dist_bin(void)
{
  uint32_t summ = 0;
  
  //skip first point
  for (uint16_t i = 1; i < dist_meas_batch_points; i++)
  {
    summ += tdc_capture_buf[i].start_value;
  }
  return (summ / (dist_meas_batch_points - 1));
}

// We have: 
// 1. "ref_dist_bin" - distance to an object in bins
// 2. "dist_meas_ref_dist_mm" distance to an object in mm
//ref_dist_bin - corrected distance to a reference object, bin
void dist_measurement_calculate_zero_offset(uint16_t ref_dist_bin)
{
  // True distance in bins (with no offset)
  uint16_t true_dist_bin = 
    (uint16_t)roundf((float)dist_meas_ref_dist_mm / dist_meas_bin_length);
  
  if (ref_dist_bin > true_dist_bin)
    dist_meas_zero_offset_bin = (float)(ref_dist_bin - true_dist_bin);
  else
    dist_meas_zero_offset_bin = 0.0f;
}

//testing
uint16_t dist_measurement_process_current_data(void)
{
  return dist_measurement_process_data(tmp_res0, tmp_res1);
}

// Take distance value and return real distance in mm
// start - time of flight in bins
// width - pulse width in bins
uint16_t dist_measurement_process_data(uint16_t start, uint16_t width)
{
  if ((start == 0) || (width == 0))
    return 0;
  
  if (start == 0xFFFF)
    return DIST_MEAS_NO_SIGNAL_VALUE;
  
  if (width < dist_meas_min_width)
    return DIST_MEAS_SHORT_PULSE_VALUE;
  
  // Calculate corrected distance in bins (correct width change)
  float corr_dist_bin = 
    dist_measurement_calc_corrected_dist_bin(start, width);
  
  uint16_t dist_mm = dist_measurement_calc_dist(corr_dist_bin);
  test_dist_value = dist_mm;
  return dist_mm;
}

// CORRECTIONS **********************************************************

// Update calibration values using Reference Plate
// "ref_dist_bin" - distance to a Reference Plate
void dist_measurement_update_ref_value(tdc_point_t ref_dist)
{
//REF_PLATE_DIST
  // Exponential filter
  dist_meas_ref_dist_bin.start_value = dist_meas_ref_dist_filter_coef * 
    (float)ref_dist.start_value + (1.0f - dist_meas_ref_dist_filter_coef) * 
    dist_meas_prev_ref_dist_bin.start_value;
  
  dist_meas_ref_dist_bin.width_value = dist_meas_ref_dist_filter_coef * 
    (float)ref_dist.width_value + (1.0f - dist_meas_ref_dist_filter_coef) * 
    dist_meas_prev_ref_dist_bin.width_value;
  
  dist_meas_prev_ref_dist_bin = dist_meas_ref_dist_bin;
}

// Must be periodically called
// Used in scanning mode
// Calculating "dist_meas_zero_offset_bin" by measuring distance to the Reference Plate
void dist_measurement_recalculate_ref_distance(void)
{
  // True distance in bins (with no offset)
  // This value do not change in time
  float true_dist_bin = (float)REF_PLATE_DIST / dist_meas_bin_length;

  // Corrected MEASURED distance to the Reference Plate in in bins
  float corr_ref_dist_bins = dist_measurement_calc_corrected_dist_bin_float(
    dist_meas_ref_dist_bin.start_value, dist_meas_ref_dist_bin.width_value);
  
  dist_meas_zero_offset_bin = corr_ref_dist_bins - true_dist_bin;
}

// Return distance to an object in mm
// "corr_dist_bin" - distance in bins, previously corrected for width
uint16_t dist_measurement_calc_dist(float corr_dist_bin)
{
  float dist_mm = 
    (corr_dist_bin - dist_meas_zero_offset_bin) * dist_meas_bin_length;
  
  if ( (isnan(dist_mm) != 0) || (isinf(dist_mm) != 0) )
    return DIST_MEAS_CALC_ERROR;
  
  if (dist_mm < -0.01f)
    return DIST_MEAS_NEG_DIST_VALUE;
  
  if (dist_mm > MAX_DISTANCE_MM)
    return DIST_MEAS_MAX_DIST_VALUE;
  
  return (uint16_t)roundf(dist_mm);
}

// Calculate corrected distance in bins (correcting width change)
// dist_bin - raw distance in bins
// width_bin - raw pulse width in bins
// Return distance in bins
float dist_measurement_calc_corrected_dist_bin(
  uint16_t dist_bin, uint16_t width_bin)
{
  if (dist_meas_width_coef_a == 0.0f)
    return 0.0f;
  
  if (dist_bin == 0xFFFF)
    return (float)dist_bin;
  
  float correction = expf((dist_meas_width_coef_a - (float)width_bin) / 
    dist_meas_width_coef_b);
                         
  float result = (float)dist_bin - correction;
  return result;
}

// Calculate corrected distance in bins (correcting width change)
// Now it is used only for calculating zero offset
// Return distance in bins
float dist_measurement_calc_corrected_dist_bin_float(
  float dist_bin, float width_bin)
{
  if (dist_meas_width_coef_a == 0.0f)
    return 0;
  
  float correction = expf((dist_meas_width_coef_a - width_bin) / 
    dist_meas_width_coef_b);
  float result = dist_bin - correction;
  return result;
}

// Change width correction coefficients
// Called by UART command
void dist_measurement_change_width_corr_coeff(
  mavlink_set_width_corr_coeff_t data_msg)
{
  if (data_msg.coeff_a == 0.0f)
    return;
  
  dist_meas_width_coef_a = data_msg.coeff_a;
  dist_meas_width_coef_b = data_msg.coeff_b;
  device_state_mask &= ~NO_CALIBRATION_FLAG;
}
