iliasam/OpenTOFLidar/ROS/open_tof_lidar/include/mavlink_tof/testsuite.h

/** @file
 *    @brief MAVLink comm protocol testsuite generated from mavlink_tof.xml
 *    @see http://qgroundcontrol.org/mavlink/
 */
#pragma once
#ifndef MAVLINK_TOF_TESTSUITE_H
#define MAVLINK_TOF_TESTSUITE_H

#ifdef __cplusplus
extern "C" {
#endif

#ifndef MAVLINK_TEST_ALL
#define MAVLINK_TEST_ALL

static void mavlink_test_mavlink_tof(uint8_t, uint8_t, mavlink_message_t *last_msg);

static void mavlink_test_all(uint8_t system_id, uint8_t component_id, mavlink_message_t *last_msg)
{

    mavlink_test_mavlink_tof(system_id, component_id, last_msg);
}
#endif




static void mavlink_test_data_request(uint8_t system_id, uint8_t component_id, mavlink_message_t *last_msg)
{
#ifdef MAVLINK_STATUS_FLAG_OUT_MAVLINK1
    mavlink_status_t *status = mavlink_get_channel_status(MAVLINK_COMM_0);
        if ((status->flags & MAVLINK_STATUS_FLAG_OUT_MAVLINK1) && MAVLINK_MSG_ID_DATA_REQUEST >= 256) {
            return;
        }
#endif
    mavlink_message_t msg;
        uint8_t buffer[MAVLINK_MAX_PACKET_LEN];
        uint16_t i;
    mavlink_data_request_t packet_in = {
        5
    };
    mavlink_data_request_t packet1, packet2;
        memset(&packet1, 0, sizeof(packet1));
        packet1.data_type = packet_in.data_type;
        
        
#ifdef MAVLINK_STATUS_FLAG_OUT_MAVLINK1
        if (status->flags & MAVLINK_STATUS_FLAG_OUT_MAVLINK1) {
           // cope with extensions
           memset(MAVLINK_MSG_ID_DATA_REQUEST_MIN_LEN + (char *)&packet1, 0, sizeof(packet1)-MAVLINK_MSG_ID_DATA_REQUEST_MIN_LEN);
        }
#endif
        memset(&packet2, 0, sizeof(packet2));
    mavlink_msg_data_request_encode(system_id, component_id, &msg, &packet1);
    mavlink_msg_data_request_decode(&msg, &packet2);
        MAVLINK_ASSERT(memcmp(&packet1, &packet2, sizeof(packet1)) == 0);

        memset(&packet2, 0, sizeof(packet2));
    mavlink_msg_data_request_pack(system_id, component_id, &msg , packet1.data_type );
    mavlink_msg_data_request_decode(&msg, &packet2);
        MAVLINK_ASSERT(memcmp(&packet1, &packet2, sizeof(packet1)) == 0);

        memset(&packet2, 0, sizeof(packet2));
    mavlink_msg_data_request_pack_chan(system_id, component_id, MAVLINK_COMM_0, &msg , packet1.data_type );
    mavlink_msg_data_request_decode(&msg, &packet2);
        MAVLINK_ASSERT(memcmp(&packet1, &packet2, sizeof(packet1)) == 0);

        memset(&packet2, 0, sizeof(packet2));
        mavlink_msg_to_send_buffer(buffer, &msg);
        for (i=0; i<mavlink_msg_get_send_buffer_length(&msg); i++) {
            comm_send_ch(MAVLINK_COMM_0, buffer[i]);
        }
    mavlink_msg_data_request_decode(last_msg, &packet2);
        MAVLINK_ASSERT(memcmp(&packet1, &packet2, sizeof(packet1)) == 0);
        
        memset(&packet2, 0, sizeof(packet2));
    mavlink_msg_data_request_send(MAVLINK_COMM_1 , packet1.data_type );
    mavlink_msg_data_request_decode(last_msg, &packet2);
        MAVLINK_ASSERT(memcmp(&packet1, &packet2, sizeof(packet1)) == 0);
}

static void mavlink_test_device_command(uint8_t system_id, uint8_t component_id, mavlink_message_t *last_msg)
{
#ifdef MAVLINK_STATUS_FLAG_OUT_MAVLINK1
    mavlink_status_t *status = mavlink_get_channel_status(MAVLINK_COMM_0);
        if ((status->flags & MAVLINK_STATUS_FLAG_OUT_MAVLINK1) && MAVLINK_MSG_ID_DEVICE_COMMAND >= 256) {
            return;
        }
#endif
    mavlink_message_t msg;
        uint8_t buffer[MAVLINK_MAX_PACKET_LEN];
        uint16_t i;
    mavlink_device_command_t packet_in = {
        963497464,17
    };
    mavlink_device_command_t packet1, packet2;
        memset(&packet1, 0, sizeof(packet1));
        packet1.value = packet_in.value;
        packet1.cmd = packet_in.cmd;
        
        
#ifdef MAVLINK_STATUS_FLAG_OUT_MAVLINK1
        if (status->flags & MAVLINK_STATUS_FLAG_OUT_MAVLINK1) {
           // cope with extensions
           memset(MAVLINK_MSG_ID_DEVICE_COMMAND_MIN_LEN + (char *)&packet1, 0, sizeof(packet1)-MAVLINK_MSG_ID_DEVICE_COMMAND_MIN_LEN);
        }
#endif
        memset(&packet2, 0, sizeof(packet2));
    mavlink_msg_device_command_encode(system_id, component_id, &msg, &packet1);
    mavlink_msg_device_command_decode(&msg, &packet2);
        MAVLINK_ASSERT(memcmp(&packet1, &packet2, sizeof(packet1)) == 0);

        memset(&packet2, 0, sizeof(packet2));
    mavlink_msg_device_command_pack(system_id, component_id, &msg , packet1.cmd , packet1.value );
    mavlink_msg_device_command_decode(&msg, &packet2);
        MAVLINK_ASSERT(memcmp(&packet1, &packet2, sizeof(packet1)) == 0);

        memset(&packet2, 0, sizeof(packet2));
    mavlink_msg_device_command_pack_chan(system_id, component_id, MAVLINK_COMM_0, &msg , packet1.cmd , packet1.value );
    mavlink_msg_device_command_decode(&msg, &packet2);
        MAVLINK_ASSERT(memcmp(&packet1, &packet2, sizeof(packet1)) == 0);

        memset(&packet2, 0, sizeof(packet2));
        mavlink_msg_to_send_buffer(buffer, &msg);
        for (i=0; i<mavlink_msg_get_send_buffer_length(&msg); i++) {
            comm_send_ch(MAVLINK_COMM_0, buffer[i]);
        }
    mavlink_msg_device_command_decode(last_msg, &packet2);
        MAVLINK_ASSERT(memcmp(&packet1, &packet2, sizeof(packet1)) == 0);
        
        memset(&packet2, 0, sizeof(packet2));
    mavlink_msg_device_command_send(MAVLINK_COMM_1 , packet1.cmd , packet1.value );
    mavlink_msg_device_command_decode(last_msg, &packet2);
        MAVLINK_ASSERT(memcmp(&packet1, &packet2, sizeof(packet1)) == 0);
}

static void mavlink_test_long_packet(uint8_t system_id, uint8_t component_id, mavlink_message_t *last_msg)
{
#ifdef MAVLINK_STATUS_FLAG_OUT_MAVLINK1
    mavlink_status_t *status = mavlink_get_channel_status(MAVLINK_COMM_0);
        if ((status->flags & MAVLINK_STATUS_FLAG_OUT_MAVLINK1) && MAVLINK_MSG_ID_LONG_PACKET >= 256) {
            return;
        }
#endif
    mavlink_message_t msg;
        uint8_t buffer[MAVLINK_MAX_PACKET_LEN];
        uint16_t i;
    mavlink_long_packet_t packet_in = {
        17235,17339,17443,151,218,{ 29, 30, 31, 32, 33, 34, 35, 36, 37, 38, 39, 40, 41, 42, 43, 44, 45, 46, 47, 48, 49, 50, 51, 52, 53, 54, 55, 56, 57, 58, 59, 60, 61, 62, 63, 64, 65, 66, 67, 68, 69, 70, 71, 72, 73, 74, 75, 76, 77, 78, 79, 80, 81, 82, 83, 84, 85, 86, 87, 88, 89, 90, 91, 92, 93, 94, 95, 96, 97, 98, 99, 100, 101, 102, 103, 104, 105, 106, 107, 108, 109, 110, 111, 112, 113, 114, 115, 116, 117, 118, 119, 120, 121, 122, 123, 124, 125, 126, 127, 128, 129, 130, 131, 132, 133, 134, 135, 136, 137, 138, 139, 140, 141, 142, 143, 144, 145, 146, 147, 148, 149, 150, 151, 152, 153, 154, 155, 156, 157, 158, 159, 160, 161, 162, 163, 164, 165, 166, 167, 168, 169, 170, 171, 172, 173, 174, 175, 176, 177, 178, 179, 180, 181, 182, 183, 184, 185, 186, 187, 188, 189, 190, 191, 192, 193, 194, 195, 196, 197, 198, 199, 200, 201, 202, 203, 204, 205, 206, 207, 208, 209, 210, 211, 212, 213, 214, 215, 216, 217, 218, 219, 220, 221, 222, 223, 224, 225, 226, 227, 228 }
    };
    mavlink_long_packet_t packet1, packet2;
        memset(&packet1, 0, sizeof(packet1));
        packet1.packet_id = packet_in.packet_id;
        packet1.packet_cnt = packet_in.packet_cnt;
        packet1.total_cnt = packet_in.total_cnt;
        packet1.data_code = packet_in.data_code;
        packet1.payload_size = packet_in.payload_size;
        
        mav_array_memcpy(packet1.data, packet_in.data, sizeof(uint8_t)*200);
        
#ifdef MAVLINK_STATUS_FLAG_OUT_MAVLINK1
        if (status->flags & MAVLINK_STATUS_FLAG_OUT_MAVLINK1) {
           // cope with extensions
           memset(MAVLINK_MSG_ID_LONG_PACKET_MIN_LEN + (char *)&packet1, 0, sizeof(packet1)-MAVLINK_MSG_ID_LONG_PACKET_MIN_LEN);
        }
#endif
        memset(&packet2, 0, sizeof(packet2));
    mavlink_msg_long_packet_encode(system_id, component_id, &msg, &packet1);
    mavlink_msg_long_packet_decode(&msg, &packet2);
        MAVLINK_ASSERT(memcmp(&packet1, &packet2, sizeof(packet1)) == 0);

        memset(&packet2, 0, sizeof(packet2));
    mavlink_msg_long_packet_pack(system_id, component_id, &msg , packet1.data_code , packet1.packet_id , packet1.packet_cnt , packet1.total_cnt , packet1.payload_size , packet1.data );
    mavlink_msg_long_packet_decode(&msg, &packet2);
        MAVLINK_ASSERT(memcmp(&packet1, &packet2, sizeof(packet1)) == 0);

        memset(&packet2, 0, sizeof(packet2));
    mavlink_msg_long_packet_pack_chan(system_id, component_id, MAVLINK_COMM_0, &msg , packet1.data_code , packet1.packet_id , packet1.packet_cnt , packet1.total_cnt , packet1.payload_size , packet1.data );
    mavlink_msg_long_packet_decode(&msg, &packet2);
        MAVLINK_ASSERT(memcmp(&packet1, &packet2, sizeof(packet1)) == 0);

        memset(&packet2, 0, sizeof(packet2));
        mavlink_msg_to_send_buffer(buffer, &msg);
        for (i=0; i<mavlink_msg_get_send_buffer_length(&msg); i++) {
            comm_send_ch(MAVLINK_COMM_0, buffer[i]);
        }
    mavlink_msg_long_packet_decode(last_msg, &packet2);
        MAVLINK_ASSERT(memcmp(&packet1, &packet2, sizeof(packet1)) == 0);
        
        memset(&packet2, 0, sizeof(packet2));
    mavlink_msg_long_packet_send(MAVLINK_COMM_1 , packet1.data_code , packet1.packet_id , packet1.packet_cnt , packet1.total_cnt , packet1.payload_size , packet1.data );
    mavlink_msg_long_packet_decode(last_msg, &packet2);
        MAVLINK_ASSERT(memcmp(&packet1, &packet2, sizeof(packet1)) == 0);
}

static void mavlink_test_set_apd_voltage(uint8_t system_id, uint8_t component_id, mavlink_message_t *last_msg)
{
#ifdef MAVLINK_STATUS_FLAG_OUT_MAVLINK1
    mavlink_status_t *status = mavlink_get_channel_status(MAVLINK_COMM_0);
        if ((status->flags & MAVLINK_STATUS_FLAG_OUT_MAVLINK1) && MAVLINK_MSG_ID_SET_APD_VOLTAGE >= 256) {
            return;
        }
#endif
    mavlink_message_t msg;
        uint8_t buffer[MAVLINK_MAX_PACKET_LEN];
        uint16_t i;
    mavlink_set_apd_voltage_t packet_in = {
        17.0,17443
    };
    mavlink_set_apd_voltage_t packet1, packet2;
        memset(&packet1, 0, sizeof(packet1));
        packet1.voltage = packet_in.voltage;
        packet1.pwm_value = packet_in.pwm_value;
        
        
#ifdef MAVLINK_STATUS_FLAG_OUT_MAVLINK1
        if (status->flags & MAVLINK_STATUS_FLAG_OUT_MAVLINK1) {
           // cope with extensions
           memset(MAVLINK_MSG_ID_SET_APD_VOLTAGE_MIN_LEN + (char *)&packet1, 0, sizeof(packet1)-MAVLINK_MSG_ID_SET_APD_VOLTAGE_MIN_LEN);
        }
#endif
        memset(&packet2, 0, sizeof(packet2));
    mavlink_msg_set_apd_voltage_encode(system_id, component_id, &msg, &packet1);
    mavlink_msg_set_apd_voltage_decode(&msg, &packet2);
        MAVLINK_ASSERT(memcmp(&packet1, &packet2, sizeof(packet1)) == 0);

        memset(&packet2, 0, sizeof(packet2));
    mavlink_msg_set_apd_voltage_pack(system_id, component_id, &msg , packet1.pwm_value , packet1.voltage );
    mavlink_msg_set_apd_voltage_decode(&msg, &packet2);
        MAVLINK_ASSERT(memcmp(&packet1, &packet2, sizeof(packet1)) == 0);

        memset(&packet2, 0, sizeof(packet2));
    mavlink_msg_set_apd_voltage_pack_chan(system_id, component_id, MAVLINK_COMM_0, &msg , packet1.pwm_value , packet1.voltage );
    mavlink_msg_set_apd_voltage_decode(&msg, &packet2);
        MAVLINK_ASSERT(memcmp(&packet1, &packet2, sizeof(packet1)) == 0);

        memset(&packet2, 0, sizeof(packet2));
        mavlink_msg_to_send_buffer(buffer, &msg);
        for (i=0; i<mavlink_msg_get_send_buffer_length(&msg); i++) {
            comm_send_ch(MAVLINK_COMM_0, buffer[i]);
        }
    mavlink_msg_set_apd_voltage_decode(last_msg, &packet2);
        MAVLINK_ASSERT(memcmp(&packet1, &packet2, sizeof(packet1)) == 0);
        
        memset(&packet2, 0, sizeof(packet2));
    mavlink_msg_set_apd_voltage_send(MAVLINK_COMM_1 , packet1.pwm_value , packet1.voltage );
    mavlink_msg_set_apd_voltage_decode(last_msg, &packet2);
        MAVLINK_ASSERT(memcmp(&packet1, &packet2, sizeof(packet1)) == 0);
}

static void mavlink_test_set_laser_voltage(uint8_t system_id, uint8_t component_id, mavlink_message_t *last_msg)
{
#ifdef MAVLINK_STATUS_FLAG_OUT_MAVLINK1
    mavlink_status_t *status = mavlink_get_channel_status(MAVLINK_COMM_0);
        if ((status->flags & MAVLINK_STATUS_FLAG_OUT_MAVLINK1) && MAVLINK_MSG_ID_SET_LASER_VOLTAGE >= 256) {
            return;
        }
#endif
    mavlink_message_t msg;
        uint8_t buffer[MAVLINK_MAX_PACKET_LEN];
        uint16_t i;
    mavlink_set_laser_voltage_t packet_in = {
        17.0
    };
    mavlink_set_laser_voltage_t packet1, packet2;
        memset(&packet1, 0, sizeof(packet1));
        packet1.voltage = packet_in.voltage;
        
        
#ifdef MAVLINK_STATUS_FLAG_OUT_MAVLINK1
        if (status->flags & MAVLINK_STATUS_FLAG_OUT_MAVLINK1) {
           // cope with extensions
           memset(MAVLINK_MSG_ID_SET_LASER_VOLTAGE_MIN_LEN + (char *)&packet1, 0, sizeof(packet1)-MAVLINK_MSG_ID_SET_LASER_VOLTAGE_MIN_LEN);
        }
#endif
        memset(&packet2, 0, sizeof(packet2));
    mavlink_msg_set_laser_voltage_encode(system_id, component_id, &msg, &packet1);
    mavlink_msg_set_laser_voltage_decode(&msg, &packet2);
        MAVLINK_ASSERT(memcmp(&packet1, &packet2, sizeof(packet1)) == 0);

        memset(&packet2, 0, sizeof(packet2));
    mavlink_msg_set_laser_voltage_pack(system_id, component_id, &msg , packet1.voltage );
    mavlink_msg_set_laser_voltage_decode(&msg, &packet2);
        MAVLINK_ASSERT(memcmp(&packet1, &packet2, sizeof(packet1)) == 0);

        memset(&packet2, 0, sizeof(packet2));
    mavlink_msg_set_laser_voltage_pack_chan(system_id, component_id, MAVLINK_COMM_0, &msg , packet1.voltage );
    mavlink_msg_set_laser_voltage_decode(&msg, &packet2);
        MAVLINK_ASSERT(memcmp(&packet1, &packet2, sizeof(packet1)) == 0);

        memset(&packet2, 0, sizeof(packet2));
        mavlink_msg_to_send_buffer(buffer, &msg);
        for (i=0; i<mavlink_msg_get_send_buffer_length(&msg); i++) {
            comm_send_ch(MAVLINK_COMM_0, buffer[i]);
        }
    mavlink_msg_set_laser_voltage_decode(last_msg, &packet2);
        MAVLINK_ASSERT(memcmp(&packet1, &packet2, sizeof(packet1)) == 0);
        
        memset(&packet2, 0, sizeof(packet2));
    mavlink_msg_set_laser_voltage_send(MAVLINK_COMM_1 , packet1.voltage );
    mavlink_msg_set_laser_voltage_decode(last_msg, &packet2);
        MAVLINK_ASSERT(memcmp(&packet1, &packet2, sizeof(packet1)) == 0);
}

static void mavlink_test_set_comp_threshold(uint8_t system_id, uint8_t component_id, mavlink_message_t *last_msg)
{
#ifdef MAVLINK_STATUS_FLAG_OUT_MAVLINK1
    mavlink_status_t *status = mavlink_get_channel_status(MAVLINK_COMM_0);
        if ((status->flags & MAVLINK_STATUS_FLAG_OUT_MAVLINK1) && MAVLINK_MSG_ID_SET_COMP_THRESHOLD >= 256) {
            return;
        }
#endif
    mavlink_message_t msg;
        uint8_t buffer[MAVLINK_MAX_PACKET_LEN];
        uint16_t i;
    mavlink_set_comp_threshold_t packet_in = {
        17235
    };
    mavlink_set_comp_threshold_t packet1, packet2;
        memset(&packet1, 0, sizeof(packet1));
        packet1.voltage_mv = packet_in.voltage_mv;
        
        
#ifdef MAVLINK_STATUS_FLAG_OUT_MAVLINK1
        if (status->flags & MAVLINK_STATUS_FLAG_OUT_MAVLINK1) {
           // cope with extensions
           memset(MAVLINK_MSG_ID_SET_COMP_THRESHOLD_MIN_LEN + (char *)&packet1, 0, sizeof(packet1)-MAVLINK_MSG_ID_SET_COMP_THRESHOLD_MIN_LEN);
        }
#endif
        memset(&packet2, 0, sizeof(packet2));
    mavlink_msg_set_comp_threshold_encode(system_id, component_id, &msg, &packet1);
    mavlink_msg_set_comp_threshold_decode(&msg, &packet2);
        MAVLINK_ASSERT(memcmp(&packet1, &packet2, sizeof(packet1)) == 0);

        memset(&packet2, 0, sizeof(packet2));
    mavlink_msg_set_comp_threshold_pack(system_id, component_id, &msg , packet1.voltage_mv );
    mavlink_msg_set_comp_threshold_decode(&msg, &packet2);
        MAVLINK_ASSERT(memcmp(&packet1, &packet2, sizeof(packet1)) == 0);

        memset(&packet2, 0, sizeof(packet2));
    mavlink_msg_set_comp_threshold_pack_chan(system_id, component_id, MAVLINK_COMM_0, &msg , packet1.voltage_mv );
    mavlink_msg_set_comp_threshold_decode(&msg, &packet2);
        MAVLINK_ASSERT(memcmp(&packet1, &packet2, sizeof(packet1)) == 0);

        memset(&packet2, 0, sizeof(packet2));
        mavlink_msg_to_send_buffer(buffer, &msg);
        for (i=0; i<mavlink_msg_get_send_buffer_length(&msg); i++) {
            comm_send_ch(MAVLINK_COMM_0, buffer[i]);
        }
    mavlink_msg_set_comp_threshold_decode(last_msg, &packet2);
        MAVLINK_ASSERT(memcmp(&packet1, &packet2, sizeof(packet1)) == 0);
        
        memset(&packet2, 0, sizeof(packet2));
    mavlink_msg_set_comp_threshold_send(MAVLINK_COMM_1 , packet1.voltage_mv );
    mavlink_msg_set_comp_threshold_decode(last_msg, &packet2);
        MAVLINK_ASSERT(memcmp(&packet1, &packet2, sizeof(packet1)) == 0);
}

static void mavlink_test_start_batch_measurement(uint8_t system_id, uint8_t component_id, mavlink_message_t *last_msg)
{
#ifdef MAVLINK_STATUS_FLAG_OUT_MAVLINK1
    mavlink_status_t *status = mavlink_get_channel_status(MAVLINK_COMM_0);
        if ((status->flags & MAVLINK_STATUS_FLAG_OUT_MAVLINK1) && MAVLINK_MSG_ID_START_BATCH_MEASUREMENT >= 256) {
            return;
        }
#endif
    mavlink_message_t msg;
        uint8_t buffer[MAVLINK_MAX_PACKET_LEN];
        uint16_t i;
    mavlink_start_batch_measurement_t packet_in = {
        17235
    };
    mavlink_start_batch_measurement_t packet1, packet2;
        memset(&packet1, 0, sizeof(packet1));
        packet1.length = packet_in.length;
        
        
#ifdef MAVLINK_STATUS_FLAG_OUT_MAVLINK1
        if (status->flags & MAVLINK_STATUS_FLAG_OUT_MAVLINK1) {
           // cope with extensions
           memset(MAVLINK_MSG_ID_START_BATCH_MEASUREMENT_MIN_LEN + (char *)&packet1, 0, sizeof(packet1)-MAVLINK_MSG_ID_START_BATCH_MEASUREMENT_MIN_LEN);
        }
#endif
        memset(&packet2, 0, sizeof(packet2));
    mavlink_msg_start_batch_measurement_encode(system_id, component_id, &msg, &packet1);
    mavlink_msg_start_batch_measurement_decode(&msg, &packet2);
        MAVLINK_ASSERT(memcmp(&packet1, &packet2, sizeof(packet1)) == 0);

        memset(&packet2, 0, sizeof(packet2));
    mavlink_msg_start_batch_measurement_pack(system_id, component_id, &msg , packet1.length );
    mavlink_msg_start_batch_measurement_decode(&msg, &packet2);
        MAVLINK_ASSERT(memcmp(&packet1, &packet2, sizeof(packet1)) == 0);

        memset(&packet2, 0, sizeof(packet2));
    mavlink_msg_start_batch_measurement_pack_chan(system_id, component_id, MAVLINK_COMM_0, &msg , packet1.length );
    mavlink_msg_start_batch_measurement_decode(&msg, &packet2);
        MAVLINK_ASSERT(memcmp(&packet1, &packet2, sizeof(packet1)) == 0);

        memset(&packet2, 0, sizeof(packet2));
        mavlink_msg_to_send_buffer(buffer, &msg);
        for (i=0; i<mavlink_msg_get_send_buffer_length(&msg); i++) {
            comm_send_ch(MAVLINK_COMM_0, buffer[i]);
        }
    mavlink_msg_start_batch_measurement_decode(last_msg, &packet2);
        MAVLINK_ASSERT(memcmp(&packet1, &packet2, sizeof(packet1)) == 0);
        
        memset(&packet2, 0, sizeof(packet2));
    mavlink_msg_start_batch_measurement_send(MAVLINK_COMM_1 , packet1.length );
    mavlink_msg_start_batch_measurement_decode(last_msg, &packet2);
        MAVLINK_ASSERT(memcmp(&packet1, &packet2, sizeof(packet1)) == 0);
}

static void mavlink_test_start_corr_batch_measurement(uint8_t system_id, uint8_t component_id, mavlink_message_t *last_msg)
{
#ifdef MAVLINK_STATUS_FLAG_OUT_MAVLINK1
    mavlink_status_t *status = mavlink_get_channel_status(MAVLINK_COMM_0);
        if ((status->flags & MAVLINK_STATUS_FLAG_OUT_MAVLINK1) && MAVLINK_MSG_ID_START_CORR_BATCH_MEASUREMENT >= 256) {
            return;
        }
#endif
    mavlink_message_t msg;
        uint8_t buffer[MAVLINK_MAX_PACKET_LEN];
        uint16_t i;
    mavlink_start_corr_batch_measurement_t packet_in = {
        17235
    };
    mavlink_start_corr_batch_measurement_t packet1, packet2;
        memset(&packet1, 0, sizeof(packet1));
        packet1.length = packet_in.length;
        
        
#ifdef MAVLINK_STATUS_FLAG_OUT_MAVLINK1
        if (status->flags & MAVLINK_STATUS_FLAG_OUT_MAVLINK1) {
           // cope with extensions
           memset(MAVLINK_MSG_ID_START_CORR_BATCH_MEASUREMENT_MIN_LEN + (char *)&packet1, 0, sizeof(packet1)-MAVLINK_MSG_ID_START_CORR_BATCH_MEASUREMENT_MIN_LEN);
        }
#endif
        memset(&packet2, 0, sizeof(packet2));
    mavlink_msg_start_corr_batch_measurement_encode(system_id, component_id, &msg, &packet1);
    mavlink_msg_start_corr_batch_measurement_decode(&msg, &packet2);
        MAVLINK_ASSERT(memcmp(&packet1, &packet2, sizeof(packet1)) == 0);

        memset(&packet2, 0, sizeof(packet2));
    mavlink_msg_start_corr_batch_measurement_pack(system_id, component_id, &msg , packet1.length );
    mavlink_msg_start_corr_batch_measurement_decode(&msg, &packet2);
        MAVLINK_ASSERT(memcmp(&packet1, &packet2, sizeof(packet1)) == 0);

        memset(&packet2, 0, sizeof(packet2));
    mavlink_msg_start_corr_batch_measurement_pack_chan(system_id, component_id, MAVLINK_COMM_0, &msg , packet1.length );
    mavlink_msg_start_corr_batch_measurement_decode(&msg, &packet2);
        MAVLINK_ASSERT(memcmp(&packet1, &packet2, sizeof(packet1)) == 0);

        memset(&packet2, 0, sizeof(packet2));
        mavlink_msg_to_send_buffer(buffer, &msg);
        for (i=0; i<mavlink_msg_get_send_buffer_length(&msg); i++) {
            comm_send_ch(MAVLINK_COMM_0, buffer[i]);
        }
    mavlink_msg_start_corr_batch_measurement_decode(last_msg, &packet2);
        MAVLINK_ASSERT(memcmp(&packet1, &packet2, sizeof(packet1)) == 0);
        
        memset(&packet2, 0, sizeof(packet2));
    mavlink_msg_start_corr_batch_measurement_send(MAVLINK_COMM_1 , packet1.length );
    mavlink_msg_start_corr_batch_measurement_decode(last_msg, &packet2);
        MAVLINK_ASSERT(memcmp(&packet1, &packet2, sizeof(packet1)) == 0);
}

static void mavlink_test_set_width_corr_coeff(uint8_t system_id, uint8_t component_id, mavlink_message_t *last_msg)
{
#ifdef MAVLINK_STATUS_FLAG_OUT_MAVLINK1
    mavlink_status_t *status = mavlink_get_channel_status(MAVLINK_COMM_0);
        if ((status->flags & MAVLINK_STATUS_FLAG_OUT_MAVLINK1) && MAVLINK_MSG_ID_SET_WIDTH_CORR_COEFF >= 256) {
            return;
        }
#endif
    mavlink_message_t msg;
        uint8_t buffer[MAVLINK_MAX_PACKET_LEN];
        uint16_t i;
    mavlink_set_width_corr_coeff_t packet_in = {
        17.0,45.0
    };
    mavlink_set_width_corr_coeff_t packet1, packet2;
        memset(&packet1, 0, sizeof(packet1));
        packet1.coeff_a = packet_in.coeff_a;
        packet1.coeff_b = packet_in.coeff_b;
        
        
#ifdef MAVLINK_STATUS_FLAG_OUT_MAVLINK1
        if (status->flags & MAVLINK_STATUS_FLAG_OUT_MAVLINK1) {
           // cope with extensions
           memset(MAVLINK_MSG_ID_SET_WIDTH_CORR_COEFF_MIN_LEN + (char *)&packet1, 0, sizeof(packet1)-MAVLINK_MSG_ID_SET_WIDTH_CORR_COEFF_MIN_LEN);
        }
#endif
        memset(&packet2, 0, sizeof(packet2));
    mavlink_msg_set_width_corr_coeff_encode(system_id, component_id, &msg, &packet1);
    mavlink_msg_set_width_corr_coeff_decode(&msg, &packet2);
        MAVLINK_ASSERT(memcmp(&packet1, &packet2, sizeof(packet1)) == 0);

        memset(&packet2, 0, sizeof(packet2));
    mavlink_msg_set_width_corr_coeff_pack(system_id, component_id, &msg , packet1.coeff_a , packet1.coeff_b );
    mavlink_msg_set_width_corr_coeff_decode(&msg, &packet2);
        MAVLINK_ASSERT(memcmp(&packet1, &packet2, sizeof(packet1)) == 0);

        memset(&packet2, 0, sizeof(packet2));
    mavlink_msg_set_width_corr_coeff_pack_chan(system_id, component_id, MAVLINK_COMM_0, &msg , packet1.coeff_a , packet1.coeff_b );
    mavlink_msg_set_width_corr_coeff_decode(&msg, &packet2);
        MAVLINK_ASSERT(memcmp(&packet1, &packet2, sizeof(packet1)) == 0);

        memset(&packet2, 0, sizeof(packet2));
        mavlink_msg_to_send_buffer(buffer, &msg);
        for (i=0; i<mavlink_msg_get_send_buffer_length(&msg); i++) {
            comm_send_ch(MAVLINK_COMM_0, buffer[i]);
        }
    mavlink_msg_set_width_corr_coeff_decode(last_msg, &packet2);
        MAVLINK_ASSERT(memcmp(&packet1, &packet2, sizeof(packet1)) == 0);
        
        memset(&packet2, 0, sizeof(packet2));
    mavlink_msg_set_width_corr_coeff_send(MAVLINK_COMM_1 , packet1.coeff_a , packet1.coeff_b );
    mavlink_msg_set_width_corr_coeff_decode(last_msg, &packet2);
        MAVLINK_ASSERT(memcmp(&packet1, &packet2, sizeof(packet1)) == 0);
}

static void mavlink_test_set_ref_offset(uint8_t system_id, uint8_t component_id, mavlink_message_t *last_msg)
{
#ifdef MAVLINK_STATUS_FLAG_OUT_MAVLINK1
    mavlink_status_t *status = mavlink_get_channel_status(MAVLINK_COMM_0);
        if ((status->flags & MAVLINK_STATUS_FLAG_OUT_MAVLINK1) && MAVLINK_MSG_ID_SET_REF_OFFSET >= 256) {
            return;
        }
#endif
    mavlink_message_t msg;
        uint8_t buffer[MAVLINK_MAX_PACKET_LEN];
        uint16_t i;
    mavlink_set_ref_offset_t packet_in = {
        17235
    };
    mavlink_set_ref_offset_t packet1, packet2;
        memset(&packet1, 0, sizeof(packet1));
        packet1.dist_value = packet_in.dist_value;
        
        
#ifdef MAVLINK_STATUS_FLAG_OUT_MAVLINK1
        if (status->flags & MAVLINK_STATUS_FLAG_OUT_MAVLINK1) {
           // cope with extensions
           memset(MAVLINK_MSG_ID_SET_REF_OFFSET_MIN_LEN + (char *)&packet1, 0, sizeof(packet1)-MAVLINK_MSG_ID_SET_REF_OFFSET_MIN_LEN);
        }
#endif
        memset(&packet2, 0, sizeof(packet2));
    mavlink_msg_set_ref_offset_encode(system_id, component_id, &msg, &packet1);
    mavlink_msg_set_ref_offset_decode(&msg, &packet2);
        MAVLINK_ASSERT(memcmp(&packet1, &packet2, sizeof(packet1)) == 0);

        memset(&packet2, 0, sizeof(packet2));
    mavlink_msg_set_ref_offset_pack(system_id, component_id, &msg , packet1.dist_value );
    mavlink_msg_set_ref_offset_decode(&msg, &packet2);
        MAVLINK_ASSERT(memcmp(&packet1, &packet2, sizeof(packet1)) == 0);

        memset(&packet2, 0, sizeof(packet2));
    mavlink_msg_set_ref_offset_pack_chan(system_id, component_id, MAVLINK_COMM_0, &msg , packet1.dist_value );
    mavlink_msg_set_ref_offset_decode(&msg, &packet2);
        MAVLINK_ASSERT(memcmp(&packet1, &packet2, sizeof(packet1)) == 0);

        memset(&packet2, 0, sizeof(packet2));
        mavlink_msg_to_send_buffer(buffer, &msg);
        for (i=0; i<mavlink_msg_get_send_buffer_length(&msg); i++) {
            comm_send_ch(MAVLINK_COMM_0, buffer[i]);
        }
    mavlink_msg_set_ref_offset_decode(last_msg, &packet2);
        MAVLINK_ASSERT(memcmp(&packet1, &packet2, sizeof(packet1)) == 0);
        
        memset(&packet2, 0, sizeof(packet2));
    mavlink_msg_set_ref_offset_send(MAVLINK_COMM_1 , packet1.dist_value );
    mavlink_msg_set_ref_offset_decode(last_msg, &packet2);
        MAVLINK_ASSERT(memcmp(&packet1, &packet2, sizeof(packet1)) == 0);
}

static void mavlink_test_set_motor_duty(uint8_t system_id, uint8_t component_id, mavlink_message_t *last_msg)
{
#ifdef MAVLINK_STATUS_FLAG_OUT_MAVLINK1
    mavlink_status_t *status = mavlink_get_channel_status(MAVLINK_COMM_0);
        if ((status->flags & MAVLINK_STATUS_FLAG_OUT_MAVLINK1) && MAVLINK_MSG_ID_SET_MOTOR_DUTY >= 256) {
            return;
        }
#endif
    mavlink_message_t msg;
        uint8_t buffer[MAVLINK_MAX_PACKET_LEN];
        uint16_t i;
    mavlink_set_motor_duty_t packet_in = {
        17235
    };
    mavlink_set_motor_duty_t packet1, packet2;
        memset(&packet1, 0, sizeof(packet1));
        packet1.duty = packet_in.duty;
        
        
#ifdef MAVLINK_STATUS_FLAG_OUT_MAVLINK1
        if (status->flags & MAVLINK_STATUS_FLAG_OUT_MAVLINK1) {
           // cope with extensions
           memset(MAVLINK_MSG_ID_SET_MOTOR_DUTY_MIN_LEN + (char *)&packet1, 0, sizeof(packet1)-MAVLINK_MSG_ID_SET_MOTOR_DUTY_MIN_LEN);
        }
#endif
        memset(&packet2, 0, sizeof(packet2));
    mavlink_msg_set_motor_duty_encode(system_id, component_id, &msg, &packet1);
    mavlink_msg_set_motor_duty_decode(&msg, &packet2);
        MAVLINK_ASSERT(memcmp(&packet1, &packet2, sizeof(packet1)) == 0);

        memset(&packet2, 0, sizeof(packet2));
    mavlink_msg_set_motor_duty_pack(system_id, component_id, &msg , packet1.duty );
    mavlink_msg_set_motor_duty_decode(&msg, &packet2);
        MAVLINK_ASSERT(memcmp(&packet1, &packet2, sizeof(packet1)) == 0);

        memset(&packet2, 0, sizeof(packet2));
    mavlink_msg_set_motor_duty_pack_chan(system_id, component_id, MAVLINK_COMM_0, &msg , packet1.duty );
    mavlink_msg_set_motor_duty_decode(&msg, &packet2);
        MAVLINK_ASSERT(memcmp(&packet1, &packet2, sizeof(packet1)) == 0);

        memset(&packet2, 0, sizeof(packet2));
        mavlink_msg_to_send_buffer(buffer, &msg);
        for (i=0; i<mavlink_msg_get_send_buffer_length(&msg); i++) {
            comm_send_ch(MAVLINK_COMM_0, buffer[i]);
        }
    mavlink_msg_set_motor_duty_decode(last_msg, &packet2);
        MAVLINK_ASSERT(memcmp(&packet1, &packet2, sizeof(packet1)) == 0);
        
        memset(&packet2, 0, sizeof(packet2));
    mavlink_msg_set_motor_duty_send(MAVLINK_COMM_1 , packet1.duty );
    mavlink_msg_set_motor_duty_decode(last_msg, &packet2);
        MAVLINK_ASSERT(memcmp(&packet1, &packet2, sizeof(packet1)) == 0);
}

static void mavlink_test_set_motor_speed(uint8_t system_id, uint8_t component_id, mavlink_message_t *last_msg)
{
#ifdef MAVLINK_STATUS_FLAG_OUT_MAVLINK1
    mavlink_status_t *status = mavlink_get_channel_status(MAVLINK_COMM_0);
        if ((status->flags & MAVLINK_STATUS_FLAG_OUT_MAVLINK1) && MAVLINK_MSG_ID_SET_MOTOR_SPEED >= 256) {
            return;
        }
#endif
    mavlink_message_t msg;
        uint8_t buffer[MAVLINK_MAX_PACKET_LEN];
        uint16_t i;
    mavlink_set_motor_speed_t packet_in = {
        17.0
    };
    mavlink_set_motor_speed_t packet1, packet2;
        memset(&packet1, 0, sizeof(packet1));
        packet1.speed = packet_in.speed;
        
        
#ifdef MAVLINK_STATUS_FLAG_OUT_MAVLINK1
        if (status->flags & MAVLINK_STATUS_FLAG_OUT_MAVLINK1) {
           // cope with extensions
           memset(MAVLINK_MSG_ID_SET_MOTOR_SPEED_MIN_LEN + (char *)&packet1, 0, sizeof(packet1)-MAVLINK_MSG_ID_SET_MOTOR_SPEED_MIN_LEN);
        }
#endif
        memset(&packet2, 0, sizeof(packet2));
    mavlink_msg_set_motor_speed_encode(system_id, component_id, &msg, &packet1);
    mavlink_msg_set_motor_speed_decode(&msg, &packet2);
        MAVLINK_ASSERT(memcmp(&packet1, &packet2, sizeof(packet1)) == 0);

        memset(&packet2, 0, sizeof(packet2));
    mavlink_msg_set_motor_speed_pack(system_id, component_id, &msg , packet1.speed );
    mavlink_msg_set_motor_speed_decode(&msg, &packet2);
        MAVLINK_ASSERT(memcmp(&packet1, &packet2, sizeof(packet1)) == 0);

        memset(&packet2, 0, sizeof(packet2));
    mavlink_msg_set_motor_speed_pack_chan(system_id, component_id, MAVLINK_COMM_0, &msg , packet1.speed );
    mavlink_msg_set_motor_speed_decode(&msg, &packet2);
        MAVLINK_ASSERT(memcmp(&packet1, &packet2, sizeof(packet1)) == 0);

        memset(&packet2, 0, sizeof(packet2));
        mavlink_msg_to_send_buffer(buffer, &msg);
        for (i=0; i<mavlink_msg_get_send_buffer_length(&msg); i++) {
            comm_send_ch(MAVLINK_COMM_0, buffer[i]);
        }
    mavlink_msg_set_motor_speed_decode(last_msg, &packet2);
        MAVLINK_ASSERT(memcmp(&packet1, &packet2, sizeof(packet1)) == 0);
        
        memset(&packet2, 0, sizeof(packet2));
    mavlink_msg_set_motor_speed_send(MAVLINK_COMM_1 , packet1.speed );
    mavlink_msg_set_motor_speed_decode(last_msg, &packet2);
        MAVLINK_ASSERT(memcmp(&packet1, &packet2, sizeof(packet1)) == 0);
}

static void mavlink_test_device_state(uint8_t system_id, uint8_t component_id, mavlink_message_t *last_msg)
{
#ifdef MAVLINK_STATUS_FLAG_OUT_MAVLINK1
    mavlink_status_t *status = mavlink_get_channel_status(MAVLINK_COMM_0);
        if ((status->flags & MAVLINK_STATUS_FLAG_OUT_MAVLINK1) && MAVLINK_MSG_ID_DEVICE_STATE >= 256) {
            return;
        }
#endif
    mavlink_message_t msg;
        uint8_t buffer[MAVLINK_MAX_PACKET_LEN];
        uint16_t i;
    mavlink_device_state_t packet_in = {
        17.0,45.0,73.0,17859,17963,18067,18171,18275,18379,77
    };
    mavlink_device_state_t packet1, packet2;
        memset(&packet1, 0, sizeof(packet1));
        packet1.apd_voltage_targ = packet_in.apd_voltage_targ;
        packet1.apd_voltage_curr = packet_in.apd_voltage_curr;
        packet1.las_voltage = packet_in.las_voltage;
        packet1.pwm_value = packet_in.pwm_value;
        packet1.voltage_mv = packet_in.voltage_mv;
        packet1.raw_tof_value = packet_in.raw_tof_value;
        packet1.raw_tof_width_value = packet_in.raw_tof_width_value;
        packet1.distance = packet_in.distance;
        packet1.state = packet_in.state;
        packet1.pwm_state = packet_in.pwm_state;
        
        
#ifdef MAVLINK_STATUS_FLAG_OUT_MAVLINK1
        if (status->flags & MAVLINK_STATUS_FLAG_OUT_MAVLINK1) {
           // cope with extensions
           memset(MAVLINK_MSG_ID_DEVICE_STATE_MIN_LEN + (char *)&packet1, 0, sizeof(packet1)-MAVLINK_MSG_ID_DEVICE_STATE_MIN_LEN);
        }
#endif
        memset(&packet2, 0, sizeof(packet2));
    mavlink_msg_device_state_encode(system_id, component_id, &msg, &packet1);
    mavlink_msg_device_state_decode(&msg, &packet2);
        MAVLINK_ASSERT(memcmp(&packet1, &packet2, sizeof(packet1)) == 0);

        memset(&packet2, 0, sizeof(packet2));
    mavlink_msg_device_state_pack(system_id, component_id, &msg , packet1.pwm_value , packet1.pwm_state , packet1.apd_voltage_targ , packet1.apd_voltage_curr , packet1.las_voltage , packet1.voltage_mv , packet1.raw_tof_value , packet1.raw_tof_width_value , packet1.distance , packet1.state );
    mavlink_msg_device_state_decode(&msg, &packet2);
        MAVLINK_ASSERT(memcmp(&packet1, &packet2, sizeof(packet1)) == 0);

        memset(&packet2, 0, sizeof(packet2));
    mavlink_msg_device_state_pack_chan(system_id, component_id, MAVLINK_COMM_0, &msg , packet1.pwm_value , packet1.pwm_state , packet1.apd_voltage_targ , packet1.apd_voltage_curr , packet1.las_voltage , packet1.voltage_mv , packet1.raw_tof_value , packet1.raw_tof_width_value , packet1.distance , packet1.state );
    mavlink_msg_device_state_decode(&msg, &packet2);
        MAVLINK_ASSERT(memcmp(&packet1, &packet2, sizeof(packet1)) == 0);

        memset(&packet2, 0, sizeof(packet2));
        mavlink_msg_to_send_buffer(buffer, &msg);
        for (i=0; i<mavlink_msg_get_send_buffer_length(&msg); i++) {
            comm_send_ch(MAVLINK_COMM_0, buffer[i]);
        }
    mavlink_msg_device_state_decode(last_msg, &packet2);
        MAVLINK_ASSERT(memcmp(&packet1, &packet2, sizeof(packet1)) == 0);
        
        memset(&packet2, 0, sizeof(packet2));
    mavlink_msg_device_state_send(MAVLINK_COMM_1 , packet1.pwm_value , packet1.pwm_state , packet1.apd_voltage_targ , packet1.apd_voltage_curr , packet1.las_voltage , packet1.voltage_mv , packet1.raw_tof_value , packet1.raw_tof_width_value , packet1.distance , packet1.state );
    mavlink_msg_device_state_decode(last_msg, &packet2);
        MAVLINK_ASSERT(memcmp(&packet1, &packet2, sizeof(packet1)) == 0);
}

static void mavlink_test_motor_state(uint8_t system_id, uint8_t component_id, mavlink_message_t *last_msg)
{
#ifdef MAVLINK_STATUS_FLAG_OUT_MAVLINK1
    mavlink_status_t *status = mavlink_get_channel_status(MAVLINK_COMM_0);
        if ((status->flags & MAVLINK_STATUS_FLAG_OUT_MAVLINK1) && MAVLINK_MSG_ID_MOTOR_STATE >= 256) {
            return;
        }
#endif
    mavlink_message_t msg;
        uint8_t buffer[MAVLINK_MAX_PACKET_LEN];
        uint16_t i;
    mavlink_motor_state_t packet_in = {
        17.0,45.0,17651,17755,17859
    };
    mavlink_motor_state_t packet1, packet2;
        memset(&packet1, 0, sizeof(packet1));
        packet1.motor_speed = packet_in.motor_speed;
        packet1.setted_motor_speed = packet_in.setted_motor_speed;
        packet1.pwm_duty = packet_in.pwm_duty;
        packet1.setted_pwm_duty = packet_in.setted_pwm_duty;
        packet1.state = packet_in.state;
        
        
#ifdef MAVLINK_STATUS_FLAG_OUT_MAVLINK1
        if (status->flags & MAVLINK_STATUS_FLAG_OUT_MAVLINK1) {
           // cope with extensions
           memset(MAVLINK_MSG_ID_MOTOR_STATE_MIN_LEN + (char *)&packet1, 0, sizeof(packet1)-MAVLINK_MSG_ID_MOTOR_STATE_MIN_LEN);
        }
#endif
        memset(&packet2, 0, sizeof(packet2));
    mavlink_msg_motor_state_encode(system_id, component_id, &msg, &packet1);
    mavlink_msg_motor_state_decode(&msg, &packet2);
        MAVLINK_ASSERT(memcmp(&packet1, &packet2, sizeof(packet1)) == 0);

        memset(&packet2, 0, sizeof(packet2));
    mavlink_msg_motor_state_pack(system_id, component_id, &msg , packet1.pwm_duty , packet1.motor_speed , packet1.setted_pwm_duty , packet1.setted_motor_speed , packet1.state );
    mavlink_msg_motor_state_decode(&msg, &packet2);
        MAVLINK_ASSERT(memcmp(&packet1, &packet2, sizeof(packet1)) == 0);

        memset(&packet2, 0, sizeof(packet2));
    mavlink_msg_motor_state_pack_chan(system_id, component_id, MAVLINK_COMM_0, &msg , packet1.pwm_duty , packet1.motor_speed , packet1.setted_pwm_duty , packet1.setted_motor_speed , packet1.state );
    mavlink_msg_motor_state_decode(&msg, &packet2);
        MAVLINK_ASSERT(memcmp(&packet1, &packet2, sizeof(packet1)) == 0);

        memset(&packet2, 0, sizeof(packet2));
        mavlink_msg_to_send_buffer(buffer, &msg);
        for (i=0; i<mavlink_msg_get_send_buffer_length(&msg); i++) {
            comm_send_ch(MAVLINK_COMM_0, buffer[i]);
        }
    mavlink_msg_motor_state_decode(last_msg, &packet2);
        MAVLINK_ASSERT(memcmp(&packet1, &packet2, sizeof(packet1)) == 0);
        
        memset(&packet2, 0, sizeof(packet2));
    mavlink_msg_motor_state_send(MAVLINK_COMM_1 , packet1.pwm_duty , packet1.motor_speed , packet1.setted_pwm_duty , packet1.setted_motor_speed , packet1.state );
    mavlink_msg_motor_state_decode(last_msg, &packet2);
        MAVLINK_ASSERT(memcmp(&packet1, &packet2, sizeof(packet1)) == 0);
}

static void mavlink_test_mavlink_tof(uint8_t system_id, uint8_t component_id, mavlink_message_t *last_msg)
{
    mavlink_test_data_request(system_id, component_id, last_msg);
    mavlink_test_device_command(system_id, component_id, last_msg);
    mavlink_test_long_packet(system_id, component_id, last_msg);
    mavlink_test_set_apd_voltage(system_id, component_id, last_msg);
    mavlink_test_set_laser_voltage(system_id, component_id, last_msg);
    mavlink_test_set_comp_threshold(system_id, component_id, last_msg);
    mavlink_test_start_batch_measurement(system_id, component_id, last_msg);
    mavlink_test_start_corr_batch_measurement(system_id, component_id, last_msg);
    mavlink_test_set_width_corr_coeff(system_id, component_id, last_msg);
    mavlink_test_set_ref_offset(system_id, component_id, last_msg);
    mavlink_test_set_motor_duty(system_id, component_id, last_msg);
    mavlink_test_set_motor_speed(system_id, component_id, last_msg);
    mavlink_test_device_state(system_id, component_id, last_msg);
    mavlink_test_motor_state(system_id, component_id, last_msg);
}

#ifdef __cplusplus
}
#endif // __cplusplus
#endif // MAVLINK_TOF_TESTSUITE_H
