iliasam/OpenTOFLidar/ROS/open_tof_lidar/include/mavlink_tof/version.h

/** @file
 *  @brief MAVLink comm protocol built from mavlink_tof.xml
 *  @see http://mavlink.org
 */
#pragma once
 
#ifndef MAVLINK_VERSION_H
#define MAVLINK_VERSION_H

#define MAVLINK_BUILD_DATE "Thu Jan 09 2020"
#define MAVLINK_WIRE_PROTOCOL_VERSION "2.0"
#define MAVLINK_MAX_DIALECT_PAYLOAD_SIZE 208
 
#endif // MAVLINK_VERSION_H
