iliasam/OpenTOFLidar/(commit log)

2020-01-03 Added sending state, reset command.
    [main.c, main.h, tdc_driver.c]
2020-01-05 Added working with encoder and motor controlling.
2020-01-06 Switched to uart DMA tx mode. Added laser lock if there is motor error.
    [capture_controlling.c, config.h, dist_measurement.c, encoder_processing.c, hardware.c, main.c, main.h, motor_controlling.c]
2020-01-08 Added disabling motor in not scaning mode.
2020-01-08 Added utility for lidar testing.
    [result_2019-12-31 18-42-27.csv]
2020-01-09 Added measuring distance to a Referece Plate during scanning. Some refactoring.
2020-01-10 Added ROS driver files.
2020-01-12 Added ability to set APD voltage in LidarScanningTest
2020-01-12 Added PCB project files.
    [PCB1.PcbDoc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]
2020-01-12 Added PCB BOM and schematic picture.
    [PCB1.PcbDoc, Sheet1.SchDoc, TOF_rangefinder_BOM.xls]
2020-01-12 Updated schematic, PCB_BOM, added total BOM.
    [LidarTotalBOM.xlsx, TOF_rangefinder_BOM.xls, TOF_rangefinder_BOM.xlsx]
2020-01-12 Added 3D pard - mirror_holder.
    [mirror_holder.stl]
2020-01-14 Updated BOM.
    [LidarTotalBOM.xlsx, TOF_rangefinder.PrjPcb]
2020-01-19 Added mode for 0.5 deg angular resolution.
    [PCB1.PcbDoc, TOF_rangefinder.PrjPcb]
2020-01-19 Added 720 points support for ROS driver.
2020-02-08 Added PCB2020 code features.
    [result_2020-02-07 22-12-48.csv]
2020-02-09 Added PCB v1b project.
    [PCB1.PcbDoc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]
2020-02-10 Added histograms and updated BOM.
    [LidarTotalBOM.xlsx]
2020-02-14 Added several images.
    [mirror_drawing.dwg]
2020-02-15 Added PCB 02.2020 - v4B - actual PCB
    [PCB1.PcbDoc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]
2020-02-15 Removed useless PCB.
    [PCB1.PcbDoc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]
2020-02-22 Some pictures added, some typos removed.
    [Drawing_motor_plate.dxf, LidarTotalBOM.xlsx]
2020-02-24 Some improvements.
    [PCB1.PcbDoc, TOF_rangefinder.PrjPcb]
2020-03-01 Removed mistake in schematic. Some small improvements.
    [PCB1.PcbDoc, Sheet1.SchDoc]
2020-03-07 Upated PCB.
    [PCB1.PcbDoc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]
2020-03-13 Removed wrong IR filter from BOM.
    [LidarTotalBOM.xlsx]
2020-03-24 Changed X1 quartz value.
    [Sheet1.SchDoc, TOF_rangefinder_v4b.xlsx]
2020-09-11 Small documentation changes.
    [TOF_rangefinder_v4b.xlsx]
2021-01-03 Changed mavlink_xml, added ability to set TDC bin length. Non scanning firmware is correctly displaying wrong measurements during batch measurement. Small refactoring. Changed "LidarTestingUtility" -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
    [capture_controlling.c, config.h, dist_measurement.c, main.h, nvram.c, nvram.h, spi_driver.c, spi_driver.h]
2021-04-10 Changed BOM
    [TOF_rangefinder_v4b.xlsx]
2021-08-07 Updated PCB assembly image.
2021-08-12 Added current measurements pictures.
2021-08-19 Updated BOM notice.
    [TOF_rangefinder_v4b.xlsx]
2021-08-21 Added image, updated BOM.
    [LidarTotalBOM.xlsx]
2022-02-13 Updated BOM
    [TOF_rangefinder_v4b.xlsx]
2022-02-21 Removed mistake in code.
    [config.h]
2022-04-03 Renamed BOM.
    [BOM_TOF_rangefinder_v4b.xlsx]
2022-04-07 Added oscillscope images of probe comparison.
2022-05-09 Updated BOM list.
    [LidarTotalBOM.xlsx]
2023-07-06 Moved ENCODER_TIMEOUT_MS to the config.
2023-07-28 Changed R20 value.
    [BOM_TOF_rangefinder_v4b.xlsx, Sheet1.SchDoc]
2023-11-28 Added notes about ESD.
    [BOM_TOF_rangefinder_v4b.xlsx, LidarTotalBOM.xlsx]
2024-01-31 "dist_meas_zero_offset_bin" not is float value, so measuremennts are more stable. Added UART busy detection - marked bu special state flag. Improved utilities GUI.
2024-02-22 Added checks for BIN length. Changed distance 0->4 return value if TDC result is 0xFFFF. Return distance value 5 if calculation fail detected.
    [config.h, dist_measurement.c]
